buzsakilab/3d_print_designs/README.md

## Visit our website to learn more:
https://buzsakilab.github.io/3d_print_designs/
