buzsakilab/3d_print_designs/Rat_cap/README.md

# Rat cap (v8 / v8_v2_256)

Rat cap design for chronic silicon probe implantation in freely moving rats.

---

## Assembly

Assembly instructions are available in **`assembly_instructions_rat_cap_v8.pdf`** and in this video:  
1. https://www.youtube.com/watch?v=SgM9TPhbf_Y&feature=youtu.be

---

## Printing notes

- The provided `.stl` files are optimized for **Formlabs Form 2** using **Grey v4 / Clear v4 resin**.  
- For other printers and/or resins, minor modifications may be necessary.

---

## Versions included

### **v8**
Files:
- `rat_cap_base_v8`
- `rat_cap_left_wall_v8`
- `rat_cap_right_wall_v8`
- `rat_cap_top_v8`

### **v8_v2_256**
Files:
- `rat_cap_base_v8_v2_256`
- `rat_cap_left_wall_v8_v2_256`
- `rat_cap_right_wall_v8_v2_256`

**Key difference:** v8_v2_256 has a wider base, providing more space for multi-probe implants.

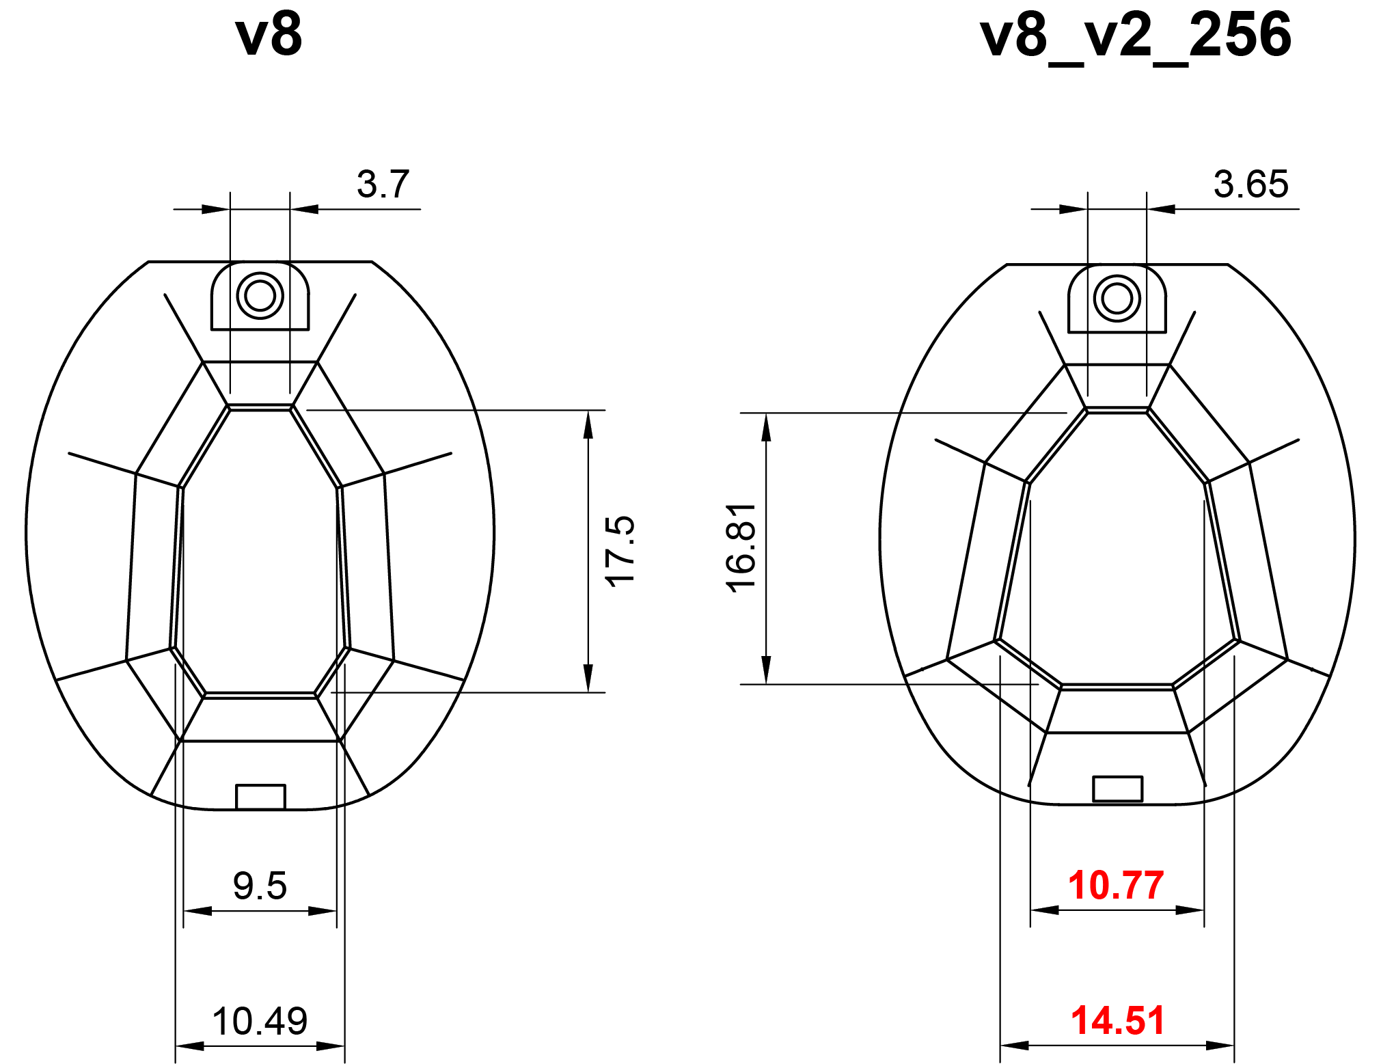
[picture p3: Rat_cap/v8_v2_256/v8_to_v8_v2_256.png]
v8 vs v8_v2_256


---

## Weight

- Fully assembled **v8 cap weight:** **9.39 g**

---

## Citation

If you use this design, please cite:

**Metal microdrive and head cap system for silicon probe recovery in freely moving rodent**  
Mihály Vöröslakos, Peter C. Petersen, Balázs Vöröslakos, György Buzsáki  
https://elifesciences.org/articles/65859

---

## License

Distributed under the **GNU GPLv3** license.
