buzsakilab/3d_print_designs/Rat_cap/README.txt

Rat cap design for silicon probe implantation.

Assembly instructions can be found in the assembly_instructions_rat_cap_v8.pdf file or at this link:
1. https://www.youtube.com/watch?v=SgM9TPhbf_Y&feature=youtu.be

The .stl files are optimized for Formlabs Form2 printer and Grey-v4/Clear-v4 Resin. For other printers and/or resins, some modifications may be necessary.

2 versions are made available here:
v8: rat_cap_base_v8, rat_cap_left_wall_v8, rat_cap_right_wall_v8, rat_cap_top_v8
v8_v2_256: rat_cap_base_v8_v2_256, rat_cap_left_wall_v8_v2_256, rat_cap_right_wall_v8_v2_256

v8 vs v8_v2_256 base comparison

The fully assembled v8 cap weighs 9.39g.

If you use this design, please cite our paper:
Metal microdrive and head cap system for silicon probe recovery in freely moving rodent
Mihály Vöröslakos, Peter C. Petersen, Balázs Vöröslakos, György Buzsáki
https://elifesciences.org/articles/65859

The designs are desitributed under GNU GPLv3 license.
