buzsakilab/3d_print_designs/Rat_hat_base/README.txt

Rat hat base for silicon probe implantation.

Assembly instructions can be found in the Assembly_instructions_rat_base_plate.pdf file. 

The .stl files are optimized for Formlabs Form2 printer and Grey-v4/Clear-v4 Resin. For other printers and/or resins, some modifications may be necessary.

1 version is made available here: hat base for rats.stl

If you use this design, please cite our papers:
Bioprotocol
Peter Christian Petersen,Gyorgy Buzsaki; Cooling of Medial Septum Reveals Theta Phase LagCoordination of Hippocampal Cell Assemblies (Neuron, 2020)

The designs are distributed under GNU GPLv3 license.
