buzsakilab/3d_print_designs/Mouse_cap/README.txt

Mouse cap design for silicon probe implantation.

Assembly instructions can be found in the assembly_instructions_mouse_hat_L11.5mm_W10.00mm_v12.pdf file or at this link:
https://www.youtube.com/watch?v=_MYBLJf-178&feature=youtu.be

The .stl files are optimized for Formlabs Form2 printer and Grey-v4/Clear-v4 Resin. For other printers and/or resins, some modifications may be necessary.

1 version is made available here:
v12: mouse_base_v12, leftWall_v12, rightWall_v12, mouse_hat_copperMesh_cutOut_v02

The fully assembled cap weighs 2.2 g.

If you use this design, please cite our paper:
Metal microdrive and head cap system for silicon probe recovery in freely moving rodent
Mihály Vöröslakos, Peter C. Petersen, Balázs Vöröslakos, György Buzsáki
bioRxiv 2020.12.20.423655; doi: https://doi.org/10.1101/2020.12.20.423655 

The designs are desitributed under GNU GPLv3 license.
