buzsakilab/3d_print_designs/Mouse_cap_with_Head_fixation_capabilities/Kopf_adapter/README.md

# Mouse Cap Design for Silicon Probe Implantation and Head-Fixation

Modified adapter for Kopf Stereotactic Frames. **You need to maintain left and right orientation.**

## Files

**v01:**
- `misi_post_clamp_08_left`
- `misi_post_clamp_08_right`

## License

The designs are distributed under the **GNU GPLv3** license.
