buzsakilab/3d_print_designs/Mouse_head_fixation/spring_multiAngle/README.txt

Mouse head-fixed baseplate design for head-fixation.

The .stl files are optimized for Formlabs Form4 printer and Grey-v5/Clear-v5 Resin. For other printers and/or resins, some modifications may be necessary.

1 version is made available here:
v03: base_cover_spring_multiAngle_v_03, base_holder_spring_multiAngle_v_03, mouse_base_spring_multiAngle_v_03, screw_protector_spring_multiAngle_v_03, stereotax_attachment_spring_multiAngle_v_03

To learn more about the multi-angle alignment tool, read the documentation here: https://github.com/misiVoroslakos/3D_printed_designs/tree/main/Microdrives/Multi_angle_probe_alignment

If you use this design, please cite our paper:
Metal microdrive and head cap system for silicon probe recovery in freely moving rodent
Mihály Vöröslakos, Peter C. Petersen, Balázs Vöröslakos, György Buzsáki
https://elifesciences.org/articles/65859

The designs are desitributed under GNU GPLv3 license.
