buzsakilab/3d_print_designs/Rat_cap/v8_v2_256/README.md

Rat cap design for silicon probe implantation.

**Rat cap v8\_v2\_256 is wider providing more space for multi-probe implants.**

v8 vs v8_v2_256

The designs are desitributed under GNU GPLv3 license.
