buzsakilab/3d_print_designs/Rat_cap/v8/README.md

Rat cap design for silicon probe implantation.

The designs are desitributed under GNU GPLv3 license.
