buzsakilab/3d_print_designs/Microdrives/Metal_recoverable/README.txt

Microdrive designs for silicon probes.

**Assembly instructions**
Assembly instructions can be found in the assembly_instructions_metal_microdrive_v9.pdf file.

To purchase fully assembled drives, contact 3Dneuro (our partner in production) https://www.3dneuro.com/2021/04/23/new-metal-microdrive-in-collaboration-with-the-buzsaki-lab/.
The .step files are optimized for stainless steel 316L, 20 micrometer resolution using Proto Labs (https://www.protolabs.com/). Please see ordering_instructions.txt for more information. 
For other printers, materials or company, some modifications may be necessary.

1 version is made available here:
v9: shell base 3.6 x 4.7 mm (WxL); height: 15 mm; travel distance 7 mm

The .stl files are optimized for Formlabs Form2 printer and Grey-v4/Clear-v4 Resin. For other printers and/or resins, some modifications may be necessary.

1 version is made available here:
v9: stereotax attachment and drive holder.

If you use our designs, please cite our paper:
Metal microdrive and head cap system for silicon probe recovery in freely moving rodent 
Mihály Vöröslakos, Peter C. Petersen, Balázs Vöröslakos, György Buzsáki
doi: https://doi.org/10.1101/2020.12.20.423655 

The original idea of the drive is described in the following paper.

Micro-drive and headgear for chronic implant and recovery of optoelectronic probes Jinho Chung, Farnaz Sharif, Dajung Jung, Soyoun Kim & Sebastien Royer Scientific Reportsvolume 7, Article number: 2773 (2017) doi:10.1038/s41598-017-03340-5 https://www.nature.com/articles/s41598-017-03340-5

The designs are desitributed under GNU GPLv3 license.
