buzsakilab/3d_print_designs/Microdrives/Metal_prototype/README.txt

Microdrive designs for silicon probes.

The .stl files are optimized for Formlabs Form2 printer and Grey-v4/Clear-v4 Resin. For other printers and/or resins, some modifications may be necessary.

1 version is made available here:

This microdrive was modified based on Mihaly Voroslakos' design. Other version of this microdrive is available at https://github.com/buzsakilab/3d_print_designs/tree/master/Microdrives/Plastic_recoverable.

The original idea of the drive is described in the following paper.

Micro-drive and headgear for chronic implant and recovery of optoelectronic probes Jinho Chung, Farnaz Sharif, Dajung Jung, Soyoun Kim & Sebastien Royer Scientific Reportsvolume 7, Article number: 2773 (2017) doi:10.1038/s41598-017-03340-5 https://www.nature.com/articles/s41598-017-03340-5

The designs are distributed under GNU GPLv3 license.
