buzsakilab/3d_print_designs/Microdrives/Metal_recoverable/v10_long_arm/README.md

Metal microdrive designs for silicon probes (**v10 is not back compatible with previous versions**).

**Microdrive Shuttle for Rat surgeries**

Sometimes we need to reach deeper than 7 mm using a Neuropixels probe. **arm_v10_long** provides a solution to achieve this. 

Details on the issue and its implemented solution can be found [here](https://github.com/buzsakilab/3d_print_designs/blob/f796568ae8a014a6d27565d4a83c3a5d85d17292/Microdrives/Metal_recoverable/v10_long_arm/Long_arm_rats_NPX.pdf).

**ASSEMBLY**

Assembly instructions can be found in the **assembly_instructions_metal_microdrive_v10.pdf** file. Assembly video can be found here: https://www.youtube.com/watch?v=poEjWvFrr5g. 
Attaching Neuropixels probe (or any other silicon probe) video can be found here: https://www.youtube.com/watch?v=MpPdWJEo7Fo

**ORDERING**

The .step files are optimized for stainless steel 316L, 20 micrometer resolution (drive_v10) and aluminum AlSi10Mg, high resolution (arm_v10, arm_v10_long and base_v10) using Proto Labs (https://www.protolabs.com/). Please see *ordering_instructions.txt* for more information [here](https://github.com/buzsakilab/3d_print_designs/blob/3e0a6fe3e2badeac6823770685a77d362df59636/Microdrives/Metal_recoverable/Ordering_instructions.txt). 
For other printers, materials or company, some modifications may be necessary.

**PURCHASING fully assembled microdrives**

To purchase fully assembled drives, contact 3Dneuro (our partner in production) (https://www.3dneuro.com/).

**SPECIFICATIONS**

1 version is made available here:
v10: shell base 3.6 x 4.7 mm (WxL); height: 15 mm; travel distance 7 mm

The .stl files are optimized for Formlabs Form2 printer and Grey-v4/Clear-v4 Resin. For other printers and/or resins, some modifications may be necessary.

2 version is made available here:

v9: stereotax attachment and drive holder.
v10: stereotax attachment and drive holder.

**CITATION**

If you use our designs, please cite our paper:
Metal microdrive and head cap system for silicon probe recovery in freely moving rodent 
Mihály Vöröslakos, Peter C. Petersen, Balázs Vöröslakos, György Buzsáki https://doi.org/10.7554/eLife.65859

The original idea of the drive is described in the following paper.

Micro-drive and headgear for chronic implant and recovery of optoelectronic probes Jinho Chung, Farnaz Sharif, Dajung Jung, Soyoun Kim & Sebastien Royer Scientific Reportsvolume 7, Article number: 2773 (2017) doi:10.1038/s41598-017-03340-5 https://www.nature.com/articles/s41598-017-03340-5

Copyright 2018-2024 New York University. All Rights Reserved.
 
A license to use and copy these materials solely for your internal non-commercial research and evaluation purposes, without fee and without a signed licensing agreement, is hereby granted upon your download of the materials, through which you agree to the following: 1) the above copyright notice, this paragraph and the following three paragraphs will prominently appear in all internal copies and modifications; 2) no rights to sublicense or further distribute these materials are granted; 3) no rights to modify these materials are granted; and 4) no rights to assign this license are granted. Please contact NYU Technology Opportunities & Ventures at innovations@nyulangone.org for commercial licensing opportunities, or for further distribution, modification or license rights.

Created by M. Voroslakos and P. Petersen. 
 
IN NO EVENT SHALL NYU, OR THEIR EMPLOYEES, OFFICERS, AGENTS OR TRUSTEES  (COLLECTIVELY "NYU PARTIES") BE LIABLE TO ANY PARTY FOR DIRECT, INDIRECT, SPECIAL, INCIDENTAL, OR CONSEQUENTIAL DAMAGES OF ANY KIND, INCLUDING LOST PROFITS, ARISING OUT OF ANY CLAIM RESULTING FROM YOUR USE OF THESE MATERIALS, EVEN IF ANY OF NYU PARTIES HAS BEEN ADVISED OF THE POSSIBILITY OF SUCH CLAIM OR DAMAGE. 

NYU SPECIFICALLY DISCLAIMS ANY WARRANTIES OF ANY KIND REGARDING THESE MATERIALS, INCLUDING, BUT NOT LIMITED TO, NON-INFRINGEMENT, THE IMPLIED WARRANTIES OF MERCHANTABILITY AND FITNESS FOR A PARTICULAR PURPOSE, OR THE ACCURACY OR USEFULNESS, OR COMPLETENESS OF THE MATERIALS. THE MATERIALS ARE PROVIDED HEREUNDER ARE PROVIDED COMPLETELY "AS IS". NYU HAS NO OBLIGATION TO PROVIDE FURTHER DOCUMENTATION, MAINTENANCE, SUPPORT, UPDATES, ENHANCEMENTS, OR MODIFICATIONS.
