buzsakilab/3d_print_designs/docs/index.md

---
layout: default
title: Home
nav_order: 1
has_children: false
---

# Metal microdrive and head cap system
{: .no_toc}
{: .fs-9 }

We have designed a metal microdrive and head cap systems for extracellular recordings in freely moving rodents, which make sillicon probes recoverable and reusable.
{: .fs-6 .fw-300}

[Get started now](#getting-started){: .btn .btn-primary .fs-5 .mb-4 .mb-md-0 .mr-2} [View code on GitHub](https://github.com/buzsakilab/3d_print_designs){: .btn .fs-5 .mb-4 .mb-md-0}

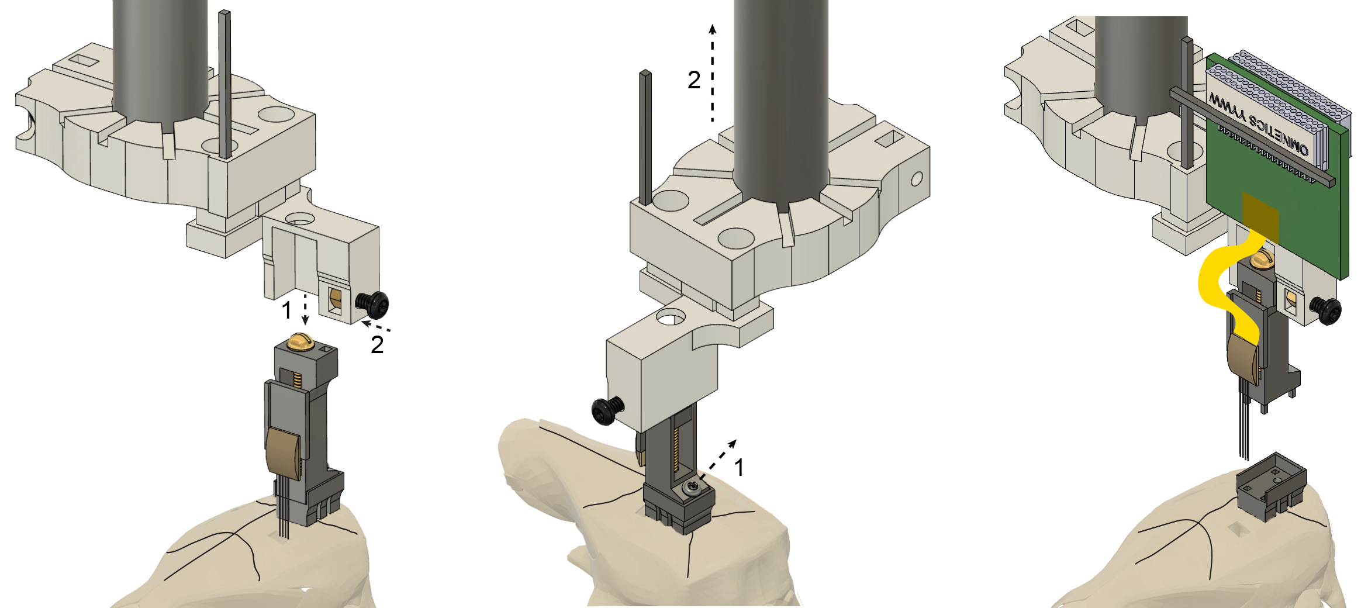
[picture p4: docs/images/recoverable_microdrive.jpg]
Recoverable microdrive


### Summary
High-yield electrophysiological extracellular recording in freely moving rodents provides a unique window into the temporal dynamics of neural circuits. Recording from unrestrained animals is critical to investigate brain activity during natural behaviors. The use and implantation of high-channel-count silicon probes represent the largest cost and experimental complexity associated with such recordings making a recoverable and reusable system desirable. To address this, we have designed and tested a novel 3D printed head-gear system for freely moving mice and rats. The system consists of a recoverable microdrive printed in stainless steel and a plastic head cap system, allowing researchers to reuse the silicon probes with ease, decreasing the effective cost, and the experimental effort and complexity. The cap designs are modular and provide structural protection and electrical shielding to the implanted hardware and electronics. We provide detailed procedural instructions allowing researchers to adapt and flexibly modify the head-gear system.

## Getting started
We have created dedicated pages for the three elements below with detailed procedural instructions and links to resources for each of them. 

[Microdrives]({{"/microdrives/microdrives/"|absolute_url}}){: .btn .fs-5 .mb-4 .mb-md-0 .mr-4} [Rat cap]({{"/capsystems/rat_cap/"|absolute_url}}){: .btn .fs-5 .mb-4 .mb-md-0 .mr-4} [Mouse cap]({{"/capsystems/mouse_cap/"|absolute_url}}){: .btn .fs-5 .mb-4 .mb-md-0 .mr-4}

## Support
Please use the [GitHub issues system](https://github.com/buzsakilab/3d_print_designs/issues) for reporting bugs, enhancement requests or general questions.

## Citing our 3D designs in research and publications
If you use our designs, please cite our paper: 
Metal microdrive and head cap system for silicon probe recovery in freely moving rodent Mihály Vöröslakos, Peter C. Petersen, Balázs Vöröslakos, György Buzsáki doi: [doi.org/10.1101/2020.12.20.423655](https://doi.org/10.1101/2020.12.20.423655)
