buzsakilab/3d_print_designs/docs/capsystems/mouse_cap.md

---
layout: default
title: Mouse cap
parent: Cap systems
nav_order: 1
---

# Mouse cap system
{: .no_toc}
Mouse cap design for silicon probe implantation. The fully assembled cap weighs 2.2 g.

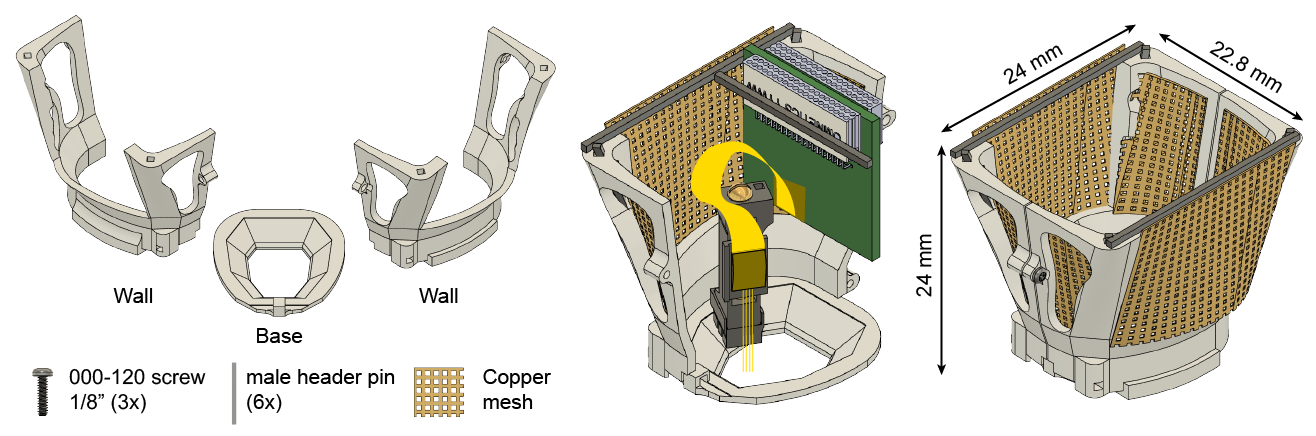
[picture p5: docs/images/mouse_cap.png]
Mouse cap system


## Table of contents
{: .no_toc .text-delta }

1. TOC
{:toc}

## Printing and assembly instructions 
Download stl files from our [GitHub repository](https://github.com/buzsakilab/3d_print_designs/tree/master/Mouse_cap). The stl files are optimized for Formlabs Form2 printer and Grey-v4/Clear-v4 Resin. For other printers and/or resins, some modifications may be necessary.

See video below. Detailed assembly instructions are available for the [cap system](https://github.com/buzsakilab/3d_print_designs/raw/master/Mouse_cap/assembly_instructions_mouse_hat_L11.5mm_W10.00mm_v12.pdf).

<video width="100%" height="auto" controls="controls">
  <source src="https://buzsakilab.com/3d_print_designs/Figure2-video1.mp4" type="video/mp4">
</video>

The assembly video is also available on [youtube](https://www.youtube.com/watch?v=_MYBLJf-178).

## Materials

__Mouse cap v11__

| Qty | Name | Vendor | Item number/Link |
|-----|---|---|---|
| 3 | 000-120 screw 1/8" | McMaster | [96710A001](https://www.mcmaster.com/96710A001/) | 
| 1 | male header pin | DigiKey | [SAM1067-40-ND](https://www.digikey.com/products/en?keywords=SAM1067-40-ND) | 
| | copper mesh | Dexmet | 3CU6-050FA | 
| 1 | Coban | 3M | [7100219100](https://www.3m.com/3M/en_US/company-us/all-3m-products/~/3M-Coban-Self-Adherent-Wrap-1583N-Neon-Rainbow-Pack-3-Inches-x-5-Yards-12-Bags-Case/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) | 

__Additional tools__

| Qty | Name | Vendor | Item number/Link | Notes |
|-----|---|---|---|---|
| 1 | T1 screwdriver | McMaster | [52995A3](https://www.mcmaster.com/52995a31) | 
| 1 | 000-120 tap | McMaster | [2504A15](https://www.mcmaster.com/2504a15)  | Or similar tap. | 

__Additional chemicals__

| Qty | Name | Vendor | Item number/Link | Notes |
|-----|---|---|---|---|
| 1 | Cyanoacrylate glue | Loctite | [45208](https://www.loctiteproducts.com/en/products/fix/super-glue/loctite_super_glueultragelcontrol.html) | Gel control | 
| 1 | Unifast Trad Ivory | Pearson Dental | G05-1224 | 
| 1 | Unifast Trad Liquid | Pearson Dental | G05-0037 | 
| 1 | Soldering iron | Stannol | 574104 | 
| 1 | Solder Paste | Quick Chip | 23271700 | 

## Stl files
All stl files are available for download from our [GitHub repository](https://github.com/buzsakilab/3d_print_designs/tree/master/Mouse_cap/stl_files). 

### Mouse cap base

<script src="https://embed.github.com/view/3d/buzsakilab/3d_print_designs/master/Mouse_cap/stl_files/mouse_base_v12_L11.5mm_W10.00mm.stl"></script>

### Left wall

<script src="https://embed.github.com/view/3d/buzsakilab/3d_print_designs/master/Mouse_cap/stl_files/left_wall_v12_L11.5mm_W10.00mm.stl"></script>

### Right wall

<script src="https://embed.github.com/view/3d/buzsakilab/3d_print_designs/master/Mouse_cap/stl_files/right_wall_v12_L11.5mm_W10.00mm.stl"></script>

### Copper mesh cut-out

<script src="https://embed.github.com/view/3d/buzsakilab/3d_print_designs/master/Mouse_cap/stl_files/mouse_hat_copperMesh_cutOut_v02.stl"></script>

## Citations
If you use our designs, please cite our paper: 
Metal microdrive and head cap system for silicon probe recovery in freely moving rodent Mihály Vöröslakos, Peter C. Petersen, Balázs Vöröslakos, György Buzsáki doi: [doi.org/10.1101/2020.12.20.423655](https://doi.org/10.1101/2020.12.20.423655)

The designs are distributed under GNU GPLv3 license.
