buzsakilab/3d_print_designs/docs/capsystems/rat_cap.md

---
layout: default
title: Rat cap
parent: Cap systems
nav_order: 2
---

# Rat cap system
{: .no_toc}
Rat cap design for silicon probe implantation. The fully assembled cap weighs 9.39g.

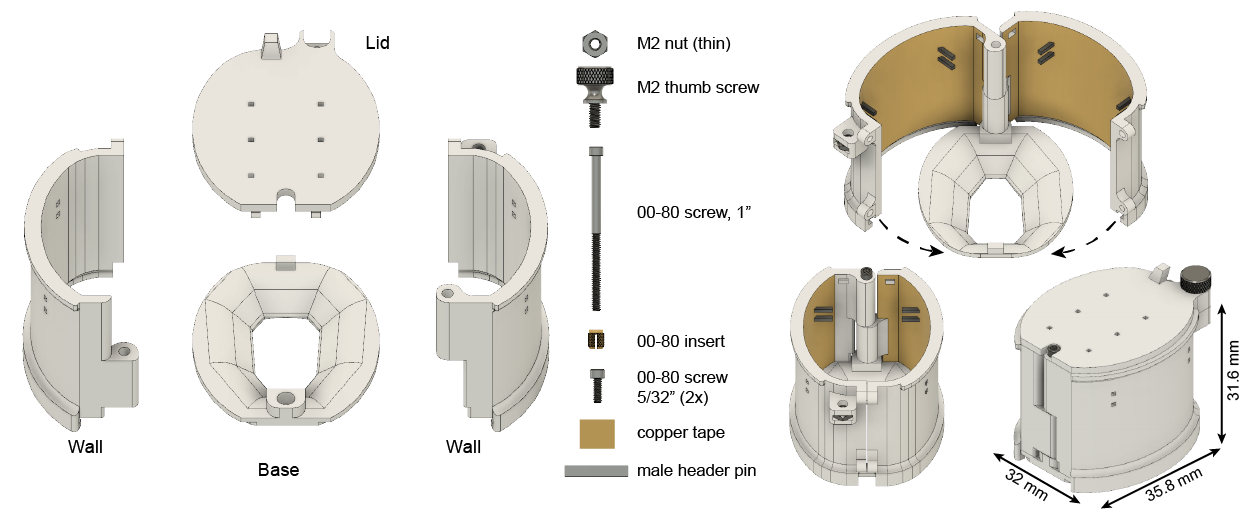
[picture p6: docs/images/rat_cap.png]
Rat cap


## Table of contents
{: .no_toc .text-delta }

1. TOC
{:toc}

## Printing and assembly instructions 
Download stl files from our [GitHub repository](https://github.com/buzsakilab/3d_print_designs/tree/master/Rat_cap). The .stl files are optimized for Formlabs Form2 printer and Grey-v4/Clear-v4 Resin. For other printers and/or resins, some modifications may be necessary.

See video below. Detailed assembly instructions are available for the [cap system](https://github.com/buzsakilab/3d_print_designs/raw/master/Rat_cap/assembly_instructions_rat_cap_v8.pdf).

<video width="100%" height="auto" controls="controls">
  <source src="https://buzsakilab.com/3d_print_designs/Figure3-video1.mp4" type="video/mp4">
</video>

The assembly video is also available on [youtube](https://www.youtube.com/watch?v=SgM9TPhbf_Y).

## Materials

__Rat cap v08__

| Qty | Name | Vendor | Item number/Link |
|-----|---|---|---|
| 1 | 00-80 screw 1" | McMaster | [92196A060](https://www.mcmaster.com/92196a060) | 
| 1 | 00-80 brass insert | McMaster | [92395A109](https://www.mcmaster.com/92395a109) | 
| 2 | 00-80 screw 5/32"  | McMaster | [92196A053](https://www.mcmaster.com/92196a053) | 
| 1 | male header pin | DigiKey | [SAM1067-40-ND](https://www.digikey.com/products/en?keywords=SAM1067-40-ND) | 
| 1 | copper tape | McMaster | [76555A724](https://www.mcmaster.com/76555A724/) | 
| 1 | Coban | 3M | [7100219100](https://www.3m.com/3M/en_US/company-us/all-3m-products/~/3M-Coban-Self-Adherent-Wrap-1583N-Neon-Rainbow-Pack-3-Inches-x-5-Yards-12-Bags-Case/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) | 

__Optional lid (to close cap for extended period of time)__

| Qty | Name | Vendor | Item number/Link |
|-----|---|---|---|
| 1 | M2x0.4 Thumb screw | McMaster | [99607A256](https://www.mcmaster.com/99607a256) | 
| 1 | M2x0.4 THIN nut | McMaster | [93935A305](https://www.mcmaster.com/93935a305) | 

__Additional tools__

| Qty | Name | Vendor | Item number/Link |
|-----|---|---|---|
| 1 | 00-80 tap | McMaster | [2523A461](https://www.mcmaster.com/2523a461) | 
| 1 | 0.05" hex key | 

## Stl files
All stl files are available for download from our [GitHub repository](https://github.com/buzsakilab/3d_print_designs/tree/master/Rat_cap/stl_files). 

### Rat cap base

<script src="https://embed.github.com/view/3d/buzsakilab/3d_print_designs/master/Rat_cap/stl_files/rat_cap_base_v8.stl"></script>

### Left wall

<script src="https://embed.github.com/view/3d/buzsakilab/3d_print_designs/master/Rat_cap/stl_files/rat_cap_left_wall_v8.stl"></script>

### Right wall

<script src="https://embed.github.com/view/3d/buzsakilab/3d_print_designs/master/Rat_cap/stl_files/rat_cap_right_wall_v8.stl"></script>

### Lid

<script src="https://embed.github.com/view/3d/buzsakilab/3d_print_designs/master/Rat_cap/stl_files/rat_cap_top_v8.stl"></script>

## Citations
If you use our designs, please cite our paper: 
Metal microdrive and head cap system for silicon probe recovery in freely moving rodent Mihály Vöröslakos, Peter C. Petersen, Balázs Vöröslakos, György Buzsáki doi: [doi.org/10.1101/2020.12.20.423655](https://doi.org/10.1101/2020.12.20.423655)

The designs are distributed under GNU GPLv3 license.
