buzsakilab/3d_print_designs/docs/microdrives/plastic-microdrive.md

---
layout: default
title: Plastic microdrive
parent: Microdrives
nav_order: 2
---

# Recoverable plastic microdrive
{: .no_toc}
Plastic microdrive for silicon probe recordings. Below are necessary design files and detailed instructions for printing and assembling the microdrives yourself. height: 16 mm; travel distance 4.8 mm

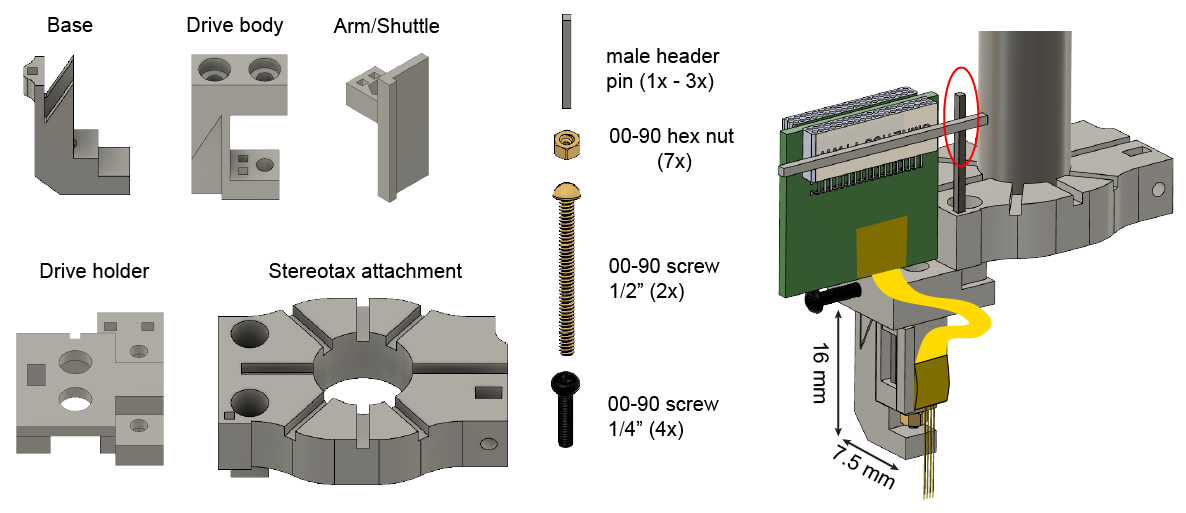
[picture p7: docs/images/plastic_microdrives.png]
Recoverable plastic microdrive


## Table of contents
{: .no_toc .text-delta }

1. TOC
{:toc}

## Printing and assembly instructions 
Download stl files from our [GitHub repository](https://github.com/buzsakilab/3d_print_designs/tree/master/Microdrives/Plastic_recoverable). The stl files are optimized for Formlabs Form2 printer and Grey-v4/Clear-v4 Resin. For other printers and/or resins, some modifications may be necessary.

Below links are youtube videos with instructions:

1. [Microdrive assembly](https://youtu.be/rjxaH515N64)
2. [Probe attachment to microdrive](https://youtu.be/2L5RHcbsU7o)
3. [Probe recovery](https://youtu.be/T5gyuZVKXo8)

Detailed [assembly instructions](https://github.com/buzsakilab/3d_print_designs/raw/master/Microdrives/Plastic_recoverable/assembly_instructions_rat1-2inch_v21.pdf) are available for the microdrive.

## Materials

__Plastic microdrive v21 (1/2")__

| Qty | Name | Vendor | Item number/Link |
|-----|---|---|---|
| 7 | 00-90 nut | McMaster | [92736A112](https://www.mcmaster.com/92736a112) |
| 2 | 00-90 screw 1/2" | McMaster | [92482A235](https://www.mcmaster.com/92482a235) |
| 4 | 00-90 screw 1/4" | McMaster | [93701A005](https://www.mcmaster.com/93701a005) |
| 1 | male header pin | DigiKey | [SAM1067-40-ND](https://www.digikey.com/products/en?keywords=SAM1067-40-ND) |

__Additional tools__

| Qty | Name | Vendor | Item number/Link | Notes |
|-----|---|---|---|---|
| 1 | T2 screwdriver | McMaster | [52995A31](https://www.mcmaster.com/52995a31) | Only T2 is necessary! |
| 1 | 00-90 Tap | McMaster | [2504A14](https://www.amazon.com/) | Or similar 00-90 tap |
| 1 | 1.2 mm drill bit | McMaster | [2958A29](https://www.mcmaster.com/2958a29) | Or similar drill bit |

## Citations
This microdrive was modified based on Hiroyuki Miyawaki's design. The latest version of their microdrive is available [here](https://github.com/Mizuseki-Lab/microdrive).

The original idea of the drive is described in the following paper:

Micro-drive and headgear for chronic implant and recovery of optoelectronic probes Jinho Chung, Farnaz Sharif, Dajung Jung, Soyoun Kim & Sebastien Royer Scientific Reportsvolume 7, Article number: 2773 (2017) doi:10.1038/s41598-017-03340-5 [https://www.nature.com/articles/s41598-017-03340-5](https://www.nature.com/articles/s41598-017-03340-5)

The designs are distributed under GNU GPLv3 license.
