buzsakilab/3d_print_designs/docs/rodent_models/rodent-models.md

---
layout: default
title: Rodent models
nav_order: 2
---
# Rodent models
{: .no_toc}
3d Rat and mouse skull models made by third parties.

## Rat skull model
Rat skull by Mieke Roth - [download here](https://github.com/buzsakilab/3d_print_designs/tree/master/Rodent_models).

<script src="https://embed.github.com/view/3d/buzsakilab/3d_print_designs/master/Rodent_models/RatSkull.stl"></script>

## Mouse skull model
Mouse skull - [download here](https://github.com/buzsakilab/3d_print_designs/tree/master/Rodent_models).

<script src="https://embed.github.com/view/3d/buzsakilab/3d_print_designs/master/Rodent_models/MouseSkull.stl"></script>
