buzsakilab/3d_print_designs/docs/rodent_models/rodent-skulls.md

---
layout: default
title: Rodent skulls
parent: Rodent models
nav_order: 1
---

# Rodent skull models
{: .no_toc}

## Rat skull model
Rat skull by Mieke Roth. 

<script src="https://embed.github.com/view/3d/buzsakilab/3d_print_designs/master/Rodent_models/RatSkull.stl"></script>

## Mouse skull model

<script src="https://embed.github.com/view/3d/buzsakilab/3d_print_designs/master/Rodent_models/MouseSkull.stl"></script>
