buzsakilab/3d_print_designs/Microdrives/Metal_recoverable/v10_long_arm/Long_arm_rats_NPX.pdf

# Long arm metal microdrive

Misi Voroslakos
2026. 10. 19.

## Issue with current design

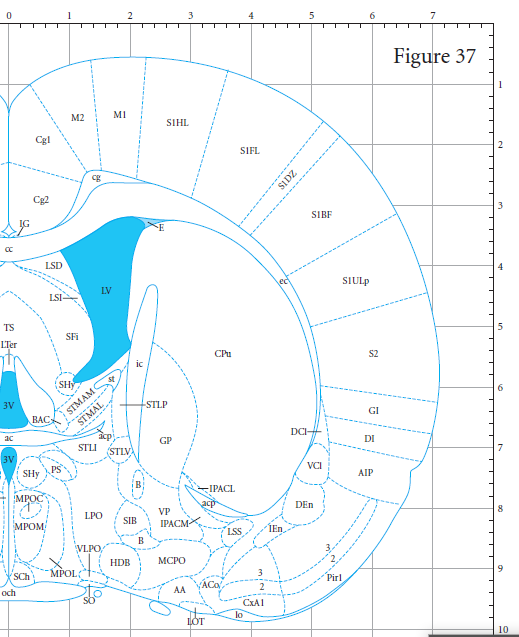
[picture p8: figure]

- NPX probe’s shank is 10 mm
- Rat brain is ~9-10 mm in DV
- We need space for the skull
- 1-2 mm
- Deep targets cannot be reached.

## Skull issue explained

- This issue is more pronounced if probe is implanted with an angle.
- We also lose top recording channels capability as it can never reach the brain.
Skull: 1-2 mm

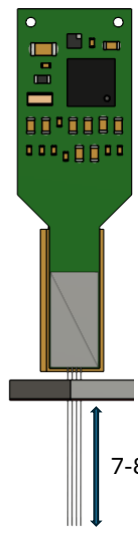
[picture p9: figure]

7-8 mm from surface of the brain

## Solution

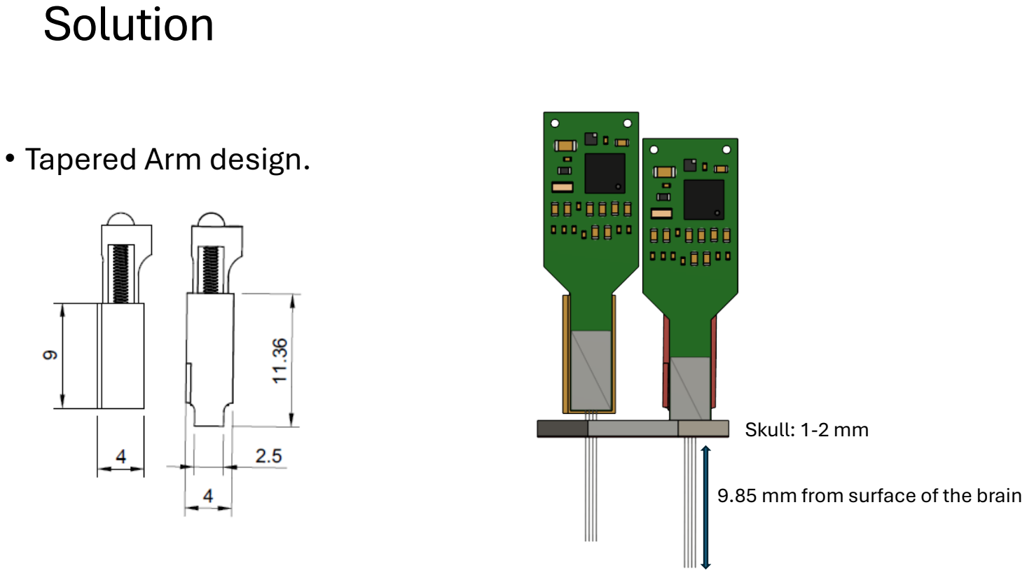
[picture p10: page 4]

Skull: 1-2 mm

9.85 mm from surface of the brain

- Tapered Arm design.

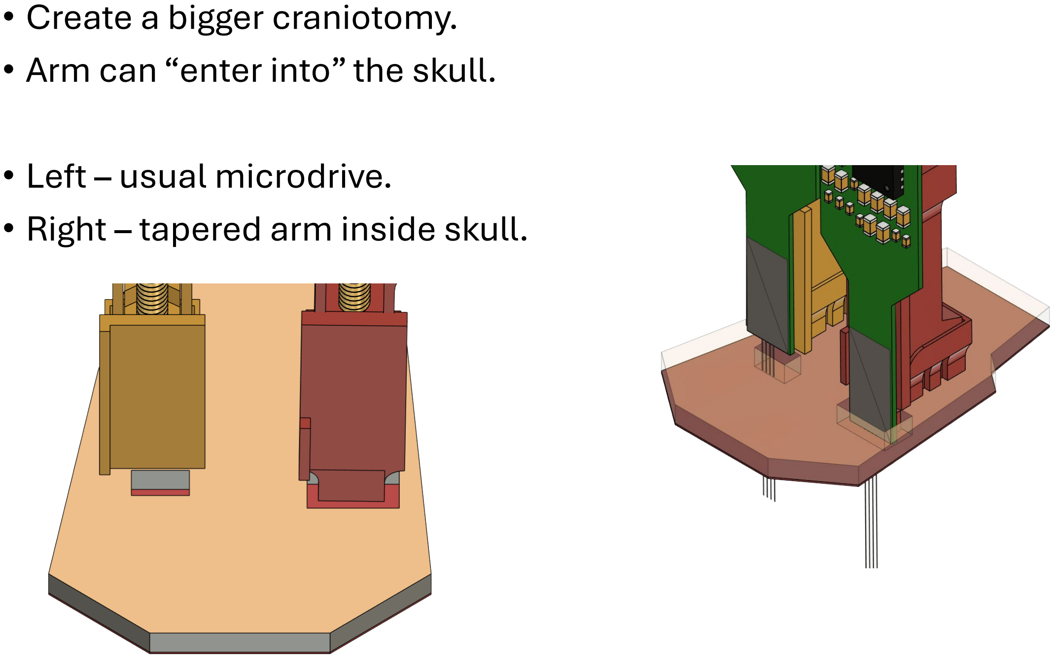
[picture p11: page 5]

- Create a bigger craniotomy.
- Arm can “enter into” the skull.
- Left – usual microdrive.
- Right – tapered arm inside skull.

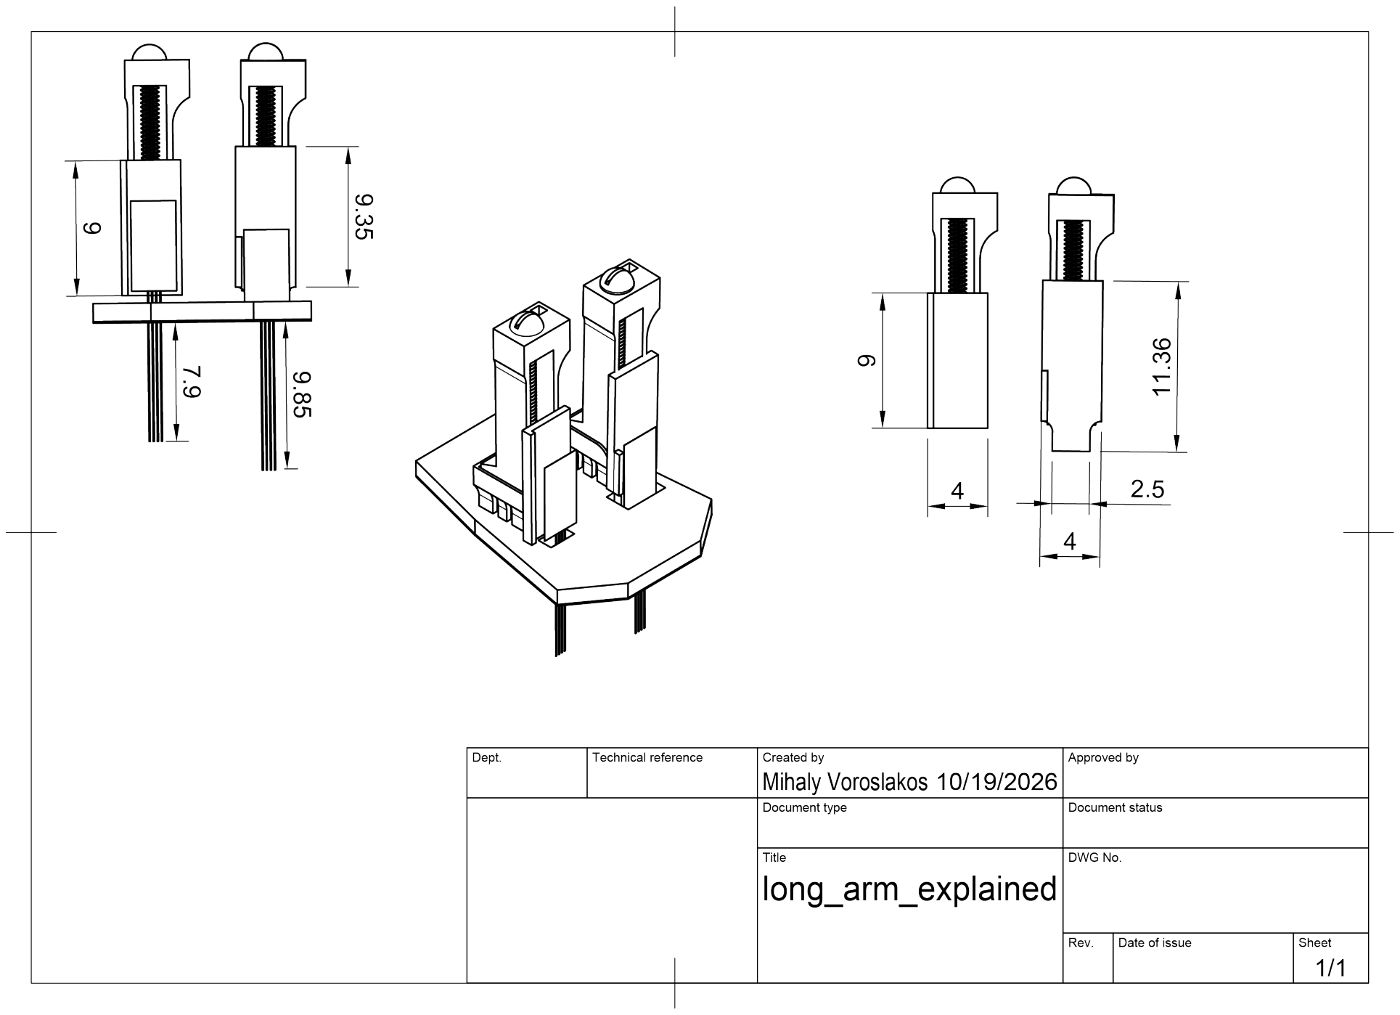
[picture p12: page 6]
