buzsakilab/3d_print_designs/Microdrives/Metal_recoverable/BOM_metal_microdrive_v10.txt

Metal microdrive v10 (1/2")					
			
Qty	Name			Vendor		Item number	Notes			Link
					
4	00-90 nut		McMaster	92736A112				https://www.mcmaster.com/92736a112
1	00-90 screw 1/2" 	McMaster	92482A235				https://www.mcmaster.com/92482a235
3	00-90 screw 1/4"	McMaster	93701A005				https://www.mcmaster.com/93701A005/
1	2-56 nylon screw 1/4"	McMaster	95868A132				https://www.mcmaster.com/95868A132/
1	000-120 screw 1/8" 	McMaster	90910A600				https://www.mcmaster.com/93701a005
1-3	male header pin		DigiKey		SAM1067-40-ND				https://www.digikey.com/products/en?keywords=SAM1067-40-ND

Additional tools				
1	T2 screwdriver		McMaster	52995A31				https://www.mcmaster.com/52995a31
1	T1 screwdriver		McMaster	52995A31				https://www.mcmaster.com/52995a31
1	00-90 Tap 		McMaster	2504A14		Or similar 00-90 tap.	https://www.mcmaster.com/2504A14/
1	000-120 Tap		McMaster	2504A12		Or similar 000-120 tap.	https://www.mcmaster.com/2504A12/
1	2-56 Tap		McMaster	2522A713	Or similar 2-56 tap.	https://www.mcmaster.com/2522A713/
1	Ball-End 		McMaster	5497A24					https://www.mcmaster.com/5497A24/
	Hex Screwdriver
1	1.2 mm drill bit	McMaster	2958A29		Or similar drill bit. 	https://www.mcmaster.com/2958a29
