buzsakilab/3d_print_designs/LED_bar_mount/magnet mounts v3 holder.stl

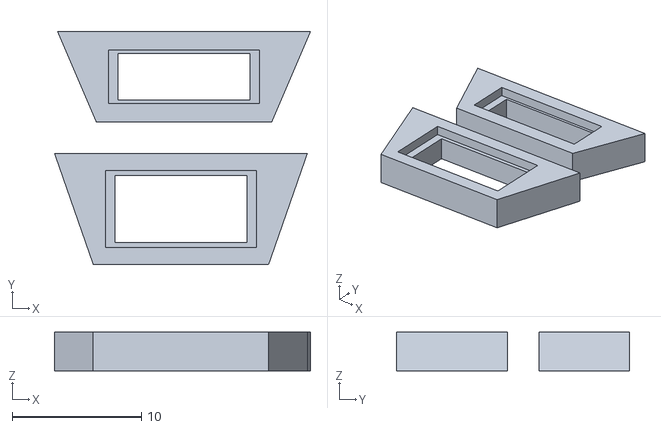
[picture p13: CAD file, 2017-07-04]
LED_bar_mount/magnet mounts v3 holder.stl
19.8 x 18.0 x 3.00
