buzsakilab/3d_print_designs/Microdrives/Antonio/stl_files/smallDrive_12mm.stl

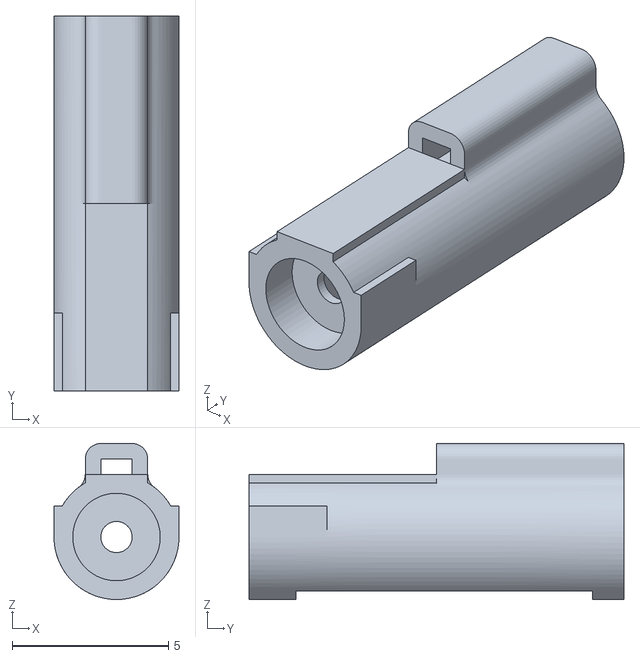
[picture p14: CAD file, 2020-12-21]
Microdrives/Antonio/stl_files/smallDrive_12mm.stl
4.00 x 12.0 x 4.99
