buzsakilab/3d_print_designs/Microdrives/Metal_prototype/base_metal_prototype.stl

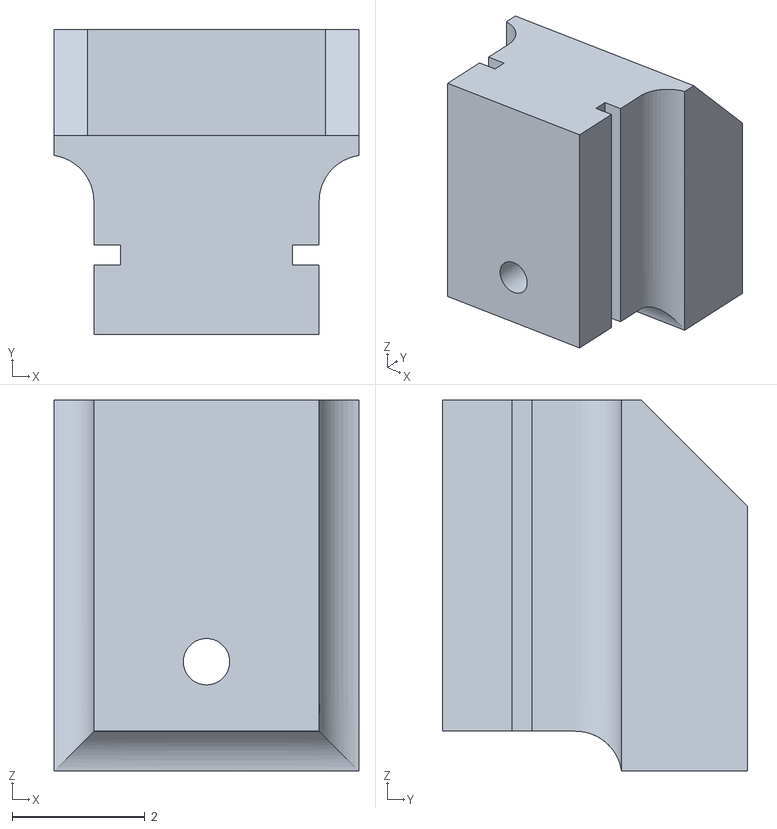
[picture p15: CAD file, 2021-02-21]
Microdrives/Metal_prototype/base_metal_prototype.stl
4.60 x 4.60 x 5.60
