buzsakilab/3d_print_designs/Microdrives/Metal_recoverable/Drive_holder_variations/step_files/arm_neg100um_wneg10um_noNut_aluminum_v10.step

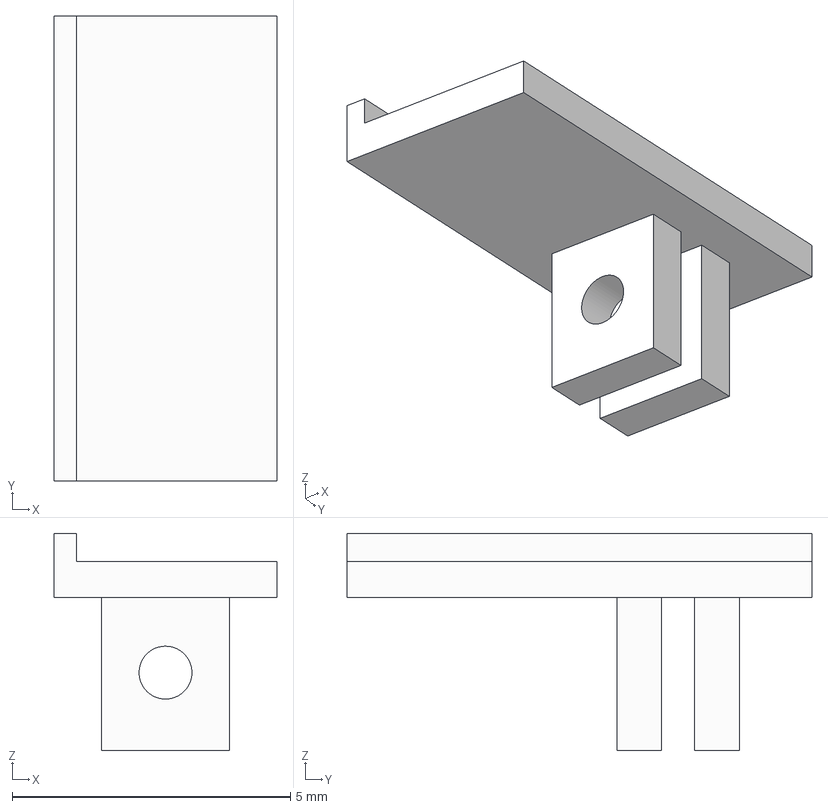
[picture p16: CAD file, 2021-06-20]
Microdrives/Metal_recoverable/Drive_holder_variations/step_files/arm_neg100um_wneg10um_noNut_aluminum_v10.step
4.00 x 8.35 x 3.90 mm
