buzsakilab/3d_print_designs/Microdrives/Metal_recoverable/Drive_holder_variations/stl_files/stereotax_attachment_metal_drive_v10.stl

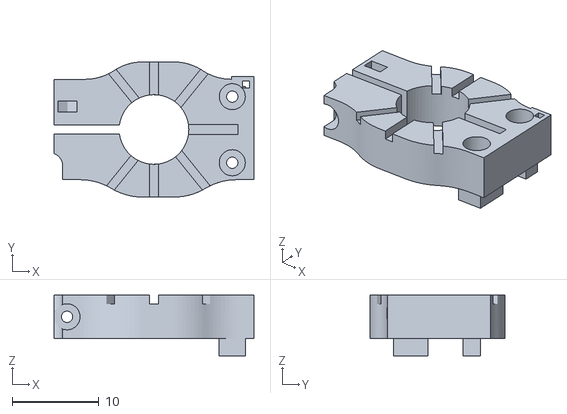
[picture p17: CAD file, 2021-06-20]
Microdrives/Metal_recoverable/Drive_holder_variations/stl_files/stereotax_attachment_metal_drive_v10.stl
23.0 x 15.6 x 7.00
