buzsakilab/3d_print_designs/Microdrives/Metal_recoverable/v10/step_files/arm_v10_aluminum_NP1.0.step

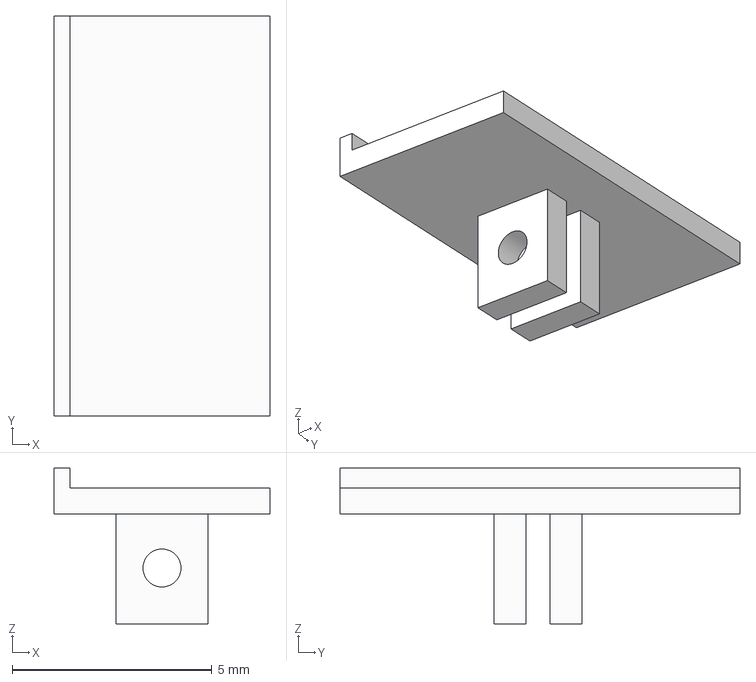
[picture p18: CAD file, 2022-03-03]
Microdrives/Metal_recoverable/v10/step_files/arm_v10_aluminum_NP1.0.step
5.40 x 10.0 x 3.90 mm
