buzsakilab/3d_print_designs/Microdrives/Metal_recoverable/v10_long_arm/step_files/arm_v10_long.step

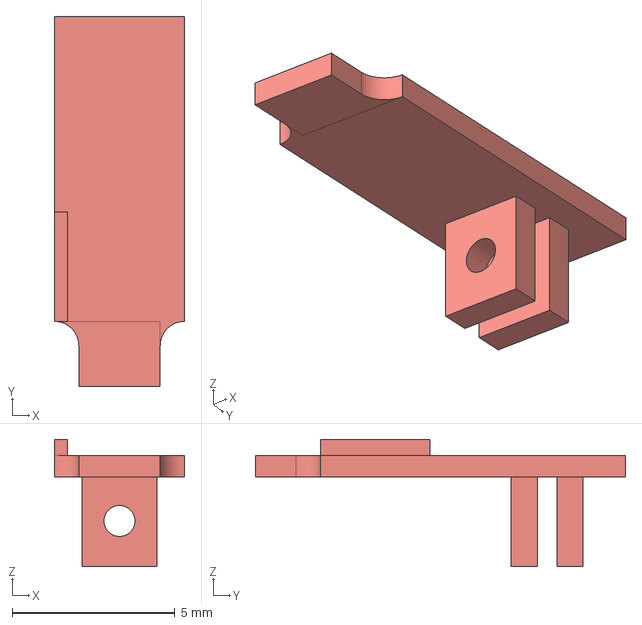
[picture p19: CAD file, 2026-10-20]
Microdrives/Metal_recoverable/v10_long_arm/step_files/arm_v10_long.step
4.00 x 11.3 x 3.90 mm
