buzsakilab/3d_print_designs/Microdrives/Plastic_recoverable/stl_files/arm_32ch_v21.stl

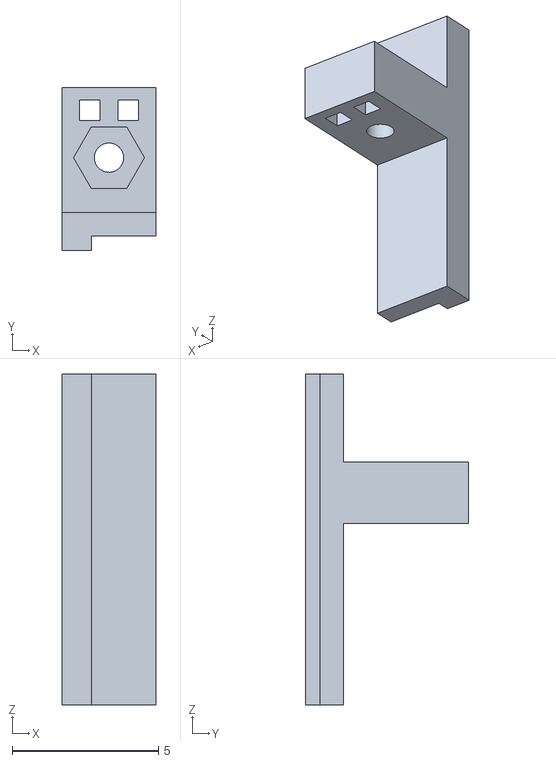
[picture p20: CAD file, 2020-12-21]
Microdrives/Plastic_recoverable/stl_files/arm_32ch_v21.stl
3.20 x 5.57 x 11.3
