buzsakilab/3d_print_designs/Mouse_cap/stl_files/left_wall_v12_L11.5mm_W10.00mm.stl

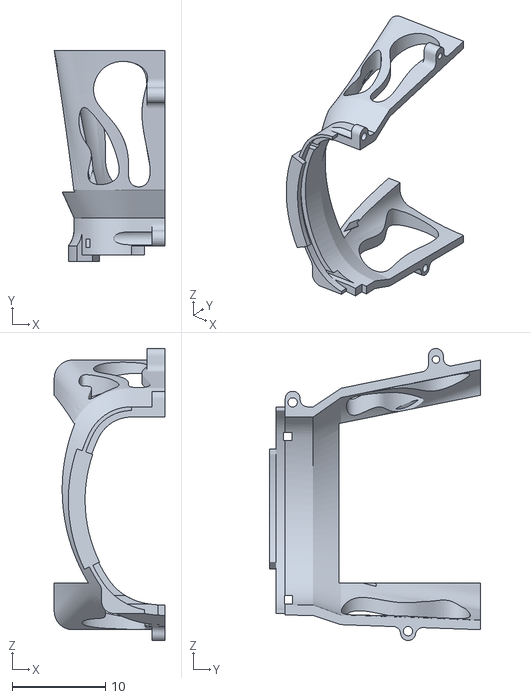
[picture p21: CAD file, 2021-02-22]
Mouse_cap/stl_files/left_wall_v12_L11.5mm_W10.00mm.stl
11.9 x 22.7 x 31.4
