buzsakilab/3d_print_designs/Mouse_cap_with_Head_fixation_capabilities/Kopf_adapter/misi_post_clamp_08_right.stl

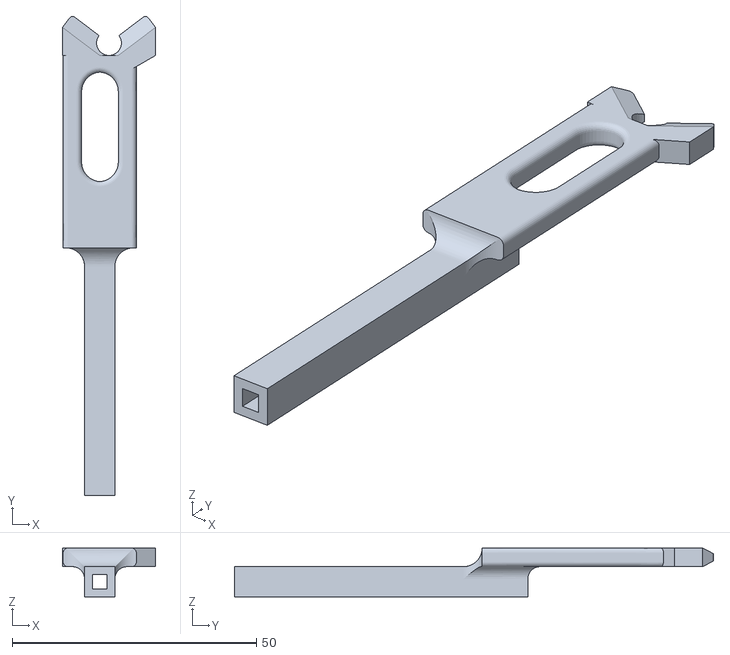
[picture p22: CAD file, 2026-08-05]
Mouse_cap_with_Head_fixation_capabilities/Kopf_adapter/misi_post_clamp_08_right.stl
19.0 x 98.0 x 10.0
