buzsakilab/3d_print_designs/Mouse_cap_with_Head_fixation_capabilities/right_clamp_head_fixed_silicon_probe_combined_v01.stl

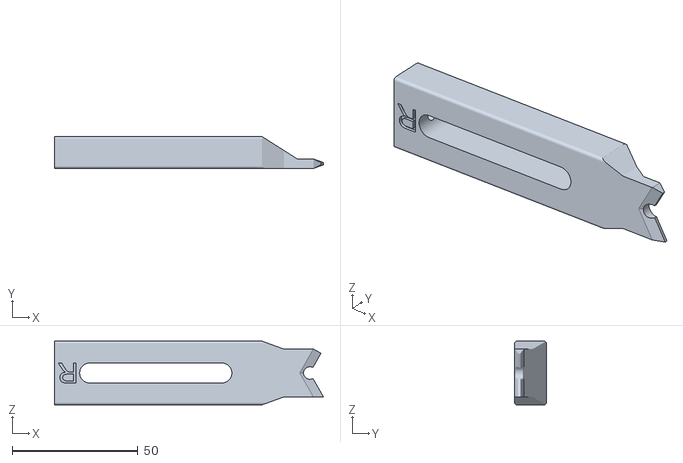
[picture p23: CAD file, 2026-08-05]
Mouse_cap_with_Head_fixation_capabilities/right_clamp_head_fixed_silicon_probe_combined_v01.stl
107.0 x 12.7 x 25.4
