buzsakilab/3d_print_designs/Mouse_cap_with_Head_fixation_capabilities/step_files/mouse_base_head_fixed_silicon_probe_combined_v01.step

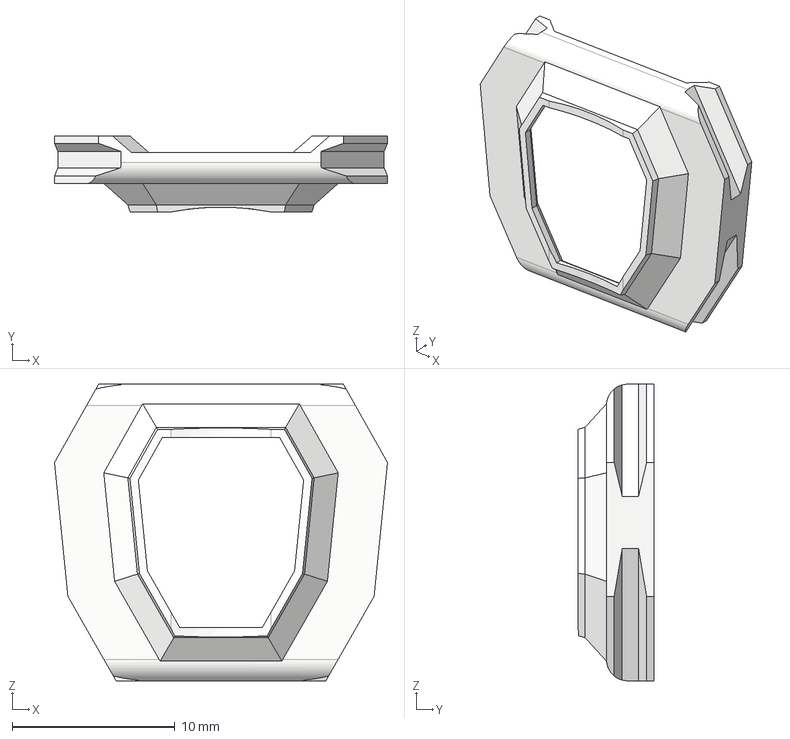
[picture p24: CAD file, 2026-08-05]
Mouse_cap_with_Head_fixation_capabilities/step_files/mouse_base_head_fixed_silicon_probe_combined_v01.step
20.4 x 4.67 x 18.2 mm
