buzsakilab/3d_print_designs/Mouse_hat_base/mouse_base_L11.5mm_W10.00mm.stl

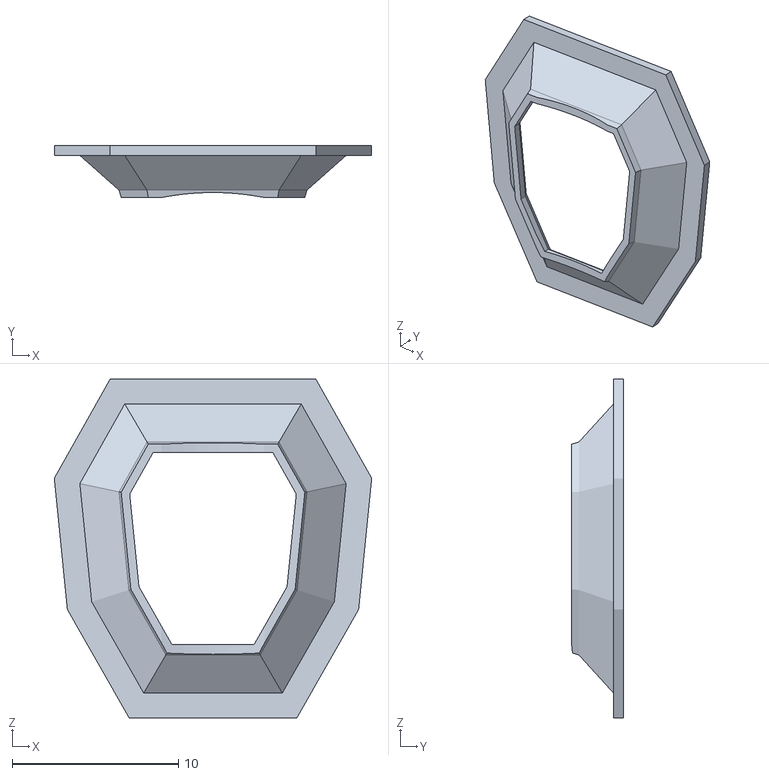
[picture p25: CAD file, 2021-02-21]
Mouse_hat_base/mouse_base_L11.5mm_W10.00mm.stl
19.1 x 3.13 x 20.4
