buzsakilab/3d_print_designs/Mouse_head_fixation/spring_multiAngle/step_files/Component46.step

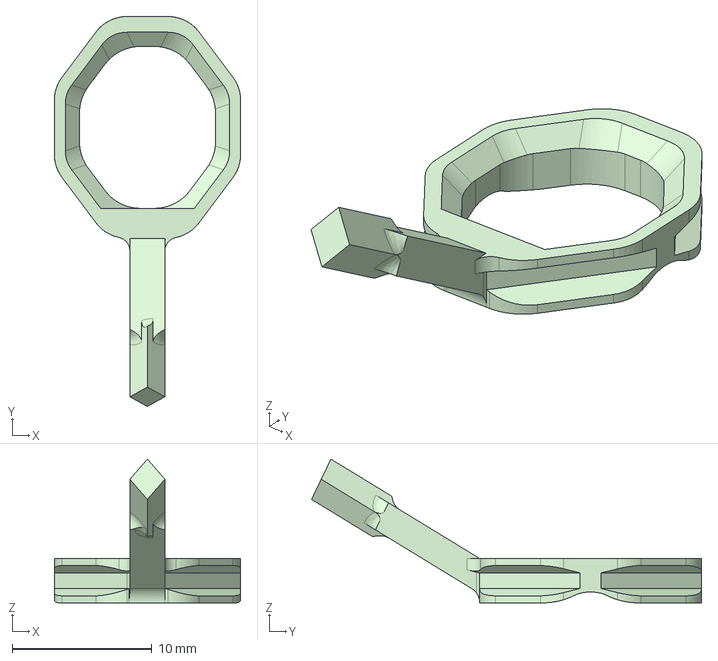
[picture p26: CAD file, 2026-08-05]
Mouse_head_fixation/spring_multiAngle/step_files/Component46.step
13.3 x 27.9 x 10.3 mm
