buzsakilab/3d_print_designs/Mouse_head_fixation/spring_multiAngle/stereotax_attachment_spring_multiAngle_v_03.stl

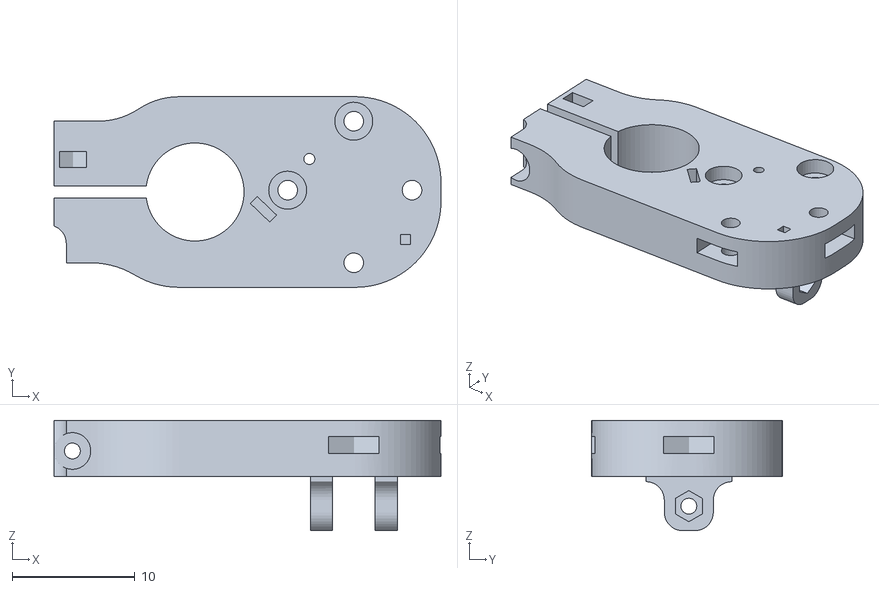
[picture p27: CAD file, 2026-08-05]
Mouse_head_fixation/spring_multiAngle/stereotax_attachment_spring_multiAngle_v_03.stl
31.6 x 15.6 x 9.00
