buzsakilab/3d_print_designs/Rat_cap/v8/stl_files/rat_cap_base_v8.stl

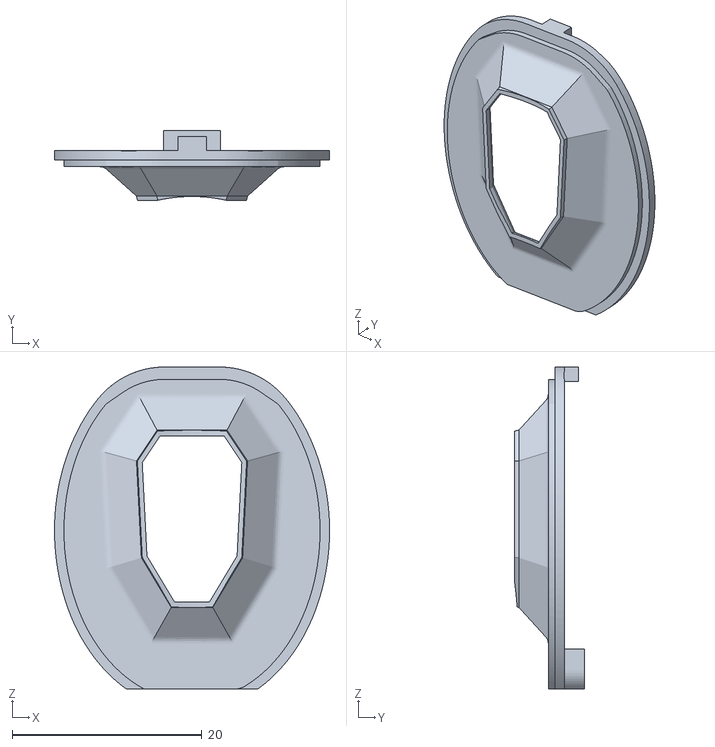
[picture p28: CAD file, 2020-12-21]
Rat_cap/v8/stl_files/rat_cap_base_v8.stl
29.0 x 7.34 x 33.9
