buzsakilab/3d_print_designs/Rat_cap/v8_v2_256/stl_files/rat_cap_left_wall_v8_v2_256.stl

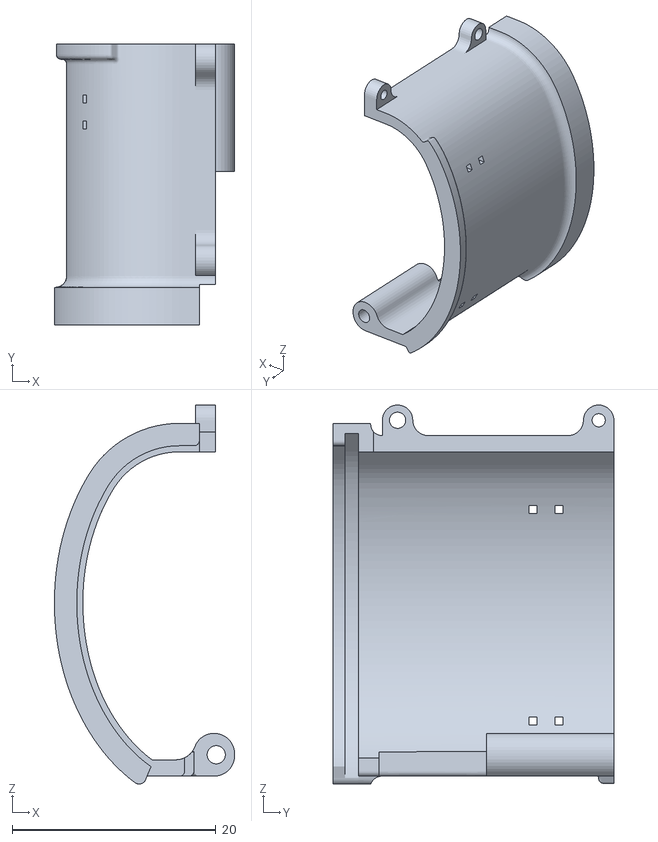
[picture p29: CAD file, 2025-12-23]
Rat_cap/v8_v2_256/stl_files/rat_cap_left_wall_v8_v2_256.stl
17.7 x 27.6 x 37.2
