buzsakilab/3d_print_designs/Rat_hat_base/Hat base for rats.stl

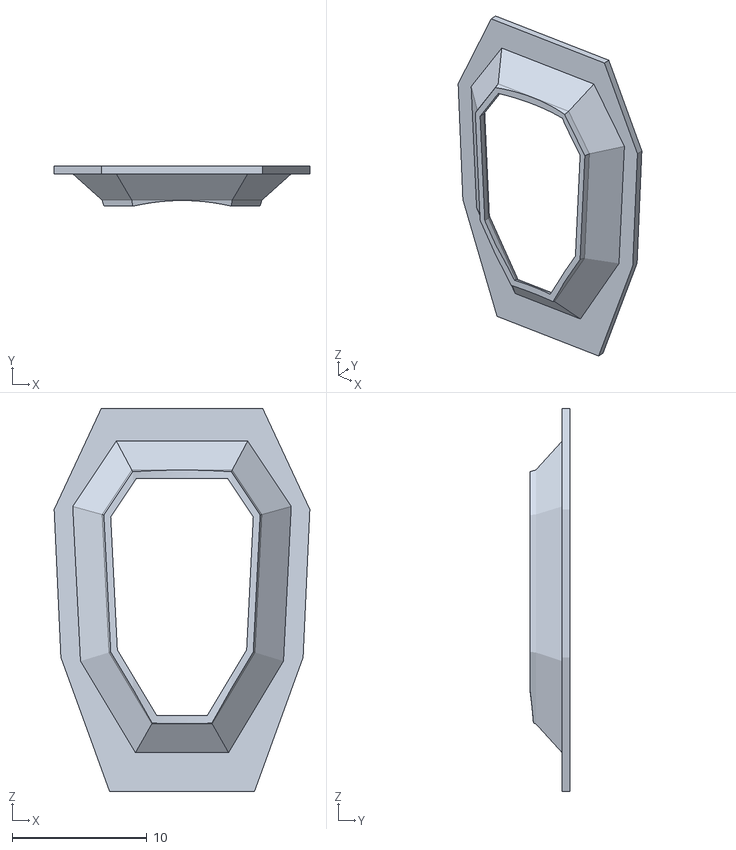
[picture p30: CAD file, 2020-12-21]
Rat_hat_base/Hat base for rats.stl
19.0 x 3.00 x 28.5
