buzsakilab/3d_print_designs/Rigid_bodies_OptiTrack/rigid_body_rats.stl

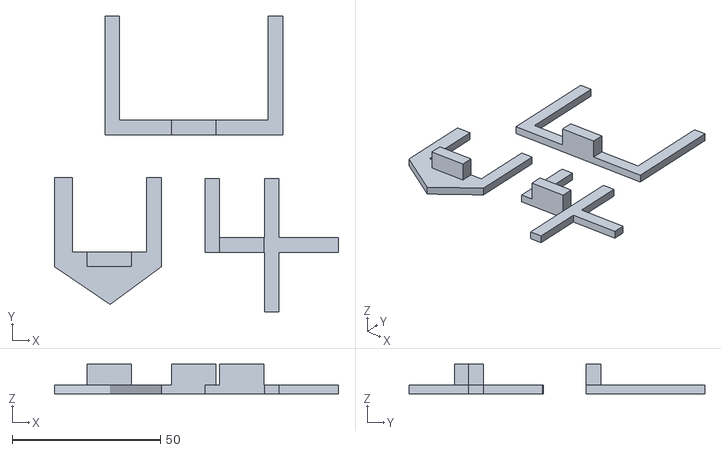
[picture p31: CAD file, 2017-07-04]
Rigid_bodies_OptiTrack/rigid_body_rats.stl
95.6 x 99.6 x 10.00
