buzsakilab/3d_print_designs/LED_bar_mount/magnet mounts v3.stl

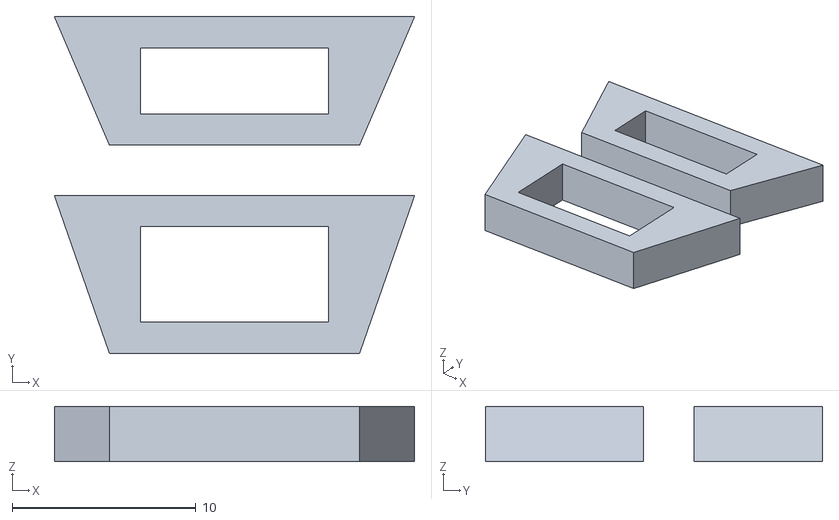
[picture p32: CAD file, 2017-07-04]
LED_bar_mount/magnet mounts v3.stl
19.6 x 18.3 x 3.00
