buzsakilab/3d_print_designs/Microdrives/Antonio/stl_files/arm.stl

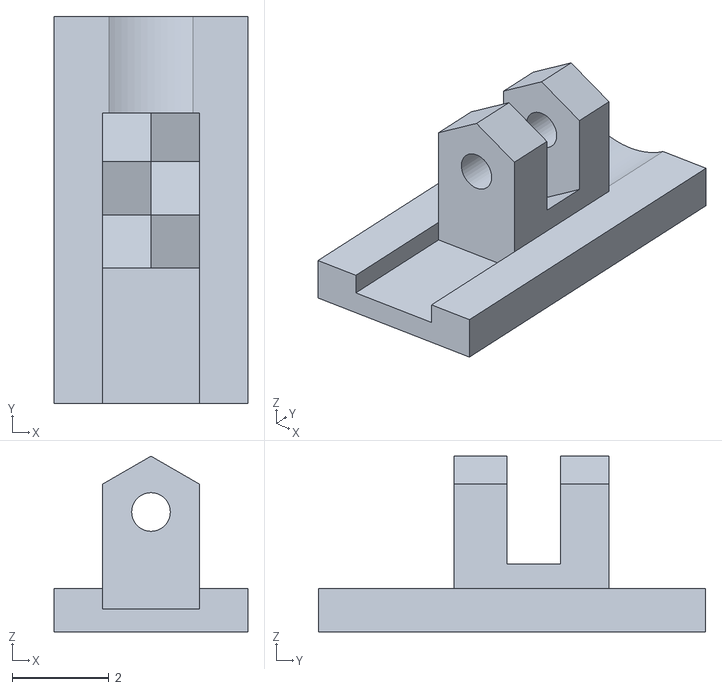
[picture p33: CAD file, 2020-12-21]
Microdrives/Antonio/stl_files/arm.stl
4.00 x 8.00 x 3.63
