buzsakilab/3d_print_designs/Microdrives/Metal_prototype/holder_metal_prototype.stl

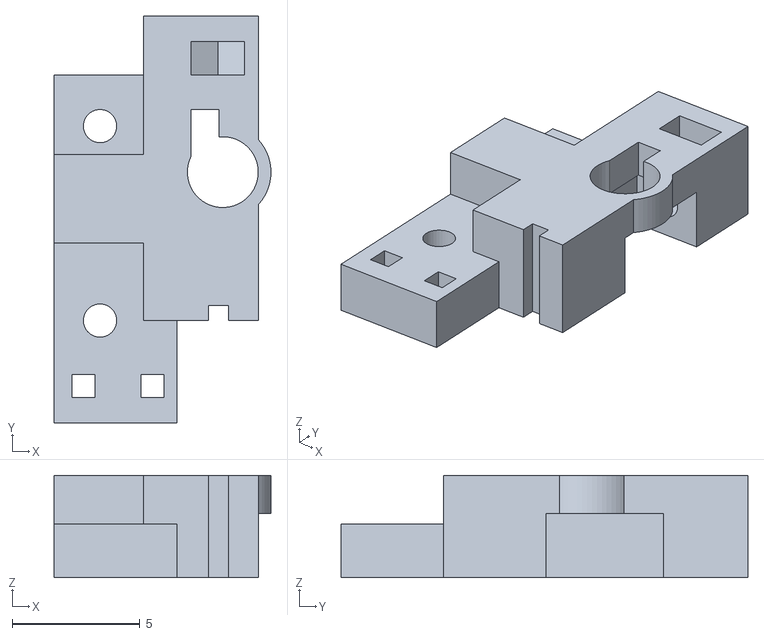
[picture p34: CAD file, 2021-02-21]
Microdrives/Metal_prototype/holder_metal_prototype.stl
8.48 x 15.9 x 4.00
