buzsakilab/3d_print_designs/Microdrives/Metal_recoverable/Drive_holder_variations/step_files/drive_v10.step

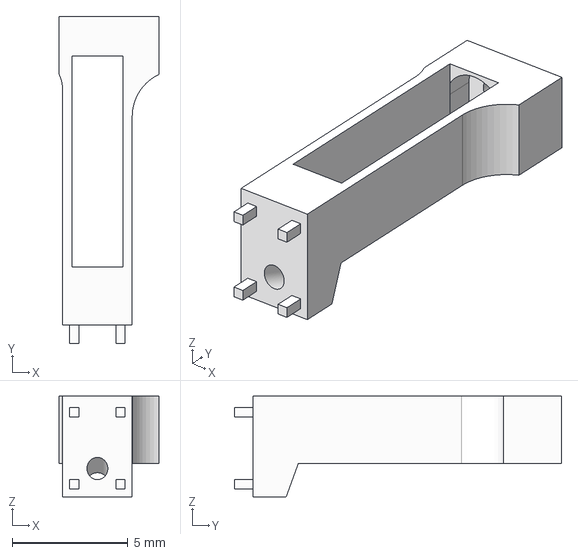
[picture p35: CAD file, 2021-06-20]
Microdrives/Metal_recoverable/Drive_holder_variations/step_files/drive_v10.step
4.30 x 14.1 x 4.35 mm
