buzsakilab/3d_print_designs/Microdrives/Metal_recoverable/Drive_holder_variations/stl_files/drive_holder_frontal_variation_02.stl

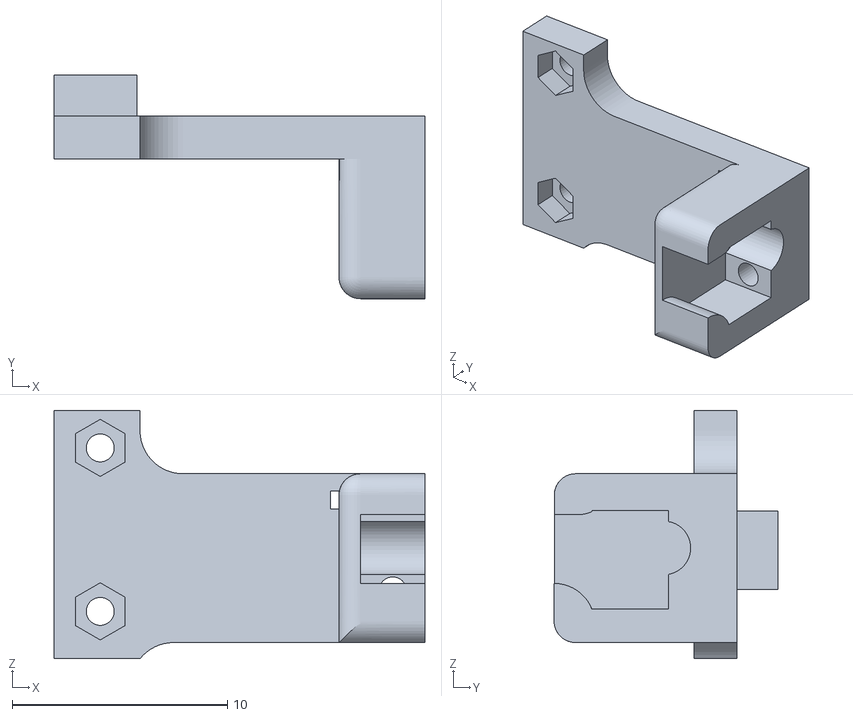
[picture p36: CAD file, 2021-06-20]
Microdrives/Metal_recoverable/Drive_holder_variations/stl_files/drive_holder_frontal_variation_02.stl
17.2 x 10.4 x 11.5
