buzsakilab/3d_print_designs/Microdrives/Metal_recoverable/v10/stl_files/drive_holder_metal_drive_v10.stl

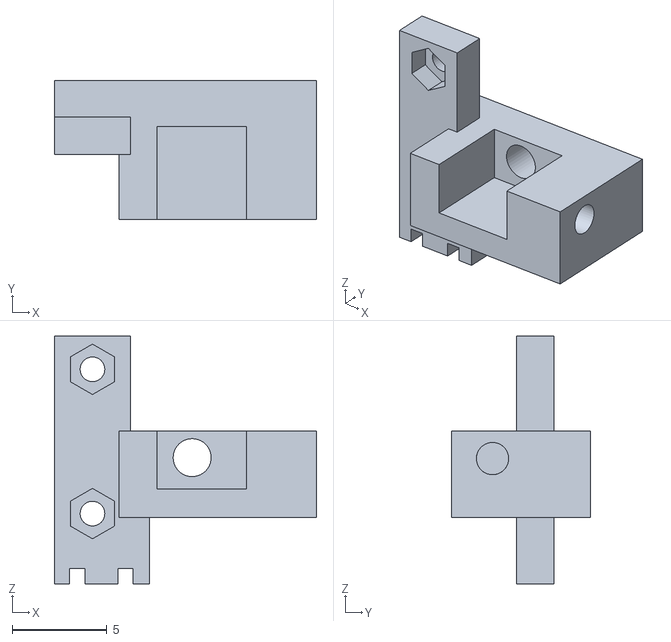
[picture p37: CAD file, 2021-05-03]
Microdrives/Metal_recoverable/v10/stl_files/drive_holder_metal_drive_v10.stl
13.8 x 7.30 x 13.0
