buzsakilab/3d_print_designs/Microdrives/Plastic_recoverable/stl_files/drive_holder_v21.stl

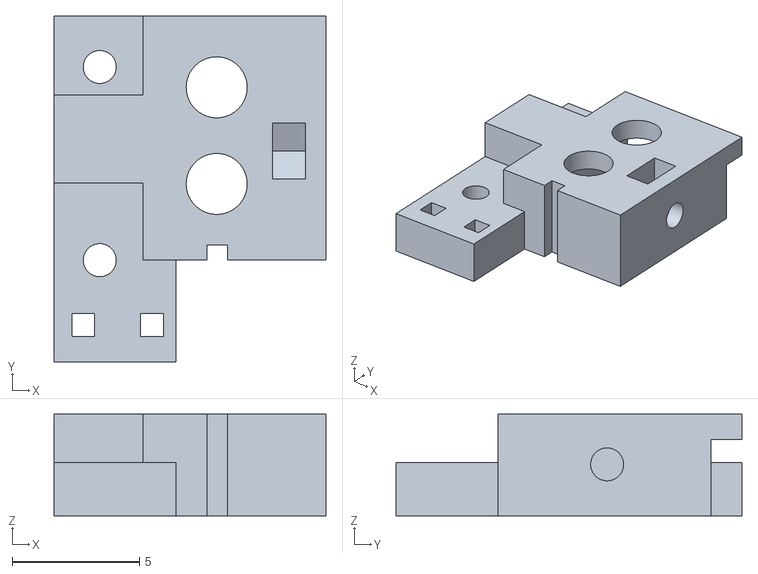
[picture p38: CAD file, 2020-12-21]
Microdrives/Plastic_recoverable/stl_files/drive_holder_v21.stl
10.7 x 13.6 x 4.00
