buzsakilab/3d_print_designs/Mouse_cap/stl_files/mouse_base_v12_L11.5mm_W10.00mm.stl

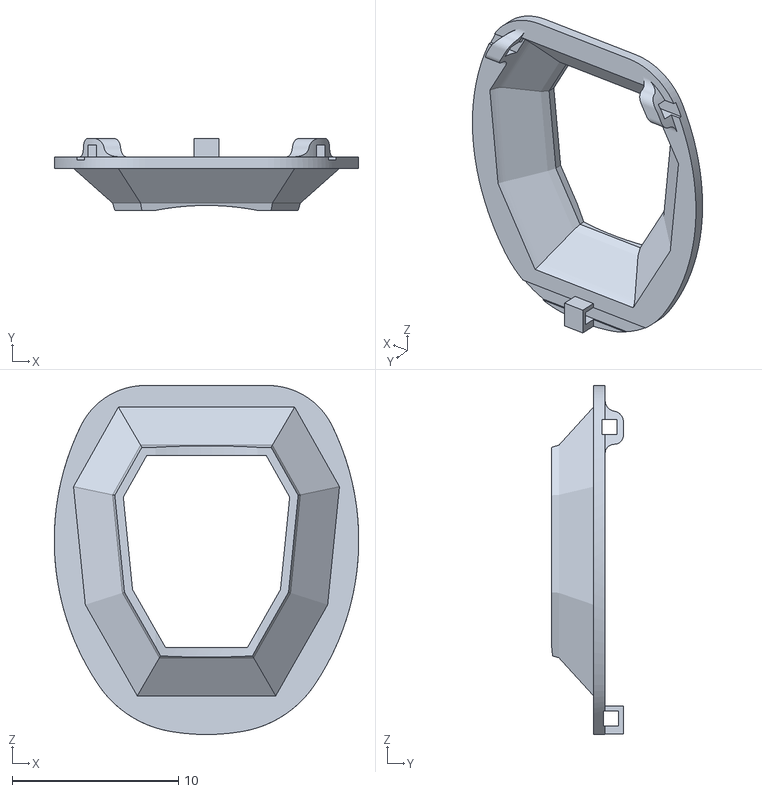
[picture p39: CAD file, 2021-02-22]
Mouse_cap/stl_files/mouse_base_v12_L11.5mm_W10.00mm.stl
18.3 x 4.33 x 21.0
