buzsakilab/3d_print_designs/Mouse_cap_with_Head_fixation_capabilities/step_files/right_wall_head_fixed_silicon_probe_combined_v01.step

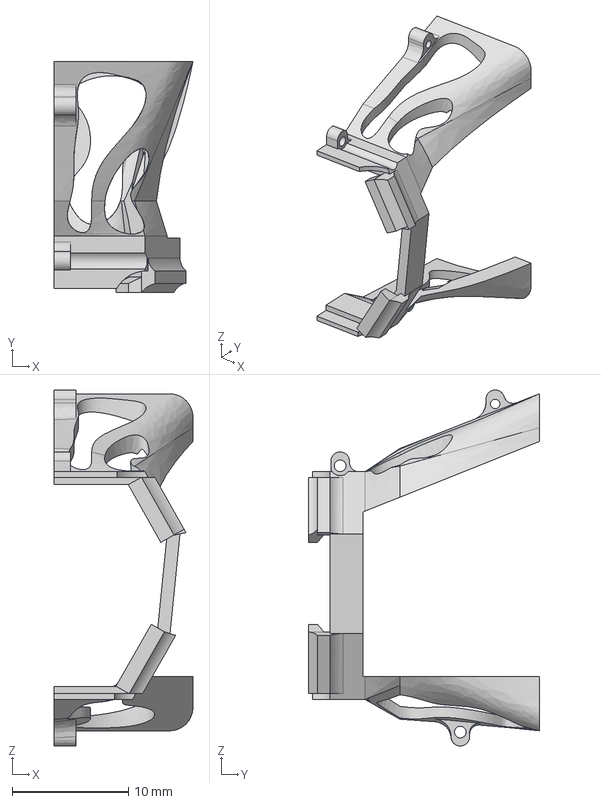
[picture p40: CAD file, 2026-08-05]
Mouse_cap_with_Head_fixation_capabilities/step_files/right_wall_head_fixed_silicon_probe_combined_v01.step
12.0 x 19.9 x 30.6 mm
