buzsakilab/3d_print_designs/Mouse_hat_base/Hat_for _mouse_inside_10.6mmx8.stl

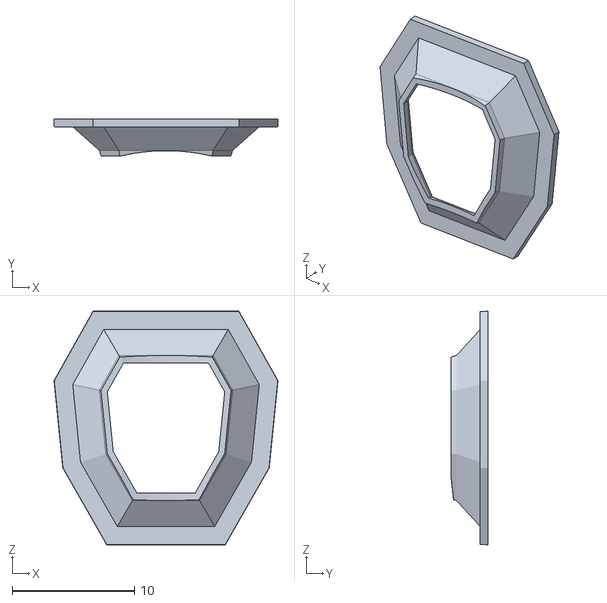
[picture p41: CAD file, 2020-12-21]
Mouse_hat_base/Hat_for _mouse_inside_10.6mmx8.stl
18.3 x 3.00 x 19.1
