buzsakilab/3d_print_designs/Mouse_head_fixation/spring_multiAngle/step_files/Component22.step

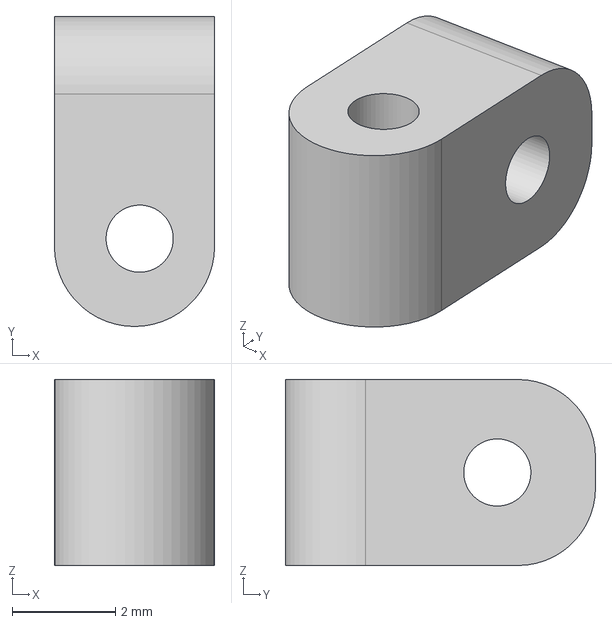
[picture p42: CAD file, 2026-08-05]
Mouse_head_fixation/spring_multiAngle/step_files/Component22.step
3.10 x 6.00 x 3.60 mm
