buzsakilab/3d_print_designs/Rat_cap/v8/stl_files/rat_cap_left_wall_v8.stl

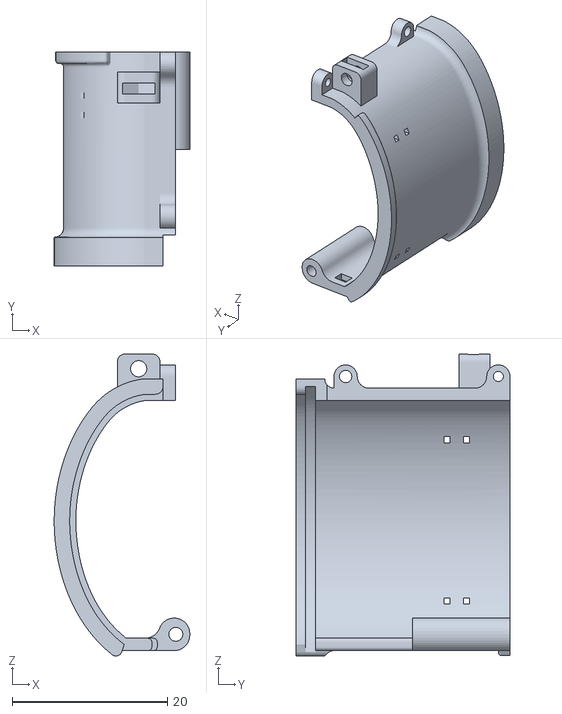
[picture p43: CAD file, 2020-12-21]
Rat_cap/v8/stl_files/rat_cap_left_wall_v8.stl
17.5 x 27.6 x 39.0
