buzsakilab/3d_print_designs/Rigid_bodies_OptiTrack/rigid_body_mice_Viktor.stl

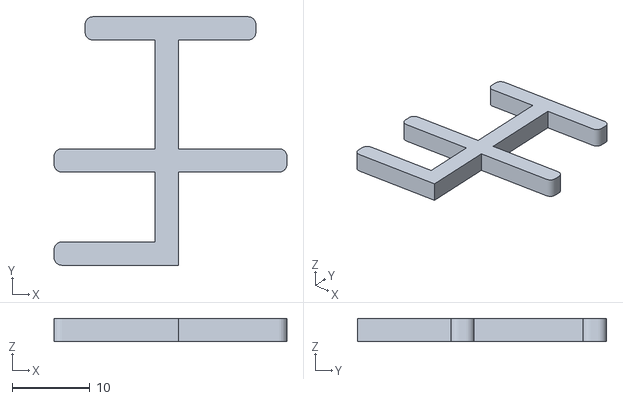
[picture p44: CAD file, 2017-07-04]
Rigid_bodies_OptiTrack/rigid_body_mice_Viktor.stl
30.0 x 32.0 x 3.00
