buzsakilab/3d_print_designs/LED_bar_mount/LED mount v4.stl

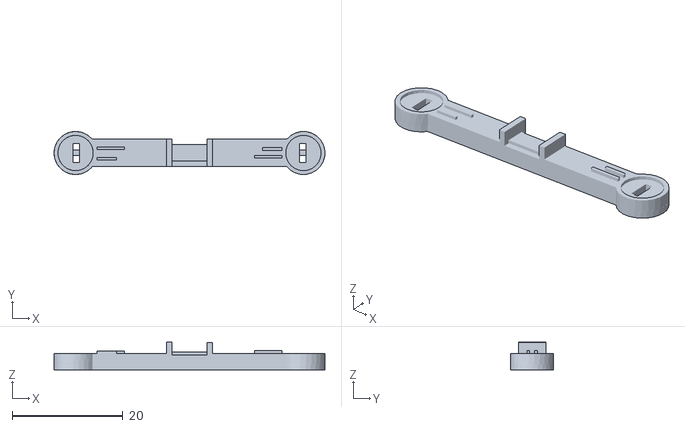
[picture p45: CAD file, 2017-07-04]
LED_bar_mount/LED mount v4.stl
49.0 x 7.80 x 5.03
