buzsakilab/3d_print_designs/Microdrives/Metal_prototype/drive_metal_prototype.stl

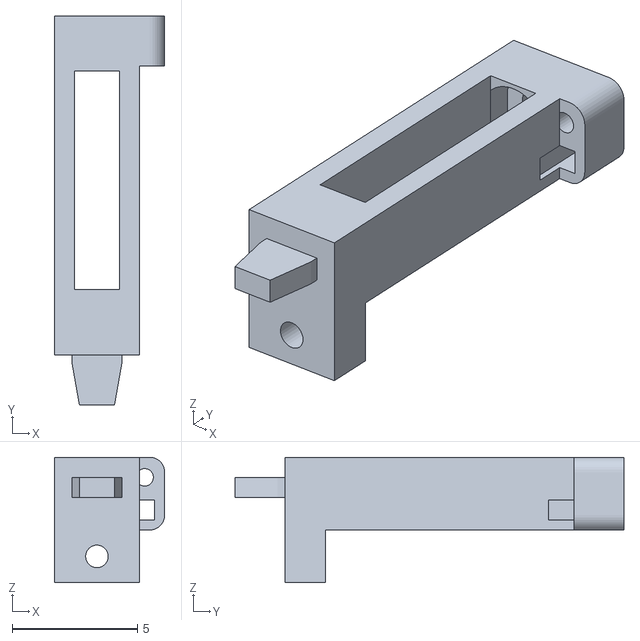
[picture p46: CAD file, 2021-02-21]
Microdrives/Metal_prototype/drive_metal_prototype.stl
4.40 x 15.5 x 5.00
