buzsakilab/3d_print_designs/Microdrives/Metal_recoverable/Drive_holder_variations/step_files/base_aluminum_v10.step

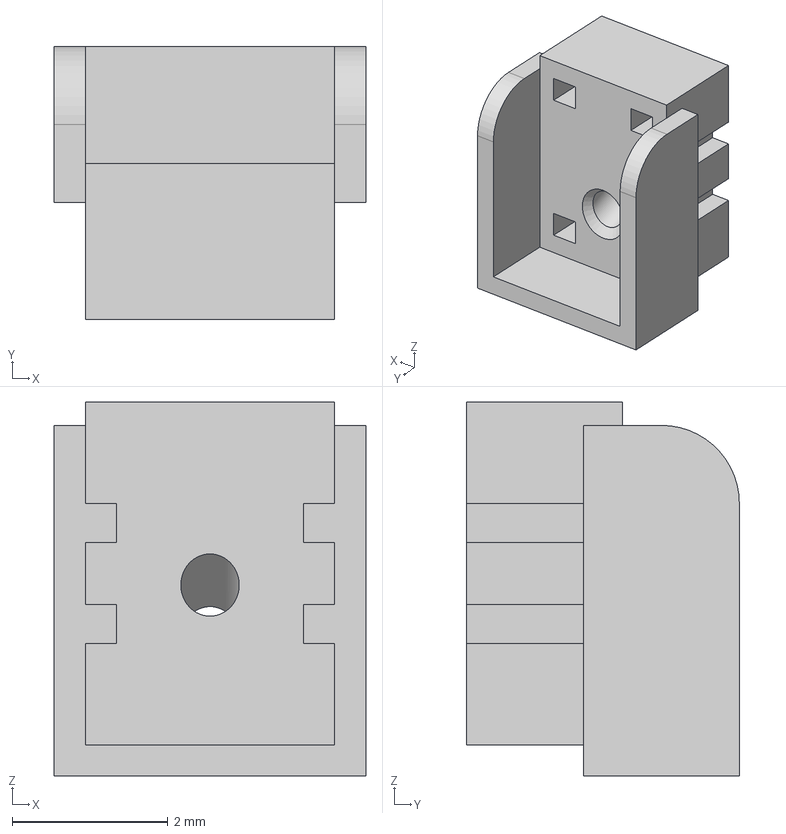
[picture p47: CAD file, 2021-06-20]
Microdrives/Metal_recoverable/Drive_holder_variations/step_files/base_aluminum_v10.step
4.00 x 3.50 x 4.80 mm
