buzsakilab/3d_print_designs/Microdrives/Metal_recoverable/Drive_holder_variations/stl_files/drive_holder_frontal_variation_01.stl

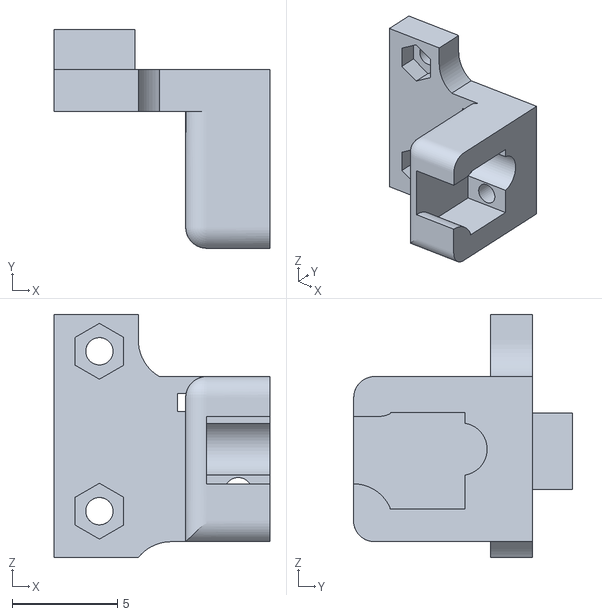
[picture p48: CAD file, 2021-06-20]
Microdrives/Metal_recoverable/Drive_holder_variations/stl_files/drive_holder_frontal_variation_01.stl
10.2 x 10.4 x 11.5
