buzsakilab/3d_print_designs/Microdrives/Plastic_recoverable/stl_files/arm_64ch_v3_v21.stl

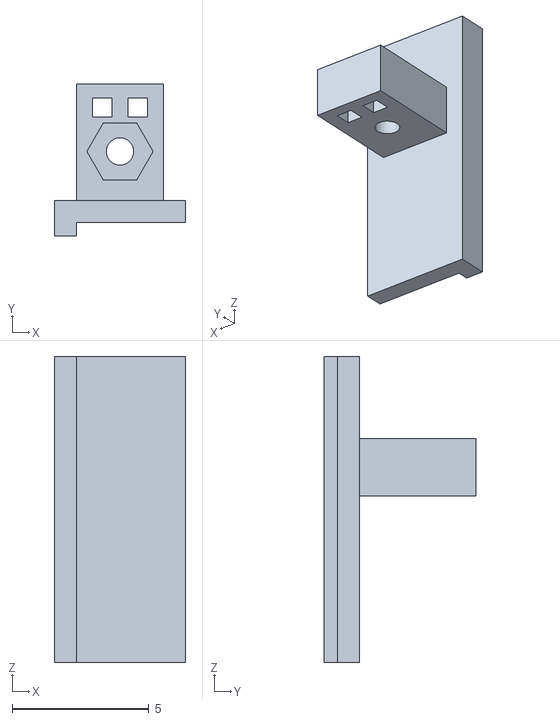
[picture p49: CAD file, 2020-12-21]
Microdrives/Plastic_recoverable/stl_files/arm_64ch_v3_v21.stl
4.80 x 5.58 x 11.2
