buzsakilab/3d_print_designs/Mouse_head_fixation/spring_multiAngle/base_holder_spring_multiAngle_v_03.stl

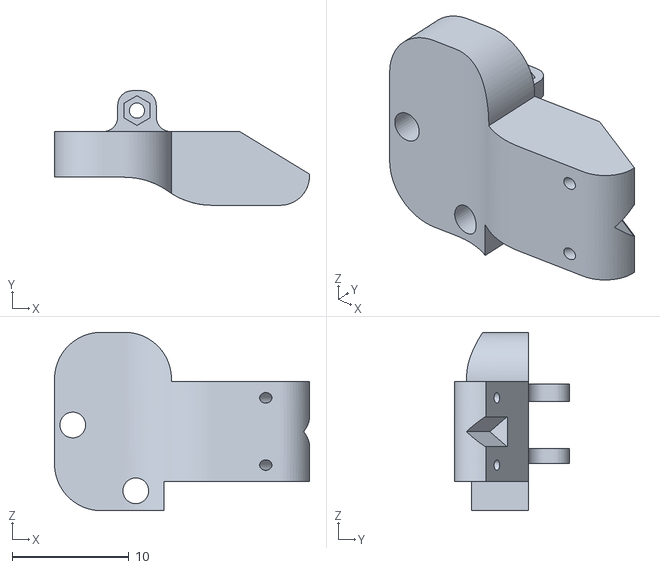
[picture p50: CAD file, 2026-08-05]
Mouse_head_fixation/spring_multiAngle/base_holder_spring_multiAngle_v_03.stl
21.8 x 9.80 x 15.3
