buzsakilab/3d_print_designs/Mouse_head_fixation/spring_multiAngle/step_files/mouse_base.step

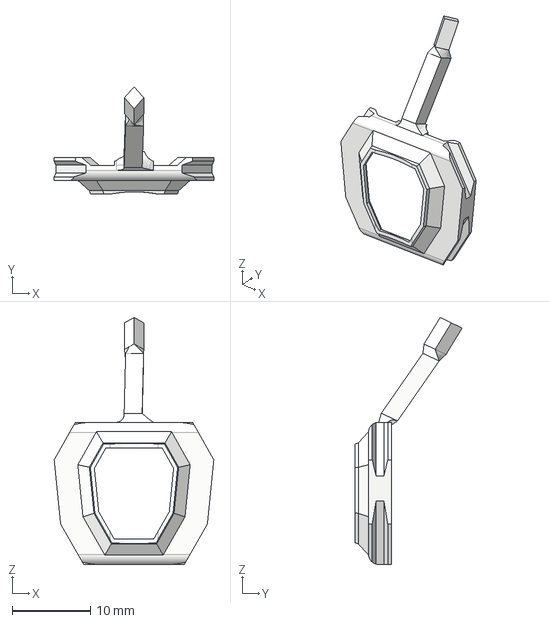
[picture p51: CAD file, 2026-08-05]
Mouse_head_fixation/spring_multiAngle/step_files/mouse_base.step
20.4 x 13.7 x 31.6 mm
