buzsakilab/3d_print_designs/Rat_cap/v8/stl_files/rat_cap_top_v8.stl

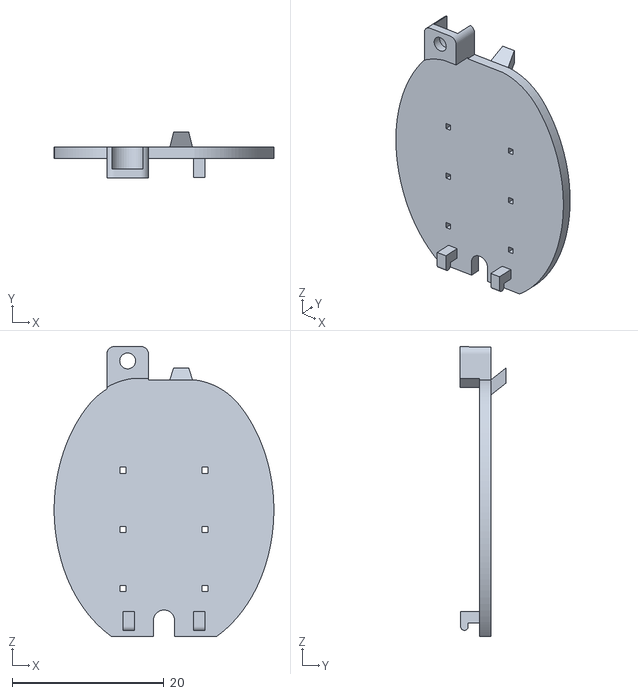
[picture p52: CAD file, 2020-12-21]
Rat_cap/v8/stl_files/rat_cap_top_v8.stl
29.0 x 6.10 x 38.3
