buzsakilab/3d_print_designs/Rat_cap/v8_v2_256/stl_files/rat_cap_base_v8_v2_256.stl

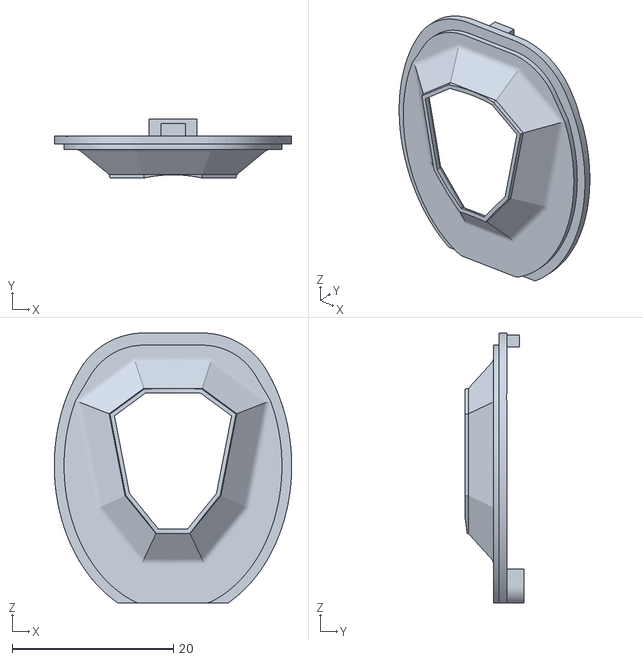
[picture p53: CAD file, 2025-12-23]
Rat_cap/v8_v2_256/stl_files/rat_cap_base_v8_v2_256.stl
29.4 x 7.34 x 33.5
