buzsakilab/3d_print_designs/Microdrives/Metal_prototype/base20deg_metal_prototype.stl

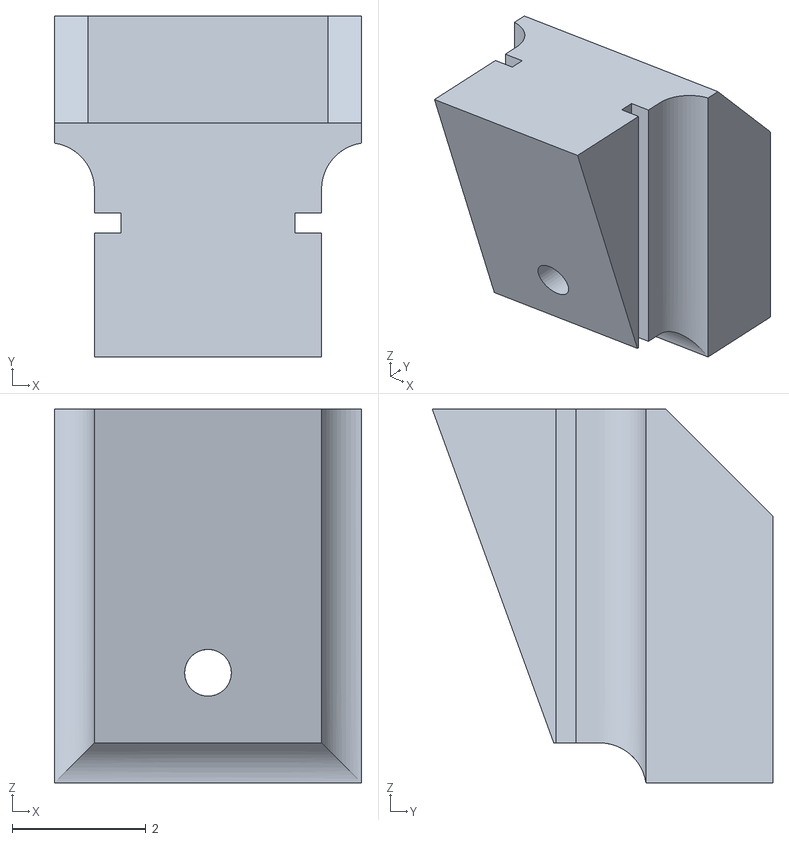
[picture p54: CAD file, 2021-02-21]
Microdrives/Metal_prototype/base20deg_metal_prototype.stl
4.60 x 5.10 x 5.60
