buzsakilab/3d_print_designs/Microdrives/Metal_recoverable/Drive_holder_variations/stl_files/drive_holder_frontal_variation_03.stl

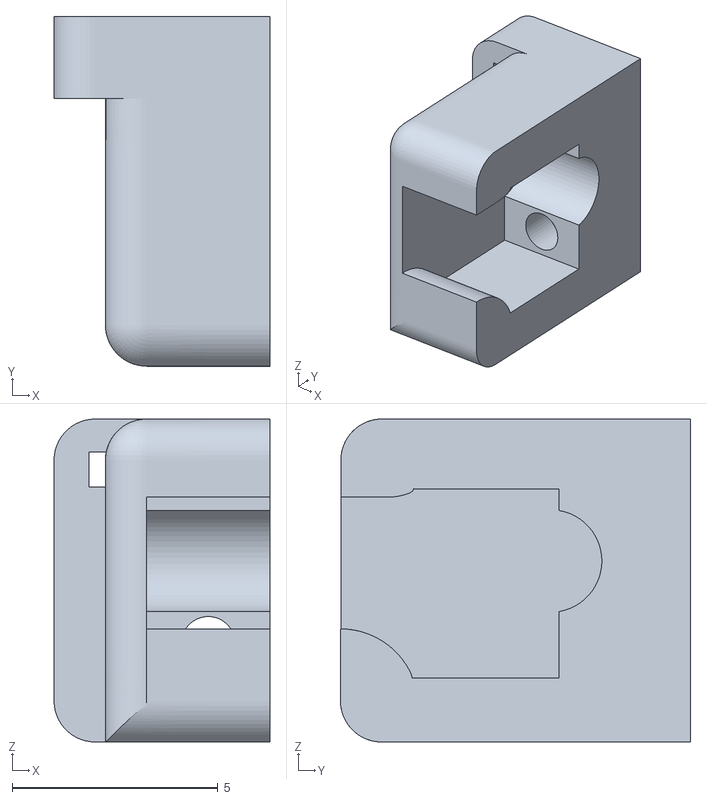
[picture p55: CAD file, 2021-06-20]
Microdrives/Metal_recoverable/Drive_holder_variations/stl_files/drive_holder_frontal_variation_03.stl
5.25 x 8.51 x 7.85
