buzsakilab/3d_print_designs/Mouse_cap/stl_files/mouse_hat_copperMesh_cutOut_v02.stl

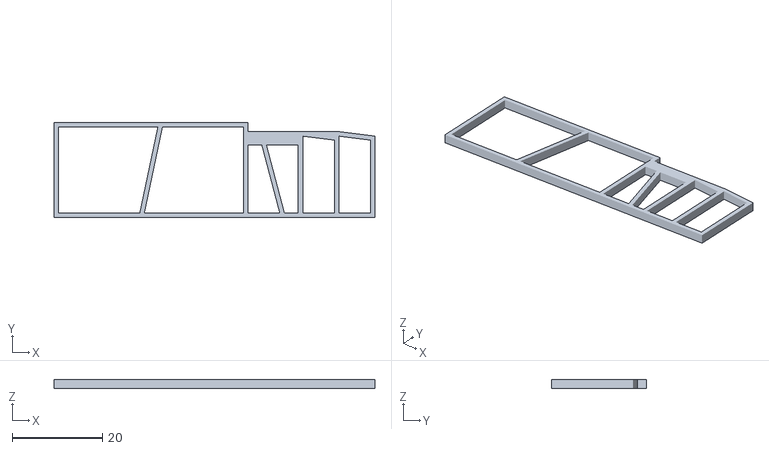
[picture p56: CAD file, 2020-12-21]
Mouse_cap/stl_files/mouse_hat_copperMesh_cutOut_v02.stl
71.1 x 21.0 x 2.00
