buzsakilab/3d_print_designs/Rat_cap/v8/stl_files/rat_cap_right_wall_v8.stl

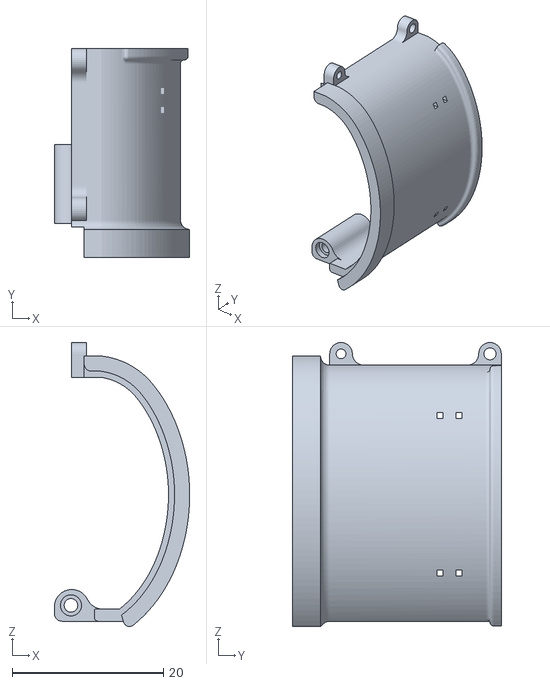
[picture p57: CAD file, 2020-12-21]
Rat_cap/v8/stl_files/rat_cap_right_wall_v8.stl
17.9 x 27.6 x 37.6
