buzsakilab/3d_print_designs/Microdrives/Metal_prototype/arm_metal_prototype.stl

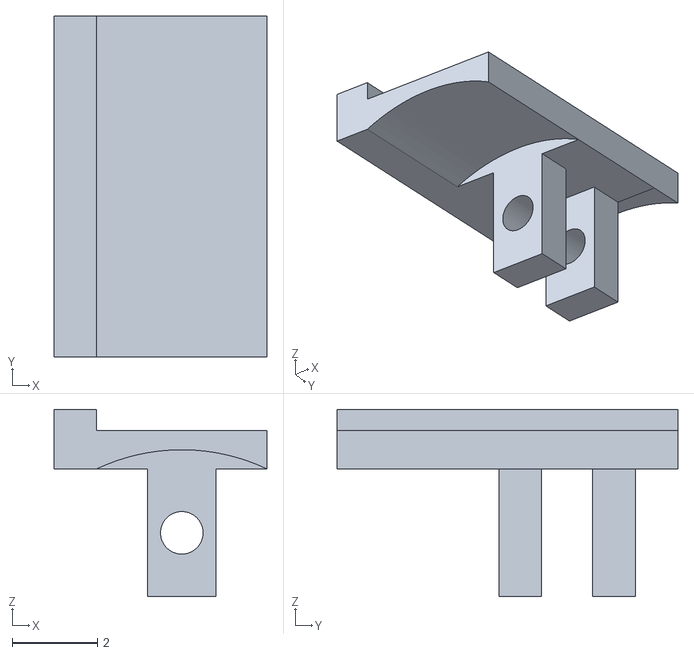
[picture p58: CAD file, 2021-02-21]
Microdrives/Metal_prototype/arm_metal_prototype.stl
5.00 x 8.00 x 4.40
