buzsakilab/3d_print_designs/Microdrives/Plastic_recoverable/stl_files/shell_v21.stl

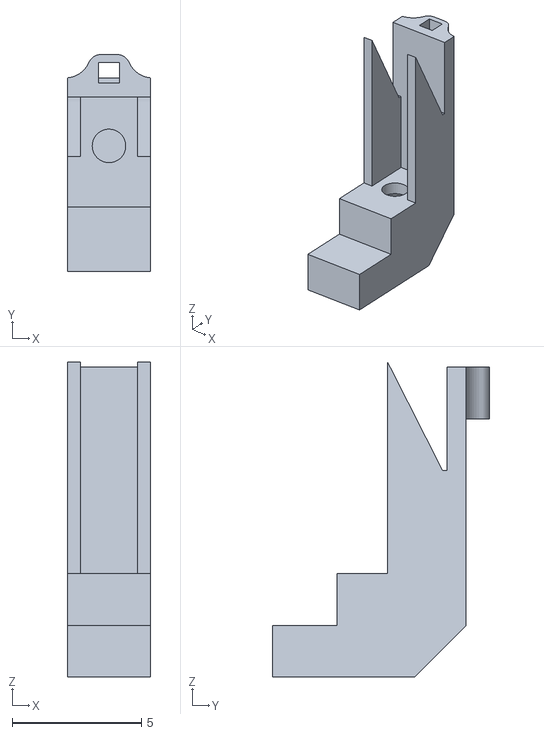
[picture p59: CAD file, 2020-12-21]
Microdrives/Plastic_recoverable/stl_files/shell_v21.stl
3.20 x 8.40 x 12.2
