buzsakilab/3d_print_designs/Mouse_head_fixation/spring_multiAngle/base_cover_spring_multiAngle_v_03.stl

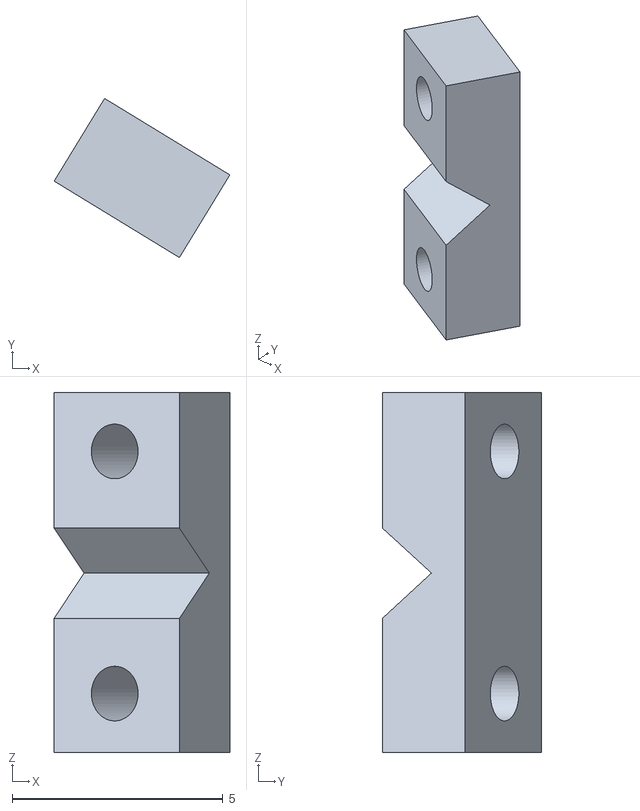
[picture p60: CAD file, 2026-08-05]
Mouse_head_fixation/spring_multiAngle/base_cover_spring_multiAngle_v_03.stl
4.17 x 3.78 x 8.55
