buzsakilab/3d_print_designs/Microdrives/Plastic_recoverable/stl_files/drive_v21.stl

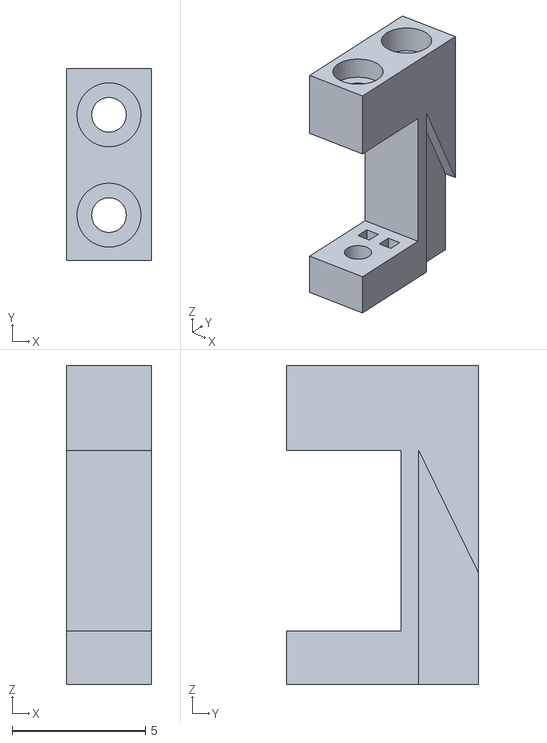
[picture p61: CAD file, 2020-12-21]
Microdrives/Plastic_recoverable/stl_files/drive_v21.stl
3.20 x 7.20 x 12.0
