buzsakilab/3d_print_designs/(list of files, cad)

Other CAD files:
Microdrives/Metal_recoverable/v10/stl_files/stereotax_attachment_metal_drive_v10.stl
Microdrives/Metal_recoverable/v10/step_files/arm_v10_aluminum_64ch.step
Mouse_cap_with_Head_fixation_capabilities/Kopf_adapter/misi_post_clamp_08_left.stl
Mouse_cap_with_Head_fixation_capabilities/left_clamp_head_fixed_silicon_probe_combined_v01.stl
Rat_cap/v8_v2_256/stl_files/rat_cap_right_wall_v8_v2_256.stl
Microdrives/Metal_recoverable/v10/step_files/base_v10_aluminum.step
Mouse_cap/stl_files/right_wall_v12_L11.5mm_W10.00mm.stl
Mouse_cap_with_Head_fixation_capabilities/step_files/left_wall_head_fixed_silicon_probe_combined_v01.step
Microdrives/Metal_recoverable/v10/step_files/drive_v10.step
Microdrives/Plastic_recoverable/stl_files/stereotax_attachment_v21.stl
Mouse_head_fixation/spring_multiAngle/Dima_base_spring_multiAngle_v_03.stl
Mouse_head_fixation/spring_multiAngle/step_files/stereotax_attachment.step
Mouse_head_fixation/spring_multiAngle/mouse_base_spring_multiAngle_v_03.stl
Microdrives/Metal_recoverable/v07/step_files/arm_v7_50um.step
Microdrives/Metal_recoverable/v07/step_files/base_v7.step
Microdrives/Metal_recoverable/v07/step_files/drive_v7.step
Microdrives/Metal_recoverable/v07/stl_files/drive_holder_metal_v7.stl
Microdrives/Metal_recoverable/v07/stl_files/stereotax_attachment_metal_v7.stl
Microdrives/Metal_recoverable/v09/step_files/arm_v09.step
Microdrives/Metal_recoverable/v09/step_files/arm_v09_aluminum.step
Microdrives/Metal_recoverable/v09/step_files/base_v09.step
Microdrives/Metal_recoverable/v09/step_files/drive_v09.step
Microdrives/Metal_recoverable/v09/stl_files/stereotax_attachment_v09.stl
Mouse_cap_with_Head_fixation_capabilities/left_wall_head_fixed_silicon_probe_combined_v01.stl
Mouse_cap_with_Head_fixation_capabilities/mouse_base_head_fixed_silicon_probe_combined_v01.stl
Mouse_cap_with_Head_fixation_capabilities/right_wall_head_fixed_silicon_probe_combined_v01.stl
Mouse_head_fixation/spring_multiAngle/screw_protector_spring_multiAngle_v_03.stl
Mouse_head_fixation/spring_multiAngle/step_files/screw_protector.step
