buzsakilab/3d_print_designs/Microdrives/Metal_recoverable/Ordering_instructions.txt

In order to receive high quality prints from ProtoLabs, please follow these instructions.

1. Add the following note to drive_v10: ’Use orientation as in quote 9301-742',
2. Add the following note to arm_v10_aluminum: ’Use orientation as in quote 2379-080.’
3. Add the following note to base_v10_aluminum: ’Use orientation as in quote 6243-446.’
