buzsakilab/3d_print_designs/preprints/Recoverable_plastic_microdrive_and_3D-printed_base_plate_system_for_rodent_electrophysiology_v3_preprint.pdf

1 | 3D-printed recoverable microdrive and base plate system for rodent electrophysiology
| Mihály Vöröslakos¹,6 , Hiroyuki Miyawaki
| 3 , Sebastien Royer⁴ , Kamran Diba⁵ , Euisik Yoon
6,7,8 2 | ,

Peter C. Petersen¹,*

and György Buzsáki¹,2,* 3

4

1Neuroscience Institute, 2 5 | Department of Neurology, Langone Medical Center, New York University, New
6 | York, NY 10016, USA
3 7 | Department of Physiology, Osaka City University Graduate School of Medicine,
8 | Asahimachi 1-4-3, Abeno-ku, Osaka, 545-8585, Japan
4 9 | Center for Functional Connectomics, Korea Institute of Science and Technology, Seoul 02792, Republic
10 | of Korea
5 11 | Department of Anesthesiology, University of Michigan, Ann Arbor, MI 48109, USA
6Department of Electrical Engineering and Computer Science, 7 12 | Department of Biomedical Engineering,
13 | University of Michigan, Ann Arbor, MI, 48109, USA
8 14 | Center for Nanomedicine, Institute for Basic Science (IBS) and Graduate Program of Nano Biomedical
15 | Engineering (Nano BME), Yonsei University, Seoul, Korea
* 16 | Corresponding authors: petersen.peter@gmail.com and gyorgy.buzsaki@nyulangone.org

17

18 | Abstract
19 | Extracellular recordings in freely moving animals allow the monitoring of brain activity from
20 | populations of neurons at single-spike temporal resolution. While state-of-the-art
21 | electrophysiological recording devices have been developed in recent years (e.g.: µLED and
22 | Neuropixel silicon probes), implantation methods for silicon probes in rats and mice have not
23 | advanced substantially for a decade. The surgery is complex, takes time to master, and involves
24 | handling expensive devices and valuable animal subjects. In addition, chronic silicon neural probes
25 | are practically single implant devices, due to a current low success rate of probe recovery. To
26 | successfully recover silicon probes, improve upon the quality of our electrophysiological
27 | recording, and make silicon probe recordings more accessible, we have designed a miniature, low
28 | cost, recoverable microdrive system. The addition of a novel 3D-printed skull base plate makes
29 | the surgery less invasive, faster, and simpler for both rats and mice. We provide detailed procedural
30 | instructions and print designs allowing researchers to adapt and flexibly customize our designs to
31 | their experimental usage.

Keywords: electrophysiology, silicon probe, microdrive, 3D printing, freely moving, behavior,

mice, rats.

Background

High-channel-count and high-density silicon probes can provide unique spatial and temporal

information about brain activity (Jun et al., 2017; Steinmetz et al., 2020). Despite the advancement

in probe technology, extracellular recording is complicated and expensive in freely moving

animals using the newly developed silicon probes (high-channel-count Neuropixels probe (Jun et

al., 2017), light emitting µLED probe (Wu et al., 2015) or 128-channel active probe (Diagnostic

Biochips, Glen Burnie, MD)). Effective probe recovery procedures are highly desirable due to the

high cost of these devices (Chung et al., 2017b; Juavinett et al., 2019). 3D printed, recoverable

43 | microdrive system for | mice (Chung et al., 2017a; Sariev et al., 2017) and for rats

(github.com/Mizuseki-Lab/microdrive), allow researchers to reuse silicon probes with ease,

decreasing the effective cost of the probes. Despite the popularity of the head-fixed preparation,

there are scientific questions that can be better addressed using freely moving rodents. Therefore,

we have designed a microdrive system that can be used for both mice and rats in freely moving

experiments. Furthermore, to reduce the complexity of the surgery (Vandecasteele et al., 2012) we

have designed a hybrid head cap system which consists of a 3D printed plastic base plate with a

copper mesh attached to the skull using dental cement. The copper mesh provides structural

protection and electrical shielding to the implanted hardware and electronics. The head cap system

can be used in a wide range of applications because it is easy to mold the shape of the copper mesh

before hardening with dental cement. Improving the implantation method made our surgeries less

invasive and significantly faster, leading to speedier recovery of the animal. All 3D designs can be

printed in lab with a Formlabs Form 2, 3D resin printer, or a 3D printer with similar printing

capabilities. We provide detailed procedural instructions and videos allowing researchers to adapt

the head cap and recoverable microdrive system. The baseplate was developed for Petersen and

Buzsáki (2020) and Vöröslakos et al. (2020), and the microdrives for Vöröslakos et al. (2020).

Materials and Reagents

61 | All 3D prints were printed and tested in Grey and Clear resins (version-04) using a Formlabs,
62 | Form2 3D Printer with 50 µm resolution. All design files are available at
63 | github.com/buzsakilab/3d_print_designs and specific links are provided below in the material lists.

64

65 | Microdrive materials
66 | 1. 3D-printed microdrive components: body, arm, and base:
67 | github.com/buzsakilab/3d_print_designs/tree/master/Microdrives/Plastic_recoverable
68 | 2. 00-90 nut (3) (McMaster, catalog number: 92736A112)
69 | 3. 00-90 screws, ½” (2) (McMaster, catalog number: 92482A235)
70 | 4. Male header pin (DigiKey, catalog number: SAM1067-40-ND)
71 | 5. 00-90 tap (McMaster, catalog number: 2504A14)
72 | 6. Cyanoacrylate (Loctite, catalog number: 45208)
73 | 7. Playdough
74 | 8. 1.2 mm drill bit (McMaster, catalog number: 2958A29)
75 | Microdrive holder materials and assembly tools
76 | 1. 3D-printed drive holder:
77 | github.com/buzsakilab/3d_print_designs/tree/master/Microdrives/Plastic_recoverable
78 | 2. 00-90 nut (3) (McMaster, catalog number: 92736A112)
79 | 3. 00-90 screws, ¼” (1) (McMaster, catalog number: 93701A005)
80 | 4. Male header pin (DigiKey, catalog number: SAM1067-40-ND)
81 | 5. Cyanoacrylate (Loctite, catalog number: 45208)
82 | 6. T2 screwdriver (McMaster, catalog number: 52995A31)
83 | 7. 1.2 mm drill bit (McMaster, catalog number: 2958A29)
84 | Stereotax attachment materials and assembly tools
85 | 1. 3D-printed stereotax attachment:
86 | github.com/buzsakilab/3d_print_designs/tree/master/Microdrives/Plastic_recoverable
87 | 2. 00-90 nut (1) (McMaster, catalog number: 92736A112)
88 | 3. 00-90 screws, ¼” (3) (McMaster, catalog number: 93701A005)
89 | 4. Male header pin (DigiKey, catalog number: SAM1067-40-ND)
90 | 5. Cyanoacrylate (Loctite, catalog number: 45208)
91 | 6. T2 screwdriver (McMaster, catalog number: 52995A31)

92 | 7. 1.2 mm drill bit (McMaster, catalog number: 2958A29)
93 | Implantation hybrid base materials
94 | 1. 3D-printed mouse base:
95 | github.com/buzsakilab/3d_print_designs/tree/master/Mouse_hat_base
96 | 2. 3D-printed rat base: github.com/buzsakilab/3d_print_designs/tree/master/Rat_hat_base
97 | 3. Copper mesh (Dexmet, catalog number: 3CU6-050FA)
98 | 4. Dental acrylic (Pearson Dental, catalog number: G05-1224 and G05-1226)
99 | Surgery materials
100 | 1. Kimwipes (Kimtech, catalog number: 34120)
101 | 2. Gelfoam (Fisher Scientific, catalog number: NC1861013)
102 | 3. H2O2 (Swan, catalog number: S12794v)
103 | 4. C&B Metabond Base 10ml (Parkell, catalog number: P16-0116)
104 | 5. C&B Gold Catalyst (Parkell, catalog number: P16-0052)
105 | 6. C&B Metabond Clear Powder (Parkell, catalog number: P16-0121)
106 | 7. ceramic mix dish for metabond (Parkell, catalog number: S387)
107 | 8. measuring spoons for metabond (Parkell)
108 | 9. Brushes for metabond (Amazon, catalog number: B071F8WSW8)
109 | 10. Unifast Trad Powder Ivory (Pearson Dental, catalog number: G05-1224)
110 | 11. Unifast Trad Liquid (Pearson Dental, catalog number: G05-1226)
111 | 12. Unifast™ 1:2 Package A2 (Pearson Dental, catalog number: G05-0037)
112 | 13. Hair removing cream (Nair)
113 | 14. Povidone-Iodine (Amazon, catalog number: B07MWTH4MW)
114 | 15. Eye ointment (Puralube, catalog number: 0574-4025)
115 | 16. Fountain pen (AmazonBasics, catalog number: FC008A-1-M)
116 | 17. Isoflurane
117 | 18. Bupivacaine
118 | 19. Atropine
119 | 20. Steroide
120 | 21. Buprenex
121 | 22. Cyanoacrylate (Loctite, catalog number: 45208)
122 | 23. Distilled water

123 | 24. Ultrazyme Enzymatic Cleaner Tablets (Ultrazyme, catalog number: B000LM0ZYS)

124

125 | Equipment
126 | Silicon probes and equipment for attachment to microdrive
127 | 1. Silicon probe (Neuronexus, Cambridge Neurotech, Diagnostic Biochips)
128 | 2. 3D printed, assembled microdrive
129 | 3. 3D printed, assembled drive holder and stereotax attachment
130 | 4. Helping hand with alligator clip (Ridgerock Tools Inc., catalog number: 01902)
131 | Note: cover the alligator clip with electrical tape.
132 | 5. Blade (SPI Supplies, catalog number: 05025-MB)
133 | Surgery
134 | 6. Stereotaxic apparatus (Kopf, catalog number: Model 962)
135 | 7. Heating pad (Physitemp, catalog number: TCAT-2LV)
136 | 8. Scalpel handle (Fine Science Tools, catalog number: 10003-12)
137 | 9. Scalpel blade (Fine Science Tools, catalog number: 10015-00)
138 | 10. Fine scissors (Fine Science Tools, catalog number: 14090-09)
139 | 11. Dumont fine forceps (Fine Science Tools, catalog number: 11254-20)
140 | 12. Scraper tool (Fine Science Tools)
141 | 13. Micro Curettes (Fine Science Tools, catalog number: 10080-05)
142 | 14. Dieffenbach Vessel Clips Straight (Harvard Apparatus, catalog number: ST2 72-8815)
143 | 15. Diethrich Mini Bulldog Clamp (Harvard Apparatus, catalog number: ST2 72-8817)
144 | 16. Cotton swabs (Fisher Scientific, catalog number: 19-062-616)
145 | 17. Screwdriver (Amazon, catalog number: B0058ECJIE)
146 | 18. 000-120 screw 1/16" (Antrin Miniature Specialties, catalog number: AMS120/1B-25)
147 | 19. Dental drill (NSK, catalog number: Ultimate XL)
148 | 20. Burrs for micro drill 0.7 mm (Fine Science Tools, catalog number: 19008-07)
149 | 21. Soldering iron (Stannol, catalog number: 574104)
150 | 22. Soldering station (Weller, catalog number: WD1)
151 | 23. Solder Flux (Worthington, catalog number: 331928)
152 | 24. Solder Paste (Quick Chip, catalog number: 23271700)
153 | 25. Hair clipper (Wahl, catalog number: 9990-1201)

154 | 26. Dental LED Light (Aphrodite, catalog number: AP-016B)
155 | 27. Ground/reference wire (Phoenix Wire Inc. , catalog number: 36744MHW – PTFE)

156

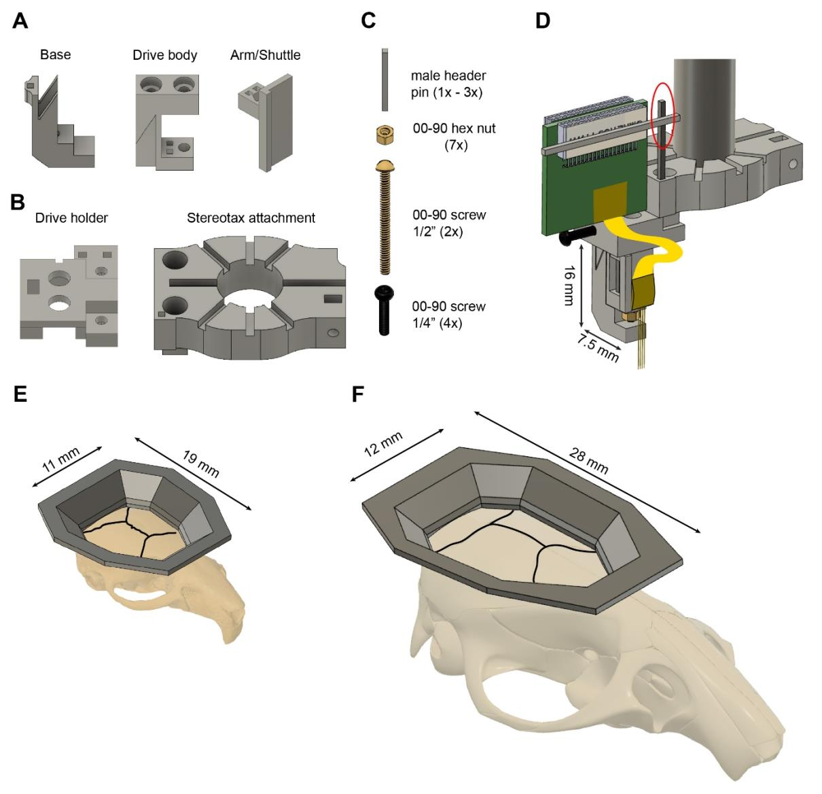
[picture p62: figure]

157 | Figure 1. Reusable 3D printed plastic microdrive and base plates for mice and rats. A. The three parts of the 3D
158 | printed plastic microdrive: a drive body, a movable arm/shuttle, and a removable base. B. 3D printed stereotaxic
159 | attachment and drive holder. All components are 3D printed using resin (Grey-v04, Formlabs Inc.). C. Additional
160 | necessary components are 00-90, 1/2” brass screw, a 00-90 brass hex nut, a 00-90, 1/4” stainless steel screw, and
161 | header metal bars. D. Stereotaxic attachment with the assembled microdrive, and a probe attached, ready for
162 | implantation (the red circle indicates the temporary soldering joint for the Omnetics connector). E and F. 3D printed
163 | plastic base plate for mice (E) and rats (F) shown on their respective skulls. The black lines represent the sutures of
164 | the skull.

Procedure

A. Microdrive assembly (Figure 2 A-M)
1. Apply a little cyanoacrylate glue (Loctite gel) on the outer surface of a 00-90, brass hex

nut and insert it into the arm.

2. Push the arm into the opening of the body and align the rectangular holes of the drive body

with the rectangular holes of the arm.

3. Insert male header pins into the drive body through the rectangular holes of the arm.

Critical step: cut the metal bars to proper length and make sure they do not extrude from

the bottom part of the drive body.

4. Move down the arm with the male header pins. Apply cyanoacrylate glue on both ends of

the male header pins and push back the male header pins into the drive body.

Critical step: do not apply excessive amount of superglue on the top of the male header

pins as it can flow out and glue the arm to the male header pins. To further prevent this,

keep enough gap between the top part of the male header pins and the arm before

application of superglue. Wait until the glue is completely cured (15-20 minutes). If the

metal bars extrude at the bottom of the drive, file them and make sure this surface is

completely flat and even.

5. Tap the plastic of the arm component through the brass nut using a 00-90 tap. The diameter

of the hole of the arm is 1 mm (right, top part) but the outer diameter of the 00-90 screw is

1.2 mm (right, bottom part).

6. Insert a 00-90, 1/2” brass screw through the drive body and the arm nut.

Critical step: make sure the head of the screw is pushed all the way inside the hole on top

of the drive body.

7. Put a 00-90, brass hex nut on the screw.

Critical step: tighten it completely and then release a quarter turn (or less). If it is too tight,

the arm cannot be moved, if it is too loose the arm can wiggle and eventually introduce a

lot of damage to the brain tissue.

8. Apply soldering flux and solder to the nut to join the screw and nut together.

Critical step: try to minimize the amount of time of soldering because excessive amount of

heat will be transferred to the plastic through the metal components. Excessive heat can

reduce the structural integrity of the plastic.

9. Apply superglue on the outer surface on a 00-90 brass nut and insert it into the base

component.

Critical step: make sure that the nut is oriented properly (right side) and it is inserted all

the way. Once inserted, check alignment with the hole (look from the top).

10. Seal the nut with playdough.

Critical step: need to prevent cement flowing into this hole during surgery.

11. Insert assembled drive body into base.
12. Insert a 00-90, 1/2" brass screw into drive body and secure drive body to base.

Critical step: hold still the base component using a plier and try to move the arm meanwhile

look for any movement of the body relative to base under a microscope. If the body moves,

then 1) the bottom of the drive might not be flat; 2) the back screw is not tightened enough,

3) the print did not come out with proper dimensions and there is extra space somewhere

between base and drive body.

Fully assembled microdrive weighs 0.67 g and its dimensions are 3.2 x 7.5 x 16 mm (width x

length x height).

Additional features:

a. The arm can be customized to any size. We share arm designs on our Github page for

64 and 32-ch silicon probes with 5 mm shank length.

b. There is a rectangular hole in the back of the base component in which a male header

pin can be ‘glued’ using dental cement. This male header pin can serve as a temporary

soldering joint during multi-probe implants.

Critical step: do not use superglue to attach this bar. The advantage of using dental

cement is that the male header pin can be removed after surgery using heat of a solder.

Applying heat to the metal bar can release it from the cement but not from the

superglue. Be careful with heat because excessive amount of heat can deteriorate the

base component.

c. The drive holder has a hole to accommodate this male header pin during probe

recovery, but it makes the alignment more difficult.

224

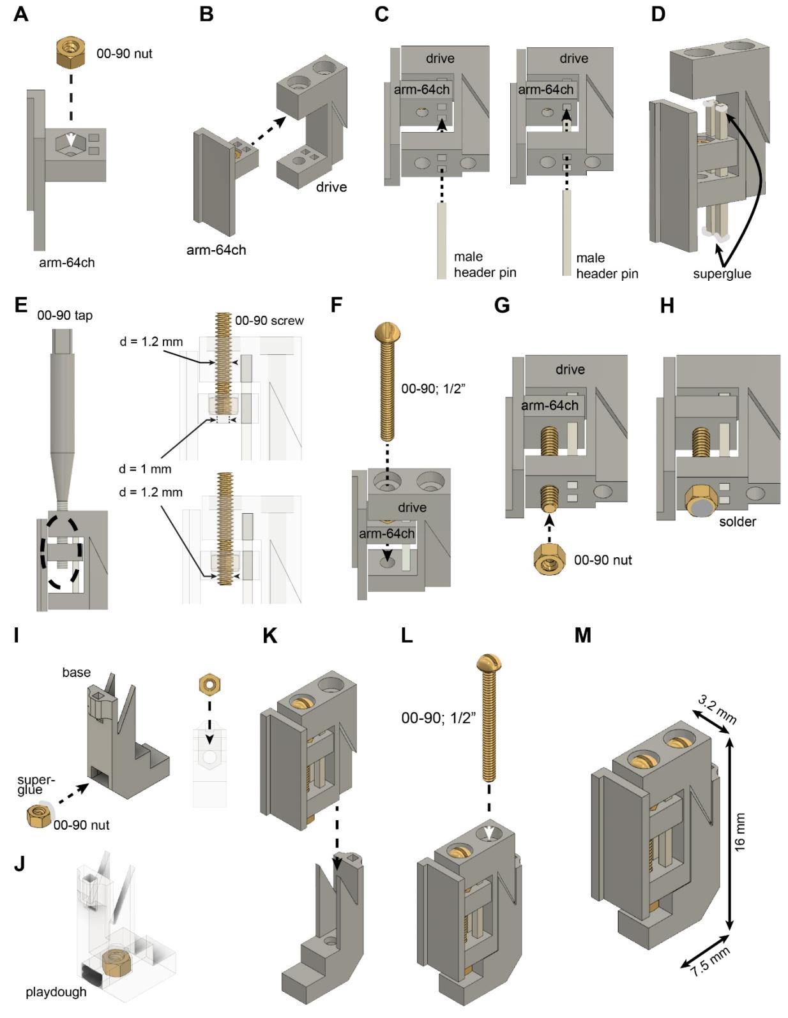
[picture p63: figure]

225 Figure 2. Assembly of recoverable microdrive. See instructions in section A above.
226

B. Drive holder and stereotax attachment assembly (Figure 3)
1. Apply superglue on the outer surface on a 00-90 brass nut and insert it into the stereotax

attachment component (Fig. 3A).

Critical step: make sure that the nut is oriented properly (similar orientation to base) and

it is inserted all the way. Once inserted, check alignment with the hole (look from the side).

2. Apply superglue on one side of a male header pin and insert it into the stereotax attachment

component (Fig. 3A).

Critical step: once the glue cured completely, apply soldering flux and solder to the metal

bar (around the height where you expect to solder your omnetics connector).

3. Insert a 00-90, 1/4" stainless steel screw (Fig. 3B).

Critical step: when attached to the arm of the stereotax, never tighten this screw too much

as it can break the plastic.

4. Apply superglue on the outer surface of a 00-90 brass nuts and insert it into the bottom of

the drive holder component (Fig. 3C).

5. Apply superglue on the outer surface of a 00-90 brass nut and insert it into the drive holder

component (Fig. 3D).

Critical step: make sure that the nut is oriented properly (similar orientation to base) and

it is inserted all the way. Once inserted, check alignment with the hole (look from the side).

6. Attach stereotax attachment to drive holder using two 00-90 1/4" stainless steel screws

(Fig. 3E, step 1).

7. Insert 00-90 1/4" stainless steel screw into drive holder component (Fig. 3E, step 2).

Additional features:

a. There are two rectangular holes on the drive holder component that can be used for

male header pins. These pins can serve as temporary soldering joint for the Omnetics

connector of the silicon probe.

b. The drive holder can be redesigned in multiple ways, e.g.: the securing screw can be

moved from the side to the front.

Supplementary video 1 showing how to assemble drive holder, stereotax attachment and

recoverable microdrive can be found here: https://www.youtube.com/watch?v=rjxaH515N64

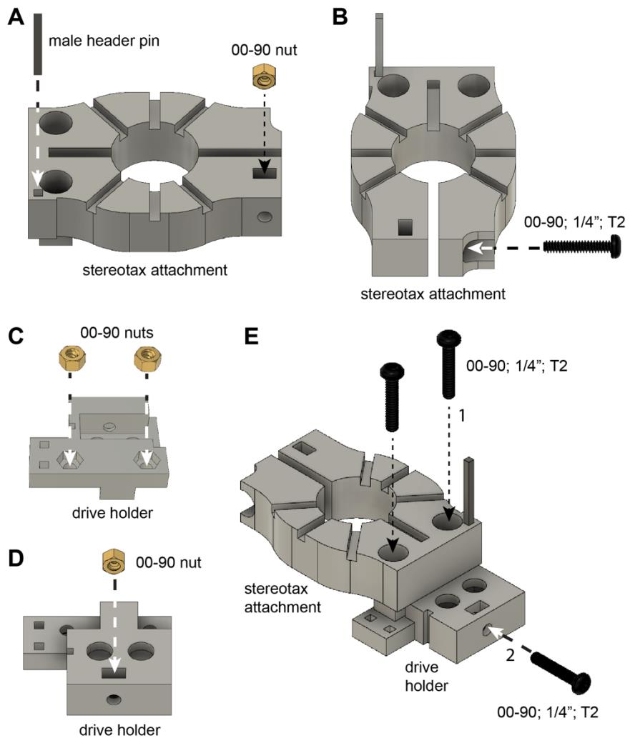
[picture p64: figure]

Figure 3. Assembly of stereotax attachment and drive holder. See instruction in section B above.

C. Attaching the probe to the microdrive (Figure 4)
1. Scratch the surface of the Omnetics connector using a blade (Fig. 4A).

Critical step: it is important to increase the surface of the plastic connector to ensure better

adhesion between Omnetics and male header pin.

2. Attach male header pin to the Omnetics connector using superglue or dental cement (Fig.

4B).

Critical step: wait until the glue is cured completely.

3. Cover the male header pin with dental cement (arrow in Fig. 4C).

Critical step: make sure to use relatively liquid cement to let it flow between the metal bar

and the Omnetics. Pay attention not let the cement flow into the Omnetics connector. In general, one male header pin is enough for 32-ch silicon probes but two should be used

for 64-ch probes.

4. Apply soldering flux and solder to both ends of the male header pin (arrow in Fig. 4D).

Critical step: excessive heat can melt the cement and/or Omnetics. Try to apply as fast as

possible.

5. Hold the drive with one helping hand and the probe with another one. Align the probe

backend with the arm of the drive (Fig. 4E).

6. Apply superglue or dental cement to the arm (Fig. 4F).
7. Attach the backend of the probe to the arm. Fine tune the position of the probe using a

tweezer (Fig. 4G).

Critical step: there is 10-15 seconds while the backend of the probe can be moved, and

alignment can be fine-tuned.

8. Holding the stereotax attachment with hand, attach drive holder to the drive and tighten the

screw (Fig. 4H).

Critical step: make sure it is tight enough but do not force it because the metal screw can

break the plastic drive.

9. Solder the Omnetics connector to the male header pin (circle in Fig. 4I).
10. Realign the drive inside the drive holder (if necessary). Hold the stereotax attachment with

your hand and flip it upside down. Loose the screw of the drive holder and realign the drive

(Fig. 4J).

11. Tighten the screw again (Fig. 4K).

Critical step: make sure it is tight enough but do not force it because the metal screw can

break the plastic drive.

12. Make sure there is no tension on the flexible cable of the silicon probe (Fig. 4L).

Critical step: if there is tension on the cable, solder the Omnetics to a new position in which

the tension is released.

Supplementary video 2 showing how to attach a silicon probe to a recoverable microdrive can be

found here: https://www.youtube.com/watch?v=2L5RHcbsU7o

298

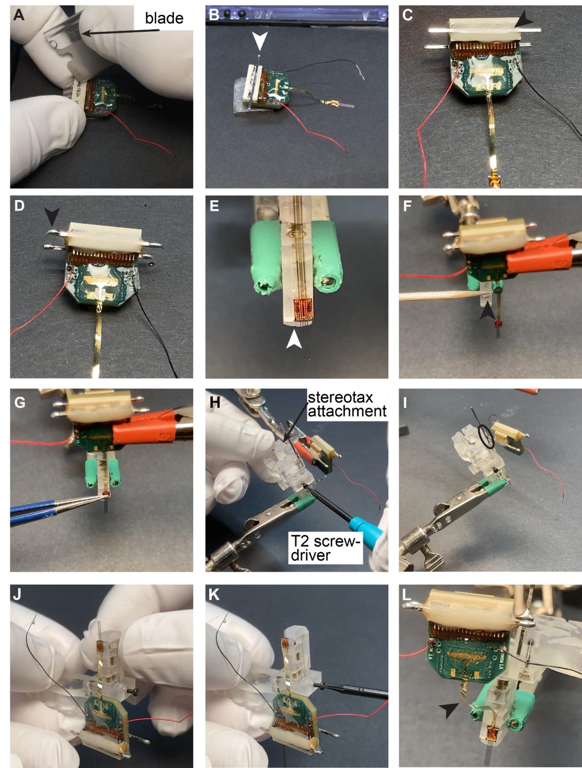
[picture p65: figure]

299 Figure 4. Attaching silicon probe to recoverable microdrive. See instruction in section C above.

300

D. Attaching copper mesh to mouse base plate
1. Cut a 7cm by 7cm square of copper mesh (Fig. 5A).
2. Mark the interior of the base plate at the center of the copper mesh with a pen and carefully

cut out the interior with a small scissor (Fig. 5B and 5C).

3. Realign the copper mesh to the base plate and mold the mesh to the shape of the plastic

base (Fig. 5D).

Critical step: make sure the copper mesh does not overhang at the bottom.

4. Attach the copper mesh to the base plate using very liquid dental cement (Fig. 5E).

Critical step: The cement must be liquid enough to flow between the holes of the copper

mesh to attain a strong bond to the plastic base.

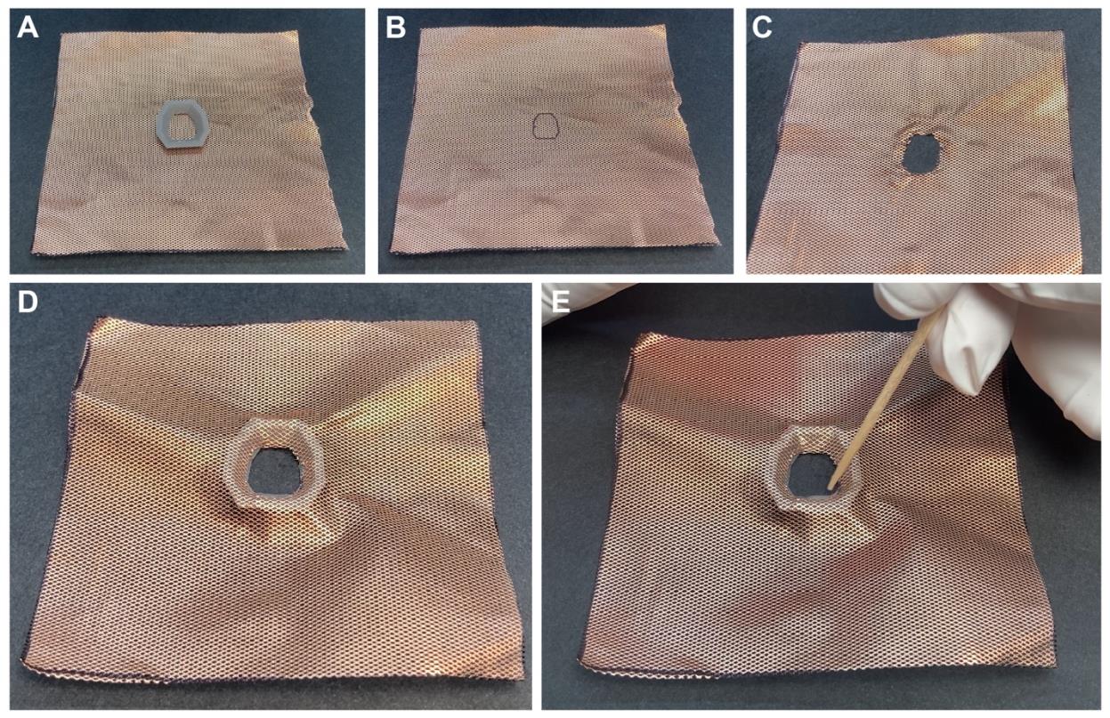
[picture p66: figure]

Figure 5. Preparing base plate for mice. A. Copper mesh with baseplate. B. Cutout of the interior of the base plate.

C. Cutout at the center of the copper mesh. D. Realigned copper mesh to the base plate. E. Attachment of the copper

mesh to the base plate with dental cement.

E. Attaching copper mesh to rat base plate (Figure 6)
1. Cut an 8 cm by 16 cm piece of copper mesh. Fold it in the middle to get 8 by 8 cm double

layer of copper mesh (Figure 6A).

Critical step: apply soldering flux and solder in different points (Figure 6B).

2. Mark the interior of the base plate on the copper mesh (Figure 6C and D).
3. Cut out the copper mesh.
4. Attach the copper mesh to the base plate (Figure 6E).

Critical step: make sure the copper mesh does not overhang at the bottom.

5. Attach copper mesh to base plate using very liquid dental cement (Figure 6F).

Critical step: if the cement is not liquid enough it cannot flow between the holes of the

copper mesh and it cannot attach the copper mesh to the plastic properly.

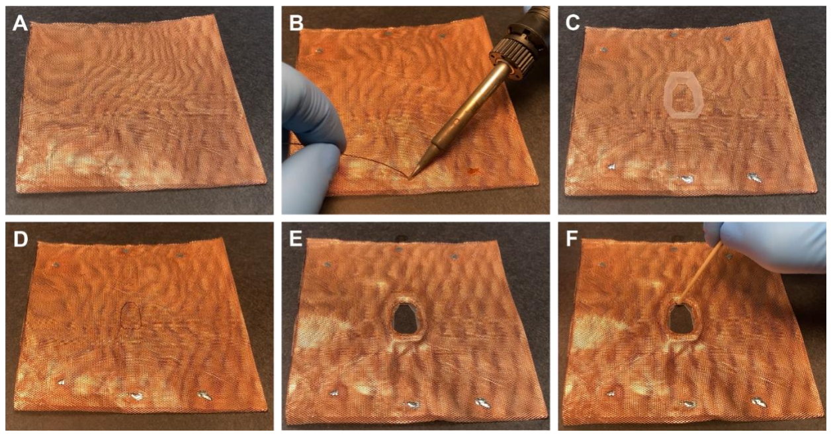
[picture p67: figure]

Figure 6. Preparing base plate for rats. A. Copper mesh folded into a square. B. Applying solder to the copper

mesh. This will prevent the opening of the folded, double-layer copper mesh during surgery. C. Copper mesh with

baseplate. D. Cutout at the center of the copper mesh. E. Realigned copper mesh to the base plate. E. Attachment of

the copper mesh to the base plate with dental cement.

F. Preparing ground and reference wire (Figure 7)
1. Cut the ground wire to the appropriate length and remove the insulation from both sides

(Figure 7A).

2. Apply solder to the uninsulated part of the wire (Figure 7B).
3. Cut the end of the wire which will be soldered to the screw very short (not to let it longer

than the head of the screw, (Figure 7C).

4. Hold a 000-120, 1/16” pan head screw in a wise or helping hand and apply liquid soldering

flux on the head of the screw (Figure 7D, arrow).

5. Apply small amount of solder to the head of the screw (Figure 7E).

Critical step: make sure not to fill up the hole for the screwdriver with solder.

6. Solder the ground wire to the head of the screw (Figure 7F).

Notes: store the ground wire in alcohol (at least 70%) until surgery.

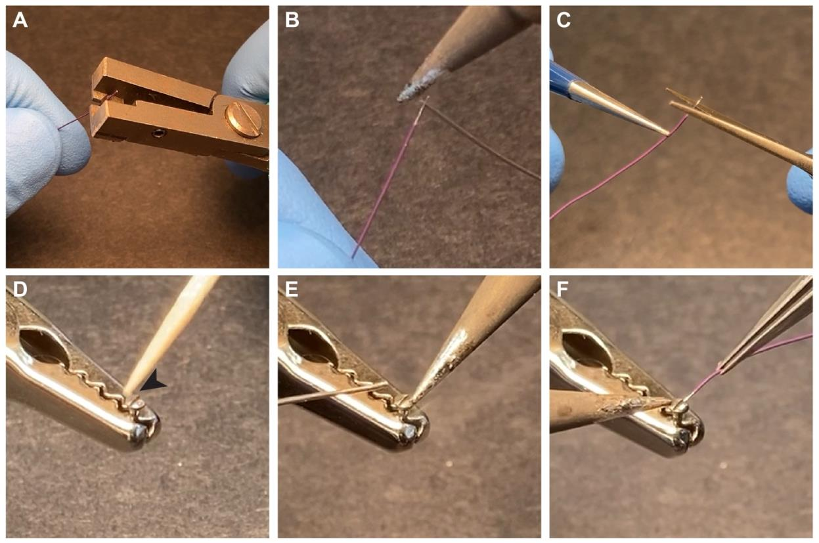
[picture p68: figure]

Figure 7. Preparing ground screw. A. Wire isolation is stripped with a wire stripper. B. Solder is applied to the

uninsulated part of the wire. C. Cut the stripped wire such that is same length as the head of the screw. D-F. Flux paste

is applied (D) to the steel ground screw (000-120, 1/16" screw), and a drop of solder is attached to the screw (E) before

the ground wire is soldered to it (F).

G. Implanting procedure

Numbered steps are not shown in any of the pictures.

1. Prepare the stereotaxic apparatus and tools
a. Place the heating pad under the position of the ear bars.
b. Sterilize surgical instruments.
c. Weigh the animal subject.

2. Anesthesia and pre-incision preparations
a. The animal is anesthetized for 3 min (after it passes out) in an anesthesia-bucket with

2.5:1.5 (Anesthetic % to Airflow ratio).

b. Fixate animal with ear bars and closed ventilation nosepiece. Once animal is in the

stereotax the level of anesthesia can be lowered (1.2 – 2%). Apply a local anesthetic to

the tips of the ear bars before insertion them into the ears (LMX-4 Lidocaine 4% topical

cream).

c. Removing the fur on the head of the animal around the surgery incision using either

Nair-hair remover or a hair trimmer.

d. The hairless skin is cleaned with the antiseptic solution (Povidone-Iodine – 10% topical

solution). The skin is cleaned by three separate anti septic cleanings. Performed with

Kimtech wipes by anterior to posterior swipes. The last swipe must be done in one

stroke, to minimize infections. Between each swipe, the skin is cleaned by 70% alcohol.

3. Incision and skull cleaning
a. Inject bupivacaine (0.4 - 0.8 ml/kg of a 0.25% solution) as a local anesthesia

subcutaneously along the scalp midline. Make one injection site and distribute the

anesthetics along the midline.

b. A median incision is made from the position of the eyes to the back of the skull (neck).
c. The skin is released from the skull and pulled aside and fixated with four bulldogs. The

bulldogs are attached to the second skin layer.

d. Scrape the skull with a sharp object (forceps or scalpel) to remove any tissue along the

top flat surface of the skull. This minimizes electric noise artifacts and affirms a strong

bond of the 3D printed base.

e. Clean the skull with saline and vacuum suction.
f. Clean the skull with hydrogen peroxide and rinse with saline. The hydrogen peroxide

is applied with cotton swabs (about 5 seconds) and rinsed quickly thereafter thoroughly

with saline.

g. Cauterize any bleedings along the skull and exposed skin.

4. Attaching the base to the skull
a. Mix four drops of base with 1 drop of catalyzer. Paint, using a brush, the whole surface

of the cleaned and dried skull and let it dry (Figure 8A). Mix a new solution of

Metabond with powder: 4 drops of base, one drop of catalyzer and 2 scoops of powder

and paint the skull surface with Metabond. Pay attention to paint along the edge of the

skull surface.

Critical step: prepare the Metabond on ice as it will extend the working time. We

recommend using the clear powder which makes it possible to see through it (the

sutures and skull landmarks remain visible).

b. Paint the bottom surface of the 3D printed base with Unifast LC cement (arrow) and

align it above the skull and attach it to the skull before it solidifies (Figure 8B).

Critical step: paint only a small portion of the base at a location far from the region of

400 | interest. | This | step | helps | to | quickly | attach | the | base | to | the | skull.

This step can also be performed with metabond, but the curing takes longer.

c. Cure the Unifast LC using blue light (10-20 seconds, Figure 8C).
d. Paint along the inner contact line between the hat base and the skull with relatively

liquid dental cement, creating a sealed area inside the hat (Figure 8D, black arrow –

already sealed side, white arrow – not yet sealed).

Critical step: the cement should be liquid enough to be able to flow between the skull

| and base.

The finished result should look like figure 12A-C.

5. Craniotomy marking and screw placement
a. Align Bregma and Lambda in the same horizontal plane. Determine the position of

Bregma using stereotactic coordinates with a fine syringe needle attached to the

stereotactic arm.

b. Calculate the relative positions of the probe incision points.
c. Mark the positions of the craniotomies with a scalpel and a pen (fill the scalpel-drawn

lines with the pen).

d. Mark the position of the reference and ground screws with the scalpel/pen.
e. Remove the stereotaxic arm.

f. Drill the holes for ground screw over cerebellum with the drill (0.7 mm). If bleeding

occurs, rinse with saline and vacuum suction until the bleeding stops. Screw the ground

screw in (Figure 8E). Begin with a slight counterclockwise turn.

Critical step: for mice, allow a margin of about 0.5 mm (about the height of the

forceps). In rats, screw the screws tight. Position the head of the screw in a way that

ground cable is not on the way (facing outward).

Note: 125 µm steel wires can also be used for reference and ground instead of screws.

g. Cover and completely seal the ground screw with dental cement (Figure 8F, arrow).

Note: we recommend using Unifast LC cement as it can be fully cured in 20 seconds.

6. Craniotomy
a. Using a 0.7 mm drill prepare the craniotomy (Figure 8G). Rinse with saline and the

vacuum suction to insure visibility while drilling.

Critical step: clean around the craniotomy with the drill or the scraping/sharp

scooping tool. Remove the dura with a hooked shaped needle at the incision points of

the probes: Bend the tip of the 30G needle to form the hook shape to create a better

grip-angle to pull the dura without damaging the cortex. You can lift the dura up while

pulling back with the needle tip and perform the cut with a scalpel. Avoid blood vessels.

Apply saline and Gelfoam to the craniotomy to maintain a wet brain surface.

7. Probe implantation
a. Attach the implantation tool with a silicon probe to the stereotax arm and position the

silicon probe according to the specified surface coordinates (Figure 8H).

Critical step: drive the silicon probe to the surface of the brain and mark the

dorsoventral coordinate. Implant the probe to the desired target depth.

b. Attach the base of the microdrive to the skull and hat-base, with dental cement

(Figure 8I).

Critical step: use relatively liquid dental cement to let it flow between the skull and

base component but be careful not to let it flow into the craniotomy. Do not ever touch

the microdrive. If the gap is too big, start building up cement from the skull.

Note: we recommend using Unifast LC cement as it can be fully cured in 20 seconds.

As this step can take multiple rounds of application of dental cement, fast curing can

save significant time on the overall time of the surgery.

c. Fill up all the gap with dental cement between the base component and the skull surface

(Figure 8J).

d. Apply silicone to the craniotomy, letting the silicone run along the shanks, sealing the

craniotomy completely. This protects the brain long term and limits bleedings and

coagulation (Figure 9K).

Note: alternatively apply paraffin oil/wax to the craniotomies with a narrow forceps

and heat (using the soldering tip).

e. Loosen the screw of the drive holder using a T2 screwdriver (Figure 9L).
f. Detach the probe PCB from the stereotax attachment (Figure 9M, black circle).

Critical step: lay down the probe PCB on the copper mesh, make sure there is no

tension on the flexible cable.

g. Move the stereotax arm upwards (Figure 9N, dashed arrow).

Critical step: monitor the shanks while moving upwards with the seterotax. If there is

any movement of the shanks, stop immediately and try to check whether everything is

properly aligned.

8. Building copper mesh cage for mice
a. Attach a male header pin (Figure 9O, arrow) to the plastic base/skull. Hold the metal

bar with a tweezer until the dental cement is cured with blue light.

Critical step: bend the metal bar (making an L-shape with 100-120 degrees angle) and

apply dental cement to this short, bent part of the metal bar and attach it to the base.

Make sure to cut the metal bar to the proper height before attaching it to the base.

b. Apply solder to the tip of the metal bar (Figure 9P, arrow).

Critical step: do not apply excessive amount of heat (long time of soldering) because

the heat transferred by the metal can melt the dental cement causing structural

deterioration of the copper mesh cage.

c. Attach the probe PCB to the male header pin installed in the previous step (Figure 9Q).

d. Attach three more male header pins in the three remaining corners (Figure 9R, arrows).

Apply solder on the tip of all of them.

e. Attach a male header pin across one side. Repeat with the remaining open sides

(Figure 9S).

Critical step: cut the length of the metal bar to the proper length before soldering it to

the cage.

f. Cut the copper mesh along the diagonals, all the way to the plastic base (Figure 9T).
g. Fold up the copper mesh and cut it to appropriate height (Figure 9U, arrow).
h. Solder the copper mesh to the male header pins (Figure 9V).
i. Repeat the cutting, folding, and soldering on all sides (Figure 9W).
j. Attach ground wire from probe PCB and from ground screw to copper mesh using

solder (Figure 9X).

Critical step: arrange the wires inside the cage in a way that does not block the access

to the screw of the microdrive.

Note: if using separate ground and reference wires, attach them accordingly.

k. Using the handle of a tweezer (Figure 9Y, circle) smooth out the edges, if necessary.

Secure the edges with solder if necessary.

Supplementary video 3 showing preparation of mouse base plate and implantation of silicon

probe can be found here: https://www.youtube.com/watch?v=NjBai0FpuOE

9. Building copper mesh cage for rats
a. Cut the copper mesh along the diagonals, all the way to the plastic base (Figure 10O).
b. Repeat with remaining three corners (Figure 10P).
c. Fold up the copper mesh and attach the pieces together using solder (Figure 10Q).
d. Using the handle of a tweezer smooth out the edges, if necessary (Figure 10R).

Critical step: make sure there is no sharp edge around the plastic base.

e. Using scissors, cut the height of the copper mesh to the appropriate height all around

(Figure 10S). Figure 10T shows the completed step.

f. Paint the outer surface of the copper mesh with relatively liquid dental cement using a

large surface spatula (Figure 10U).

Critical step: make sure that dental cement is not dripping onto the fur or the face of

the rat. Make sure that the plastic base – copper mesh connection is properly covered

(if not covered completely, it can introduce a lot of muscle artifacts).

Note: we recommend using a Unifast Trad cement.

g. Cover the top of the copper mesh with dental cement (Figure 10V).

Note: follow the instructions as in Figure 10U.

h. Steps are not shown in figure: solder the male header pin of the probe PCB to the copper

mesh. Solder probe ground and wire of ground screw to the copper mesh.

i. Cover the top with Coban™ tape. Turn off the anesthesia and release the animal from

the stereotaxis setup.

10. Post anesthesia
a. Weigh the animal again to determine the weight of the crown.
b. Put the animal in a home cage without bedding and place the cage on a heating pad the

first night.

c. Inject Buprenex subcutaneously after 20 min (0.05 - 0.1 mg/kg).
11. General notes
a. Apply mineral oil to the eyes of the animal at regular intervals.
b. To keep the animal hydrated the first few days, provide an aqua-gel and a small

container with water. Provide regular rodent pills.

528

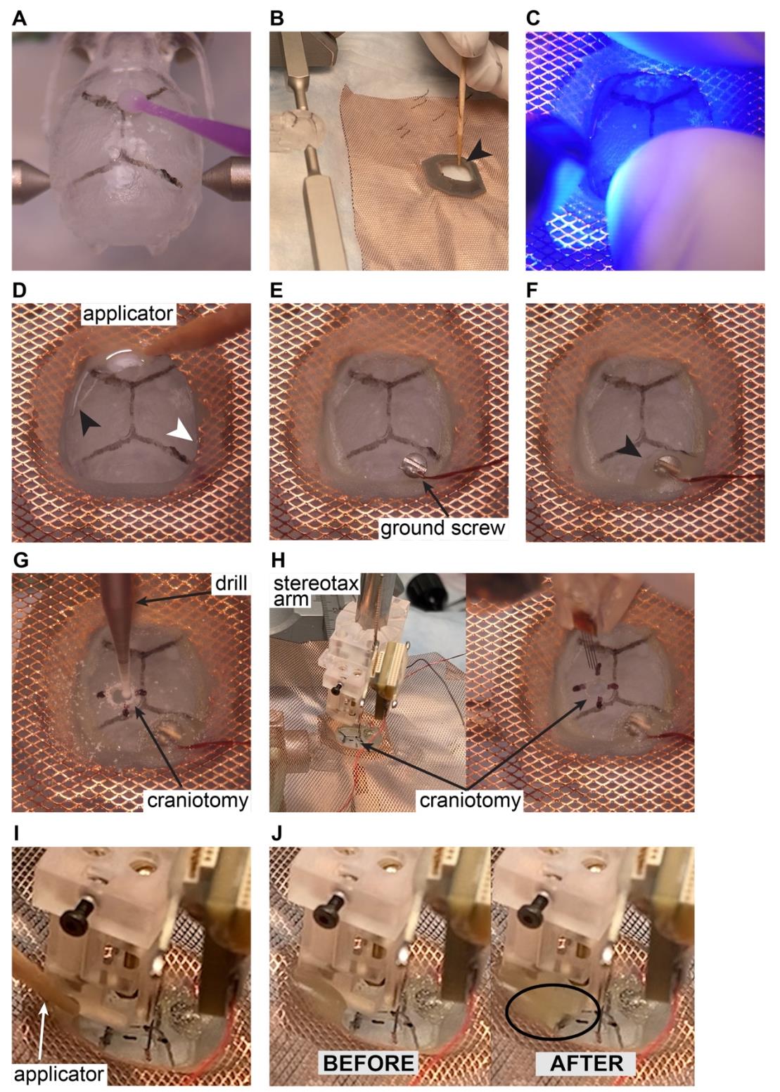
[picture p69: figure]

529 | Figure 8. Silicone probe implantation in rodents. The ‘surgery’ is performed on a 3D-printed mouse skull. Note,
530 | that all these steps are identical for mice and rats.

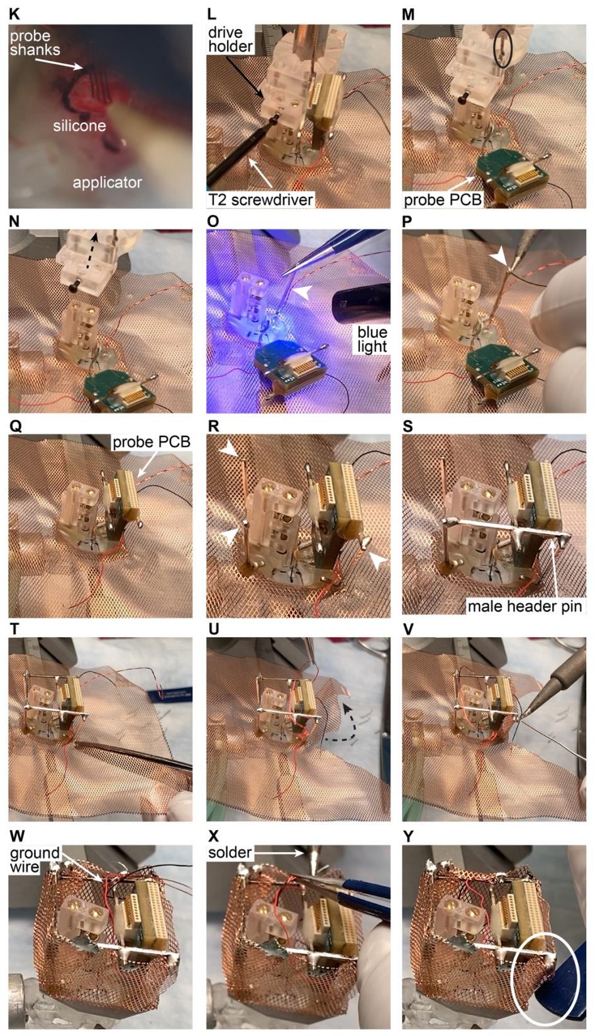
[picture p70: figure]

531

532 | Figure 9. Silicone probe implantation in rodents (K-N) and cap building in mice (O-Y). The ‘surgery’ is
533 | performed on a 3D-printed mouse skull. Note, that steps K-O are identical for mice and rats.
534

535

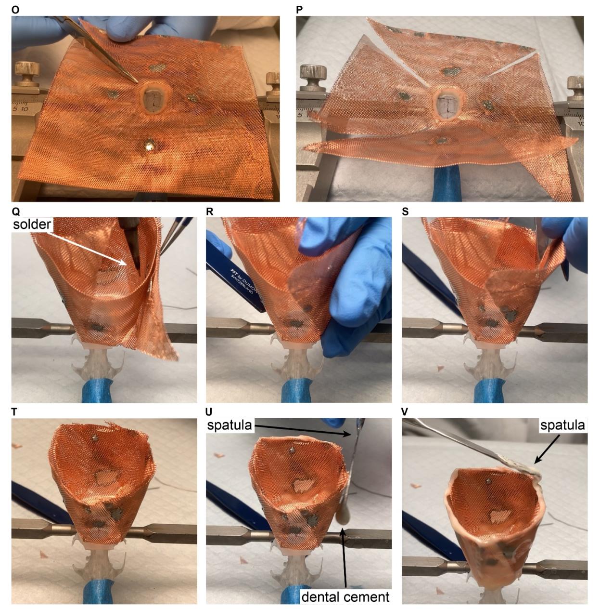
[picture p71: figure]

536 Figure 10. Cap building in rats. The ‘surgery’ is performed on a 3D-printed rat skull.
537
538 | H. Probe recovery procedure (Figure 11)
539 | 1. Align the drive holder with the drive using the stereotactic frame. Once the position is
540 | aligned in the x-y plane, move the drive holder down (Figure 11A, step 1). Next, secure

the top of the drive with the screw located on the side of the drive holder (Figure 11A, step

2).

Critical step: do not tighten the screw too strongly as the metal screw can break the plastic

drive.

2. Loosen the back screw from the base (Figure 11B, step 1) and move the drive carefully

upwards (Figure 11B, step 2).

Critical step: monitor the shanks of the probe under microscope during the entire recovery

procedure and, if any unexpected movement of the probe is observed, return to the previous

step to make sure that everything is secured properly.

3. Release the stereotax attachment from the stereotax arm and clean the probe. Store the

probe attached to the stereotax attachment.

Note: probe can be cleaned by initially rinsing it in distilled water, then contact lens

solution (containing protease) and distilled water again; each washing step should last for

at least 12 hours. If extra tissue or debris is detected between the shanks, it can be removed

by a fine needle under a microscope. Another way to clean the probe is by inserting the it

into 2-4% agarose gel a couple of times. This will push any debris away from the sites

along the shanks.

Supplementary video 4 showing how to recover a silicon probe using a recoverable microdive

can be found here: https://www.youtube.com/watch?v=T5gyuZVKXo8

561

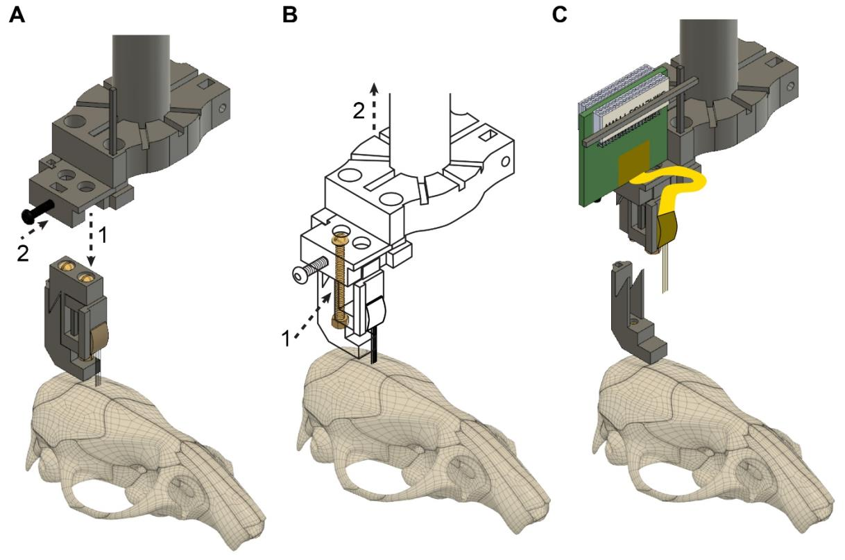
[picture p72: figure]

562 | Figure 11. Probe recovery. A. The implantation tool is attached to the microdrive (step 1) and is fixed with the black
563 | screw (step 2). The flexible cable and Omnetics connector are not shown. B. The back screw is loosened completely
564 | (step 1), detaching the microdrive from the base, then the implantation tool is raised using the stereotax manipulator
565 | (step 2), explanting the probe. C. The fully recovered microdrive and silicon probe with flexible cable and Omnetics
566 | connector. The probe shanks can be cleaned and a new microdrive base can be attached, making the whole device
567 | ready for reimplantation in a new animal subject.

568

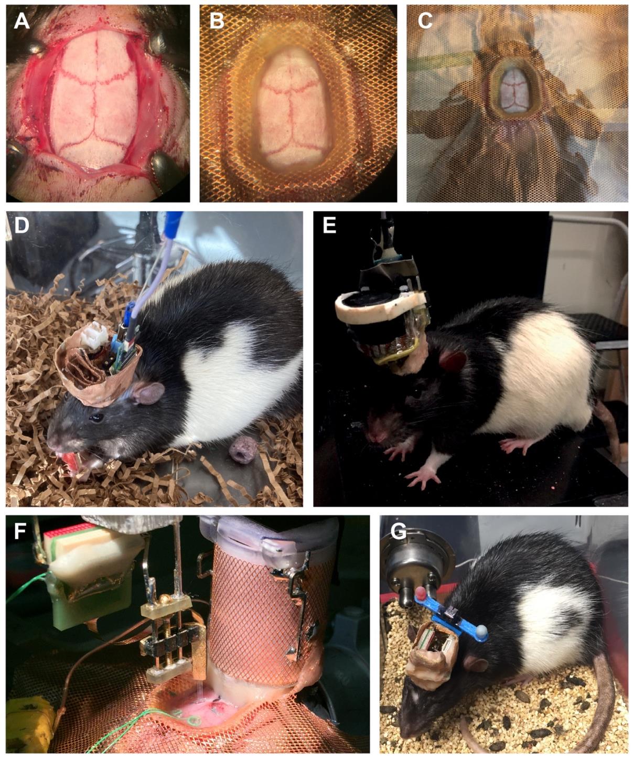
[picture p73: figure]

569 | Figure 12. Applicability of the hybrid base. A. Exposed skull before base is attached. B-C. Close up (B) and wide
570 | view (C) of the attached hybrid cap system. D. Peltier cooling device with passive cooling, thermistor and silicon
571 | probes implanted at two different insertion sites. E. Peltier cooling device with an active 20 mm electric fan for
572 | cooling, thermocouple, wires, and silicon probe implants. F. Bilateral CA1 probe implants (shown during implantation
573 | of the left hemisphere implantation) with dry ice cooling chamber already implanted. G. Virus injected animal for
574 | optogenetic experiments. Four 50-µm diameter optic fibers were implanted with two diodes along with a silicon probe

in CA1. Two diodes (blue bar) are attached for head position tracking via ceiling mounted camera. Panels A-C and E-

G from (Petersen and Buzsáki, 2020). Rat shown in panel D is from an unpublished ongoing study. All pictures are

of Long Evans rats.

Figure 12, panel D-G show the wide applicability of the hybrid base, for silicon probe recordings

with temperature manipulations and optic fiber stimulation.

Notes

Members of our labs have performed invasive silicon probe implant surgeries on hundreds of

rodents (mice and rats) just within the last year and have used variations of the base plate system

for most of our probe implantations during the last few years.

According to a recent internal survey based on about 25 silicon probes with the recoverable

microdrive, on average, each probe was recovered two times and reimplanted successfully in new

animal subjects. All users were able to recover silicon probes successfully if there was no

surgery/time of implant related complications. Coagulated blood, dried bone wax or debris

attached to the shanks were the most frequent cause of complication resulting in failed probe

recovery. Before attempting a probe recovery in these cases, we recommend soaking the implanted

silicon probe for at least 10 minutes in saline and removing as much debris beforehand as possible.

Acknowledgments

We would like to thank our early adaptors in Royer, Diba and Buzsaki Labs for testing the

microdrive and the baseplate and for providing feedback. We also thank Dmitry Rinberg for advice

and feedback on designs. Supported by U19 NS107616, U19 NS104590, R01 MH122391,

NeuroNex MINT (NSF 1707316) and The Lundbeck Foundation.

Competing interests

E.Y. is co-founder of NeuroLight Technologies, a for-profit manufacturer of neurotechnology. The

remaining authors have no conflict of interest.

Ethics

All experiments were approved by the Institutional Animal Care and Use Committee at New York

University Medical Center.

607

608 | References
609 | Chung, J., Sharif, F., Jung, D., Kim, S., and Royer, S. (2017a). Micro-drive and headgear for
610 | chronic implant and recovery of optoelectronic probes. Scientific Reports 7, 2773.
611 | Chung, J.E., Magland, J.F., Barnett, A.H., Tolosa, V.M., Tooker, A.C., Lee, K.Y., Shah, K.G.,
612 | Felix, S.H., Frank, L.M., and Greengard, L.F. (2017b). A Fully Automated Approach to Spike
613 | Sorting. Neuron 95, 1381-1394.e6.
614 | Juavinett, A.L., Bekheet, G., and Churchland, A.K. (2019). Chronically implanted Neuropixels
615 | probes enable high-yield recordings in freely moving mice. ELife 8, e47188.
616 | Jun, J.J., Steinmetz, N.A., Siegle, J.H., Denman, D.J., Bauza, M., Barbarits, B., Lee, A.K.,
617 | Anastassiou, C.A., Andrei, A., Aydın, Ç., et al. (2017). Fully Integrated Silicon Probes for High-
618 | Density Recording of Neural Activity. Nature 551, 232–236.
619 | Petersen, P.C., and Buzsáki, G. (2020). Cooling of Medial Septum Reveals Theta Phase Lag
620 | Coordination of Hippocampal Cell Assemblies. Neuron 107, 731-744.e3.
621 | Sariev, A., Chung, J., Jung, D., Sharif, F., Lee, J.-Y., Kim, S., and Royer, S. (2017). Implantation
622 | of Chronic Silicon Probes and Recording of Hippocampal Place Cells in an Enriched Treadmill
623 | Apparatus. JoVE (Journal of Visualized Experiments) e56438.
624 | Steinmetz, N.A., Aydin, C., Lebedeva, A., Okun, M., Pachitariu, M., Bauza, M., Beau, M.,
625 | Bhagat, J., Böhm, C., Broux, M., et al. (2020). Neuropixels 2.0: A miniaturized high-density
626 | probe for stable, long-term brain recordings. BioRxiv 2020.10.27.358291.
627 | Vandecasteele, M., M, S., Royer, S., Belluscio, M., Berényi, A., Diba, K., Fujisawa, S.,
628 | Grosmark, A., Mao, D., Mizuseki, K., et al. (2012). Large-scale Recording of Neurons by
629 | Movable Silicon Probes in Behaving Rodents. JoVE (Journal of Visualized Experiments) e3568.
630 | Vöröslakos, M., Petersen, P., Vöröslakos, B., and Buzsáki, G. (2020). Metal microdrive and head
631 | cap system for silicon probe recovery in freely moving rodent. BioRxiv 2020.12.20.423655.
632 | Wu, F., Stark, E., Ku, P.-C., Wise, K.D., Buzsáki, G., and Yoon, E. (2015). Monolithically
633 | Integrated μLEDs on Silicon Neural Probes for High-Resolution Optogenetic Studies in
634 | Behaving Animals. Neuron 88, 1136–1148.

635

Supplementary videos

Supplementary video 1. Microdrive, drive holder and stereotax attachment assembly.

https://www.youtube.com/watch?v=rjxaH515N64

Supplementary video 2. Attaching a silicon probe to a recoverable microdrive. A 32-channel

µLED-probe is attached to a recoverable microdrive.

https://www.youtube.com/watch?v=2L5RHcbsU7o

Supplementary video 3. Preparation of mouse base plate and implantation of silicon probe.

A 32-channel µLED-probe is implanted in a plastic mouse skull using a recoverable microdrive

and base plate system.

https://www.youtube.com/watch?v=NjBai0FpuOE

Supplementary video 4. Silicon probe recovery using a recoverable microdrive. A 32-channel

µLED-probe is recovered from a plastic mouse skull.

https://www.youtube.com/watch?v=T5gyuZVKXo8
