buzsakilab/3d_print_designs/Microdrives/Metal_recoverable/assembly_instructions_microdrive_metal_v10.pdf

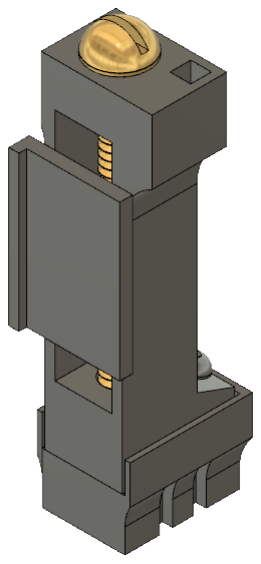
[picture p78: figure]

Design name: metal_v10
Travel distance: 5.7 mm
Shell base: 3.6 x 4.7 mm (WxL)
More information is needed:
- contact me (Misi Voroslakos) directly at voroslakos@gmail.com

Recoverable, metal microdrive

00-90 screw
1/2”

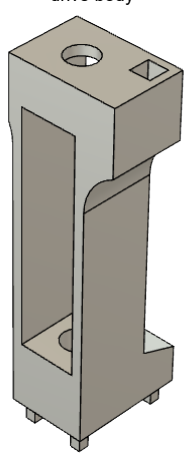
[picture p79: figure]

arm/shuttle | drive body

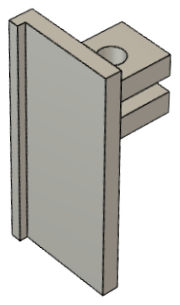
[picture p80: figure]

base

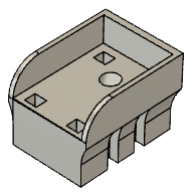
[picture p81: figure]

000-120 screw
1/8”

metal bar

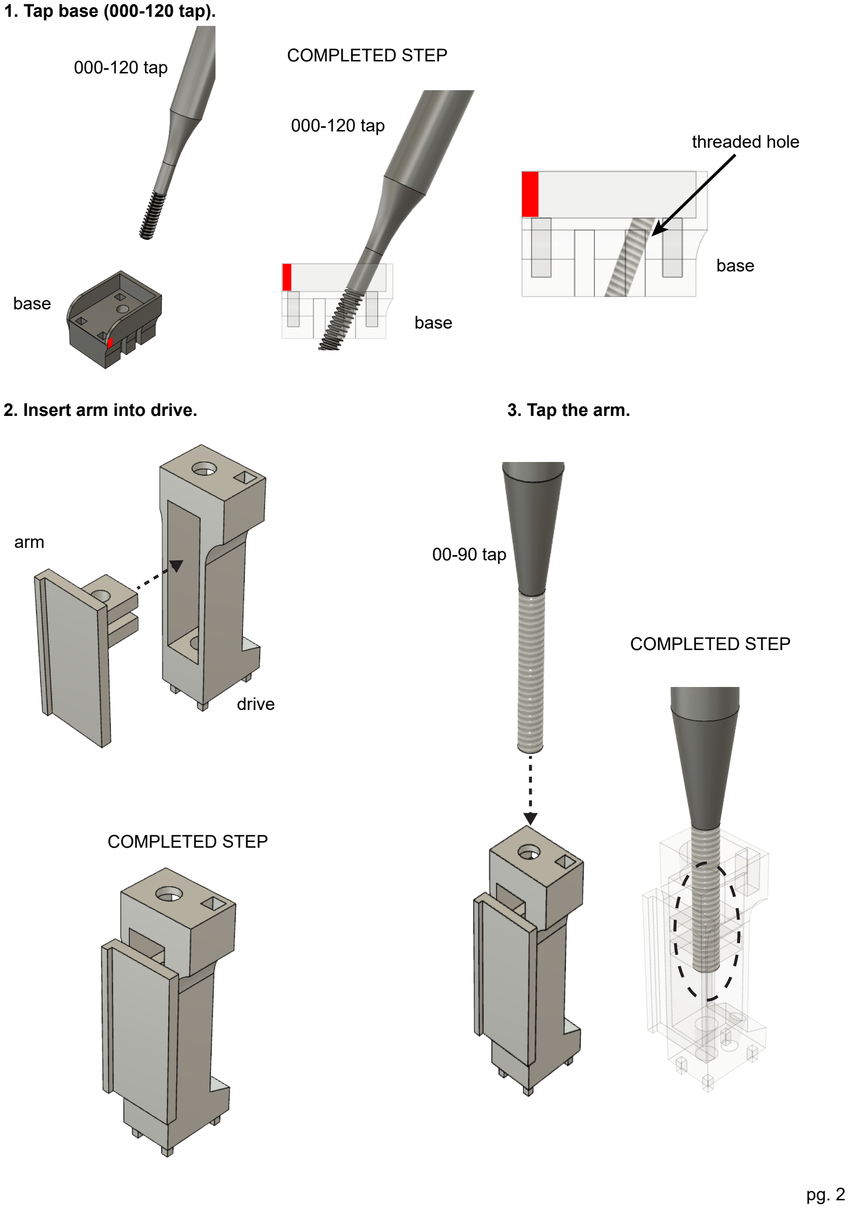
[picture p82: page 2]

1. Tap base (000-120 tap).

base
base

base

000-120 tap

000-120 tap
threaded hole

COMPLETED STEP

pg. 2

2. Insert arm into drive. | 3. Tap the arm.

COMPLETED STEP

COMPLETED STEP

00-90 tap arm

drive

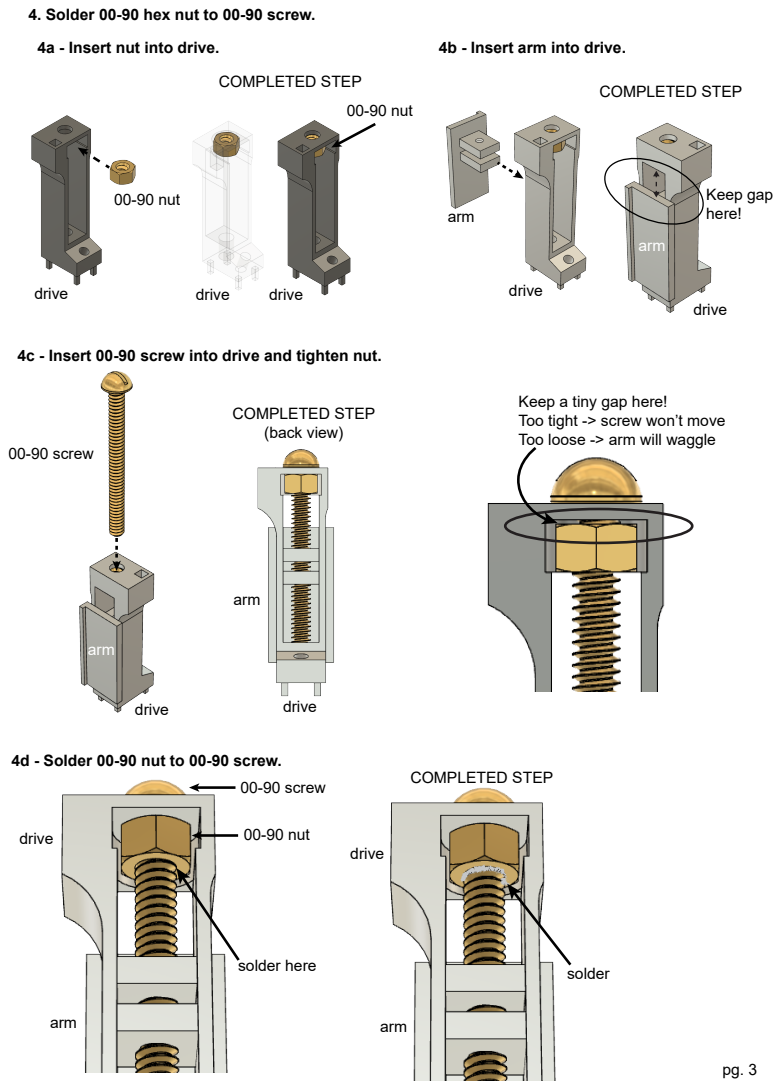
[picture p83: page 3]
COMPLETED STEP (back view); drive; arm; 00-90 screw; COMPLETED STEP; solder here; solder; 00-90 nut; 4a - Insert nut into drive.; 4b - Insert arm into drive.; Keep gap here!

4. Solder 00-90 hex nut to 00-90 screw.

4c - Insert 00-90 screw into drive and tighten nut.

Keep a tiny gap here!
Too tight -> screw won’t move
Too loose -> arm will waggle

4d - Solder 00-90 nut to 00-90 screw.

6. Attach base to drive.

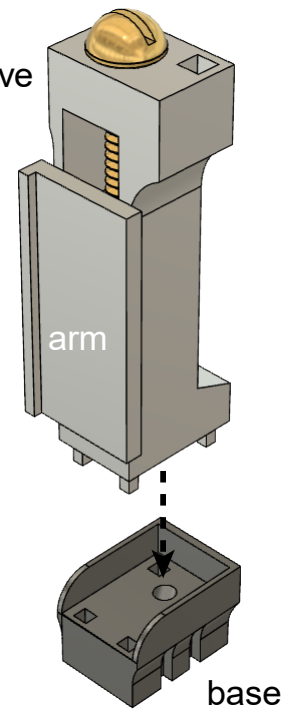
[picture p84: figure]
base; arm

drive

COMPLETED STEP | COMPLETED STEP

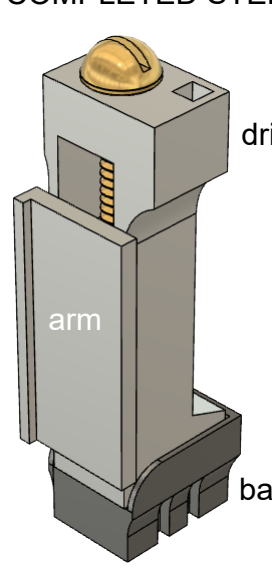
[picture p85: figure]
arm

base

drive

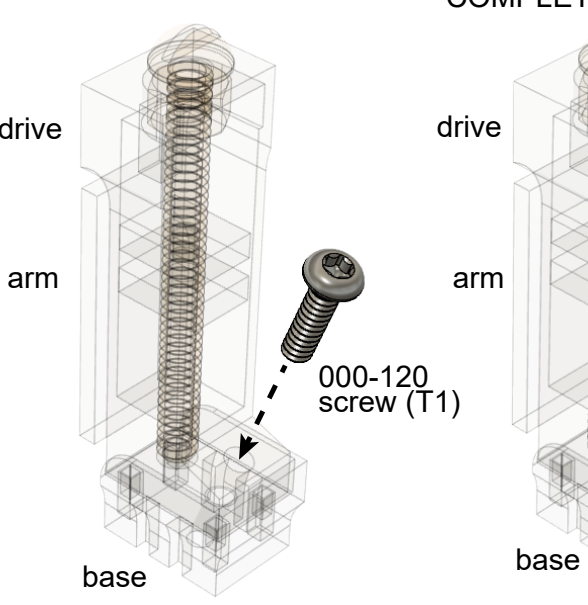
[picture p86: figure]
base; drive; 000-120 screw (T1); arm

drive

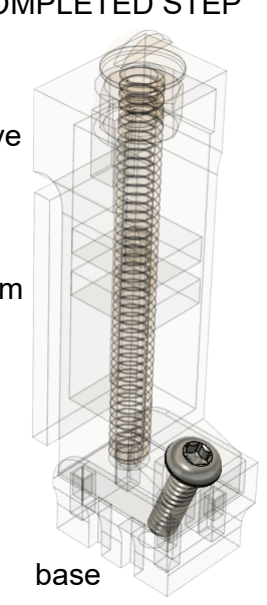
[picture p87: figure]

### 7. Insert metal bar into drive (if used during surgery). Use dental cement to secure it!

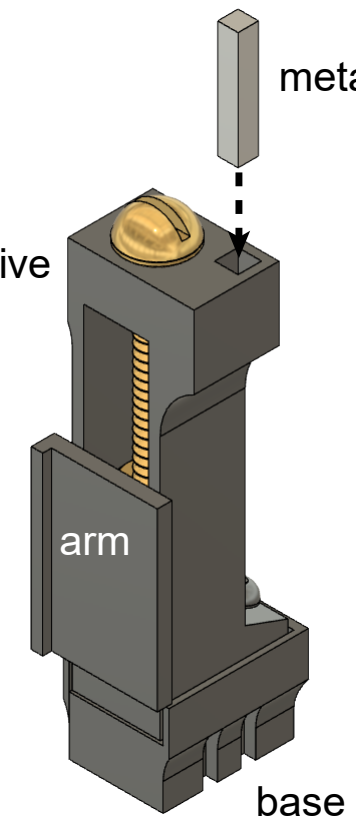
[picture p88: figure]
arm; base

metal bar

drive

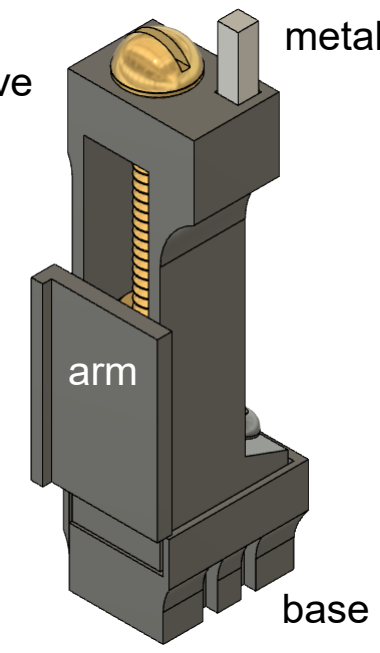
[picture p89: figure]
arm; base

metal bar

COMPLETED STEP

drive
