buzsakilab/3d_print_designs/Microdrives/Metal_recoverable/assembly_instructions_implantation_tool_metal_v10.pdf

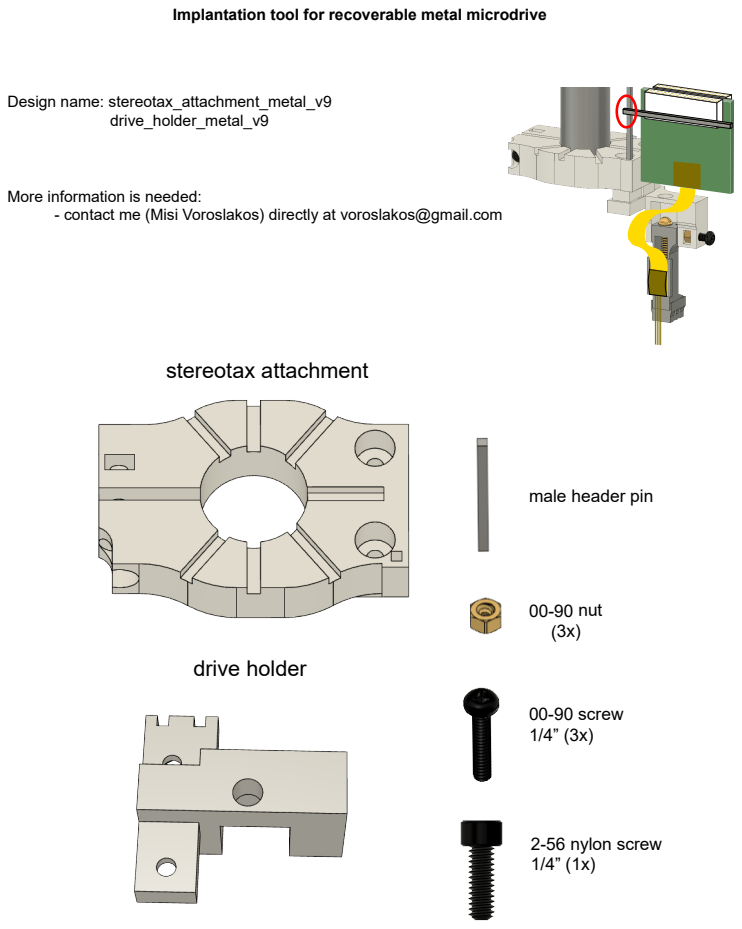
[picture p90: page 1]
Design name: stereotax_attachment_metal_v9 drive_holder_metal_v9; stereotax attachment; drive holder; 00-90 nut (3x); 00-90 screw 1/4” (3x); 2-56 nylon screw 1/4” (1x)

Implantation tool for recoverable metal microdrive

More information is needed:
- contact me (Misi Voroslakos) directly at voroslakos@gmail.com

male header pin

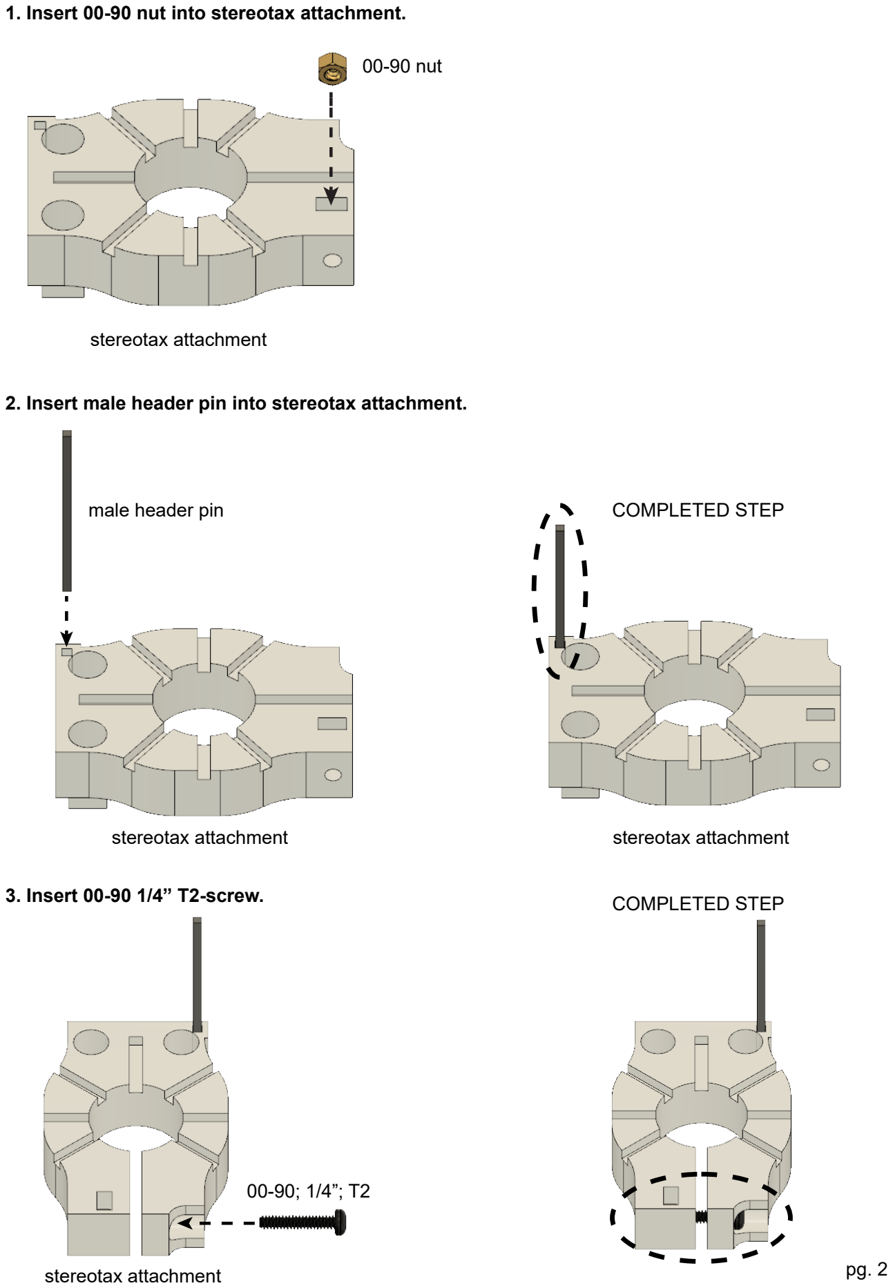
[picture p91: page 2]

00-90 nut

stereotax attachment

1. Insert 00-90 nut into stereotax attachment.

male header pin

stereotax attachment | stereotax attachment

COMPLETED STEP

2. Insert male header pin into stereotax attachment.

pg. 2

3. Insert 00-90 1/4” T2-screw.

stereotax attachment

00-90; 1/4”; T2

COMPLETED STEP

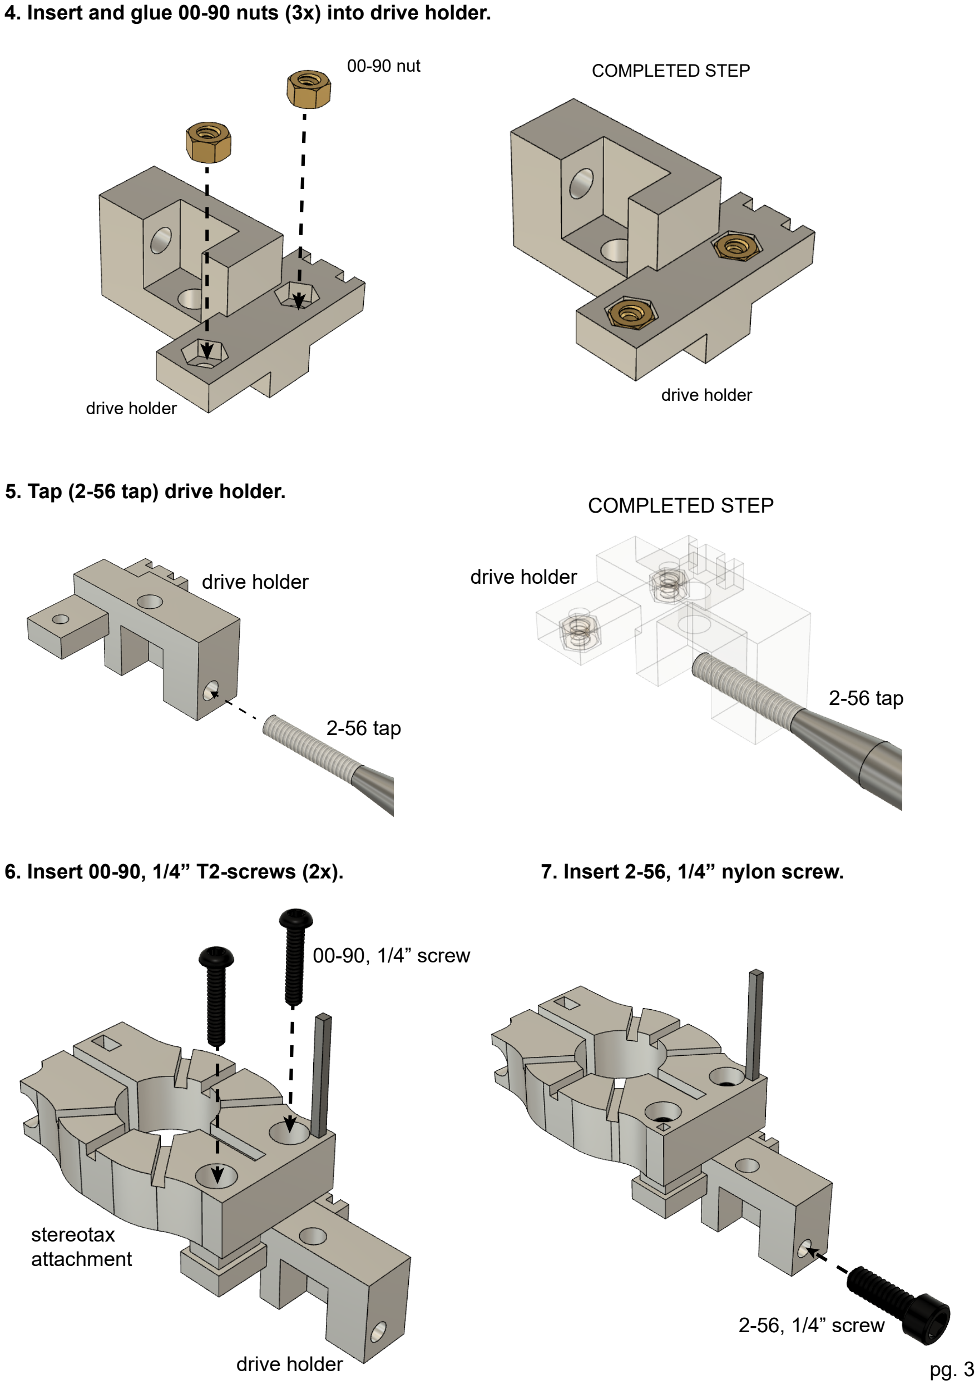
[picture p92: page 3]

00-90 nut

drive holder

drive holder

4. Insert and glue 00-90 nuts (3x) into drive holder.

COMPLETED STEP

5. Tap (2-56 tap) drive holder.

2-56 tap

2-56 tap

drive holder | drive holder

COMPLETED STEP

6. Insert 00-90, 1/4” T2-screws (2x). | 7. Insert 2-56, 1/4” nylon screw.

drive holder

00-90, 1/4” screw

2-56, 1/4” screw

stereotax
attachment

pg. 3
