buzsakilab/3d_print_designs/(threads)

Thread 1 (2024-01-20):

Rat cap 3D models should be updated

jiumao2, 2024-01-20:
We tried the rat cap 3D models and found that the rat_cap_top did not fit the M2 thumb screws.

We bought the rat cap 3D models from 3DNeuro and that rat_cap_top top performed well. There must be an updated version of this 3D model.

I would appreciate it if you could update the models on the GitHub.

petersenpeter, 2024-01-20:
Hi Yue

We will look into this. @misiVoroslakos can you help here? :-)

jiumao2, 2024-02-22:
Hi Petersen,

Any updates on this topic?

misiVoroslakos, 2024-02-22:
Hi Yue,

According to the naming convention, the proper top is uploaded to the Github. I am printing it now, to make sure that the holes are the correct size. Meanwhile, could you please let us know which printer, resin and resolution you tried to print this?

jiumao2, 2024-02-24:
Hi misiVoroslakos,

This one is from 3DNeuro:
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

This one is our print (we don't have a good printer and order the print from a company):
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

I saw a little difference between these two prints. So, I wondered whether you have updated your model to make the screw fit.

The other parts of my print performed well, and we adapted the top by widening the hole after printing. Maybe we should try smaller thumb screws as yours.

Thank you very much for your support!

Closed 2024-02-24.
