buzsakilab/3d_print_designs/Microdrives/Metal_recoverable/Known_printing_issues/drive_body_general_issue.pdf

2.2 mm

## width is around 2.23 mm

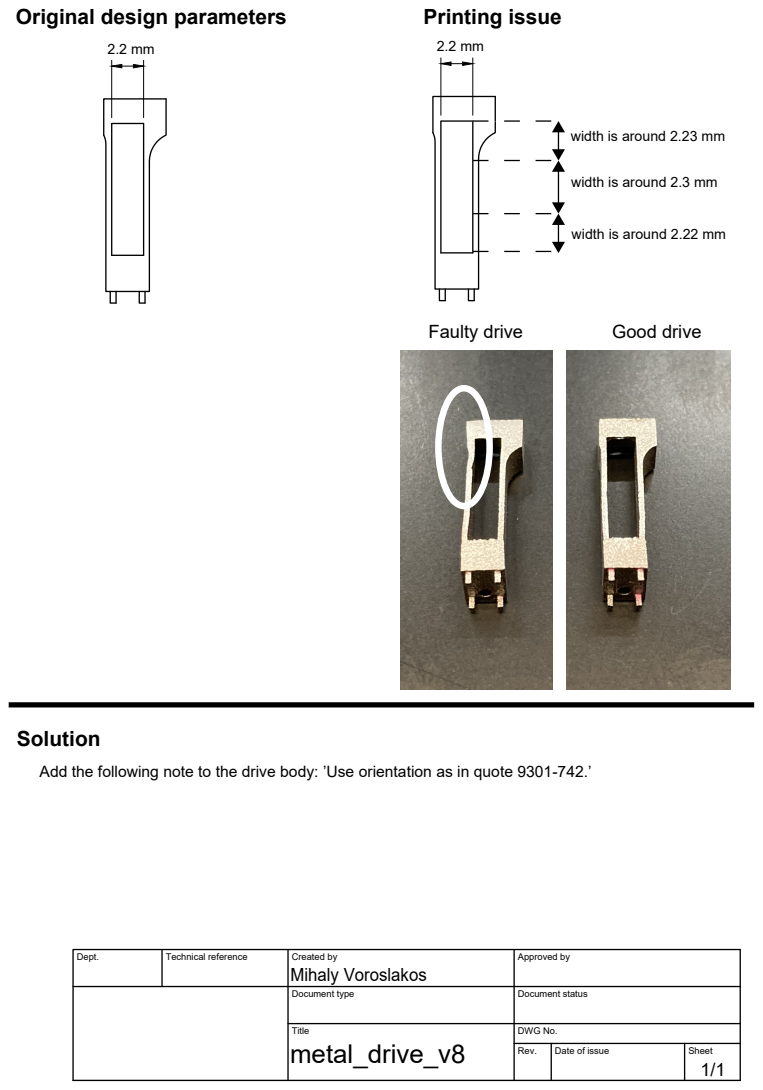
[picture p93: page 1]
Dept.; Technical reference; Created by; Approved by; Document type; Document status; Title; DWG No.; Rev.; Date of issue; Sheet; 1/1 metal_drive_v8; Mihaly Voroslakos; Original design parameters; Printing issue; Faulty drive; Good drive

width is around 2.3 mm

width is around 2.22 mm

Solution
Add the following note to the drive body: ’Use orientation as in quote 9301-742.’
