buzsakilab/3d_print_designs/Rat_cap/drawings/v8_to_v8_v2_256.pdf

v8 | v8_v2_256

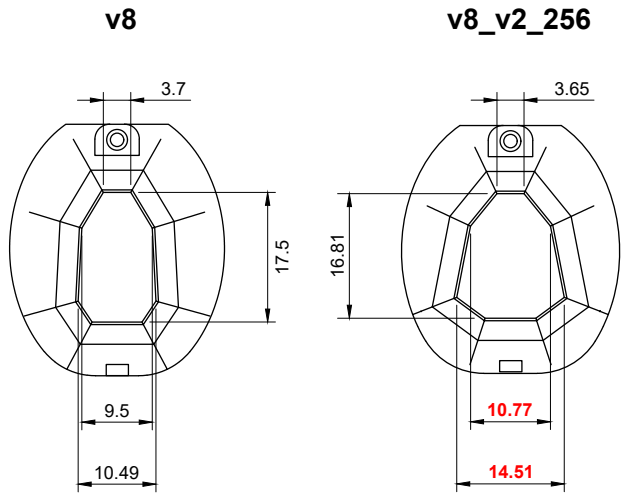
[picture p94: page 1]
