buzsakilab/3d_print_designs/(commit log)

2017-07-04 Uploaded 3D prints
    Rodent models, LED bars, Probe drives, rigid bodies for Optitrack
    [LED mount v4.stl, Rathat_skullbased.stl, Rathat_skullbased_thicker.stl, drive_base_v2.stl, drive_v2_1064um.ipt, drive_v2_1560um.ipt, magnet mounts v3 holder.stl, magnet mounts v3.stl]
2020-12-21 added cap and base designs
    [Hat base for rats.stl, Hat_for _mouse_inside_10.6mmx8.stl, Rathat_skullbased.stl, Rathat_skullbased_thicker.stl, arm.stl, arm_32ch_v21.stl, arm_64ch_v3_v21.stl, arm_v7_50um.step]
2020-12-21 added link to Assembly_instructions_mouse_base_plate
2020-12-25 renaming folder and files
    Replacing spaces with underscores
    [Hat base for rats.stl, Hat_for _mouse_inside_10.6mmx8.stl, LED mount v4.stl, magnet mounts v3 holder.stl, magnet mounts v3.stl, rigid_body_mice_Viktor.stl, rigid_body_rats.stl]
2021-01-06 Create Recoverable plastic microdrive and 3D-printed base plate system for rodent electrophysiology_v3 preprint.pdf
2021-02-21 Added metal prototype
    [arm_metal_prototype.stl, base20deg_metal_prototype.stl, base_metal_prototype.stl, drive_metal_prototype.stl, holder_metal_prototype.stl]
2021-02-22 added mouse_cap_v12
    [leftWall_v11.stl, left_wall_v12_L11.5mm_W10.00mm.stl, mouse_base_v11.stl, mouse_base_v12_L11.5mm_W10.00mm.stl, rightWall_v11.stl, right_wall_v12_L11.5mm_W10.00mm.stl]
2021-05-17 docu update on rodent models and renaming of stl files
2021-06-20 added v10
    [arm_neg100um_wneg10um_noNut_aluminum_v10.step, base_aluminum_v10.step, drive_holder_frontal_variation_01.stl, drive_holder_frontal_variation_02.stl, drive_holder_frontal_variation_03.stl, drive_v10.step, stereotax_attachment_metal_drive_v10.stl]
2022-03-03 updates for v10
    [arm_v10_aluminum_64ch.step, arm_v10_aluminum_NP1.0.step, base_v10_aluminum.step, drive_holder_metal_drive_v10.stl, drive_v10.step, stereotax_attachment_metal_drive_v10.stl]
2025-12-23 added v8_v2_256
    [rat_cap_base_v8.stl, rat_cap_base_v8_v2_256.stl, rat_cap_left_wall_v8.stl, rat_cap_left_wall_v8_v2_256.stl, rat_cap_right_wall_v8.stl, rat_cap_right_wall_v8_v2_256.stl, rat_cap_top_v8.stl]
2026-10-20 add long arm
